DanD222/moduleur/modules/README.md

# BEFORE YOU BUILD

👉 Make sure you read the full [build guide](https://github.com/shmoergh/moduleur/wiki) thoroughly before you start building the Moduleur.

# BOM

Each module has a dedicated BOM. We also created a full BOM if you want to order all modules at once:

- [Full BOM](https://docs.google.com/spreadsheets/d/1Qo4ZxYgp-tBQ1XDLqPfu5fhcQhO-8mitsnlWUWIVU-8/edit?usp=sharing) — Contains only the BOM for the modules. For the enclosure, check the [enclosure BOM](https://github.com/shmoergh/moduleur/blob/main/enclosure/enclosure-bom.csv).
- [Mouser cart](https://www.mouser.com/Tools/SavedCart/Share?AccessID=7d2d54395b) — Last update: 24 Jan 2026

---

### Recommended build order

1. [PSU](https://github.com/shmoergh/moduleur/tree/main/modules/01-psu)
2. [VCO](https://github.com/shmoergh/moduleur/tree/main/modules/02-vco)
3. [Mixer & sidechain compressor](https://github.com/shmoergh/moduleur/tree/main/modules/03-sidechain-mixer)
4. [VCF](https://github.com/shmoergh/moduleur/tree/main/modules/04-vcf)
5. [ADSR & VCA](https://github.com/shmoergh/moduleur/tree/main/modules/05-adsr-vca)
6. [Utils + Output](https://github.com/shmoergh/moduleur/tree/main/modules/06-utils-output)
7. [Brain](https://github.com/shmoergh/moduleur/tree/main/modules/07-brain)
8. [Default Patch](https://github.com/shmoergh/moduleur/tree/main/modules/08-default-patch)
