DanD222/moduleur/modules/08-default-patch/README.md

# Hog Moduleur / Default Patch

An optional passive PCB which connects the modules of the Shmøergh Moduleur. This essentially creates a default patch which makes the Moduleur playable without patch cables.

## How to Build

[**Follow the build guide &rarr;**](https://www.shmoergh.com/moduleur-build-guide)

<br>

## Module specific instructions

### 🐛 3D model bug in schematics

The current version of the 3D model has two bugs: 

1. It incorrectly uses dual row headers. Single row, **long** pin headers should be used on the BACK side of the PCB so that it can connect to the UI board through the holes on the Core board.
2. The side of the ADSR+VCA1, ADSR+VCA2 and UTILS pin headers are wrong. All pin headers should be soldered on the BACK side of the PCB.



<br>

## License

Open source licensed under [CC BY-NC 4.0](https://creativecommons.org/licenses/by-nc/4.0/).

Feel free to fork, build, and tweak.

[Disclaimer](https://github.com/shmoergh/moduleur/blob/main/DISCLAIMER.md)

## Latest module version

v1.0
