DanD222/moduleur/modules/01-psu/electronics/production/bom.csv

Designator | Footprint | Quantity | Value | LCSC Part #
D1, D3, D4 | LED_D3.0mm | 3 | LED
D2 | D_DO-201AD_P15.24mm_Horizontal | 1 | 1N5822
D5 | D_DO-201AE_P15.24mm_Horizontal | 1 | 1.5KE36A
IC1 | Converter_DCDC_MeanWell_NSD10_DKMW_THT | 1 | ISOLATED_DC-DC_CONV
J1 | BarrelJack_Wuerth_6941xx301002 | 1 | Barrel_Jack_Switch
J2, J3, J4, J5 | IDC-Header_2x08_P2.54mm_Horizontal | 4 | Conn_02x08_Odd_Even
JP1 | SolderJumper-2_P1.3mm_Open_RoundedPad1.0x1.5mm | 1 | Jumper_2_Open
R1, R2, R3 | R_Axial_DIN0207_L6.3mm_D2.5mm_P7.62mm_Horizontal | 3 | 1k
S1 | SW_PB400EEQR1BLK | 1 | PB400EEQR1BLK
