DanD222/moduleur/modules/01-psu/electronics/schematics/psu.pdf

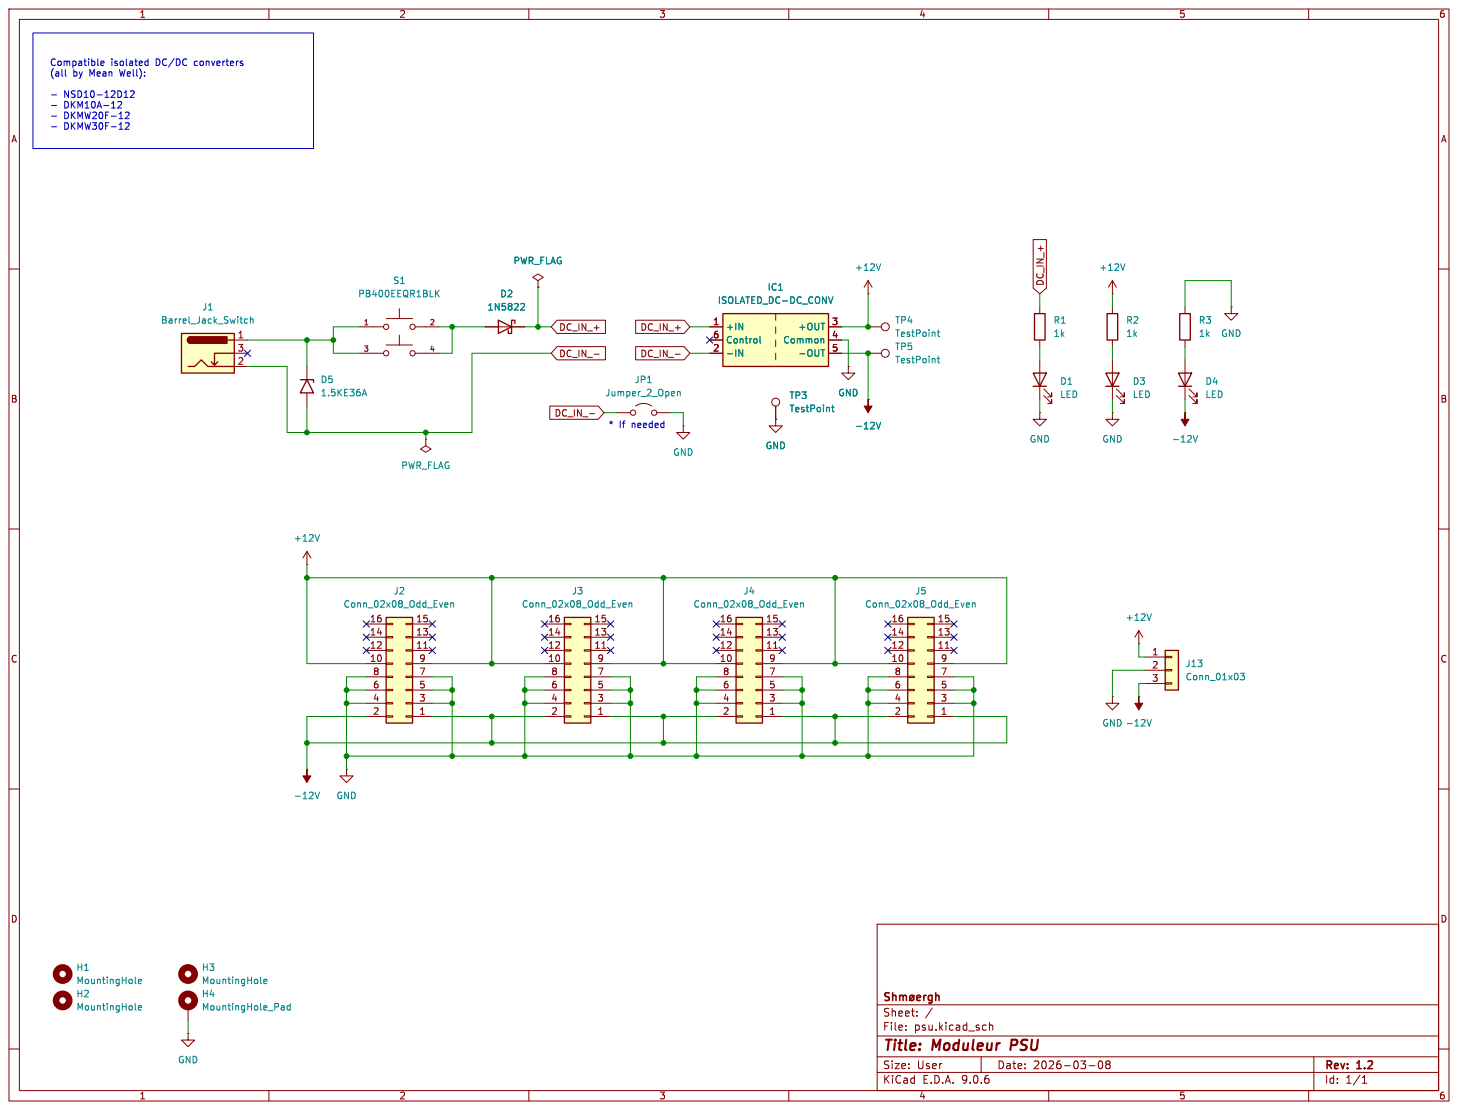
[picture p1: page 1]

(all by Mean Well): - NSD10-12D12

File: psu.kicad_sch Sheet: / þÿShmøergh

Id: 1/1 Title: Moduleur PSU
