DanD222/moduleur/modules/02-vco/electronics/core/schematics/vco-core.pdf

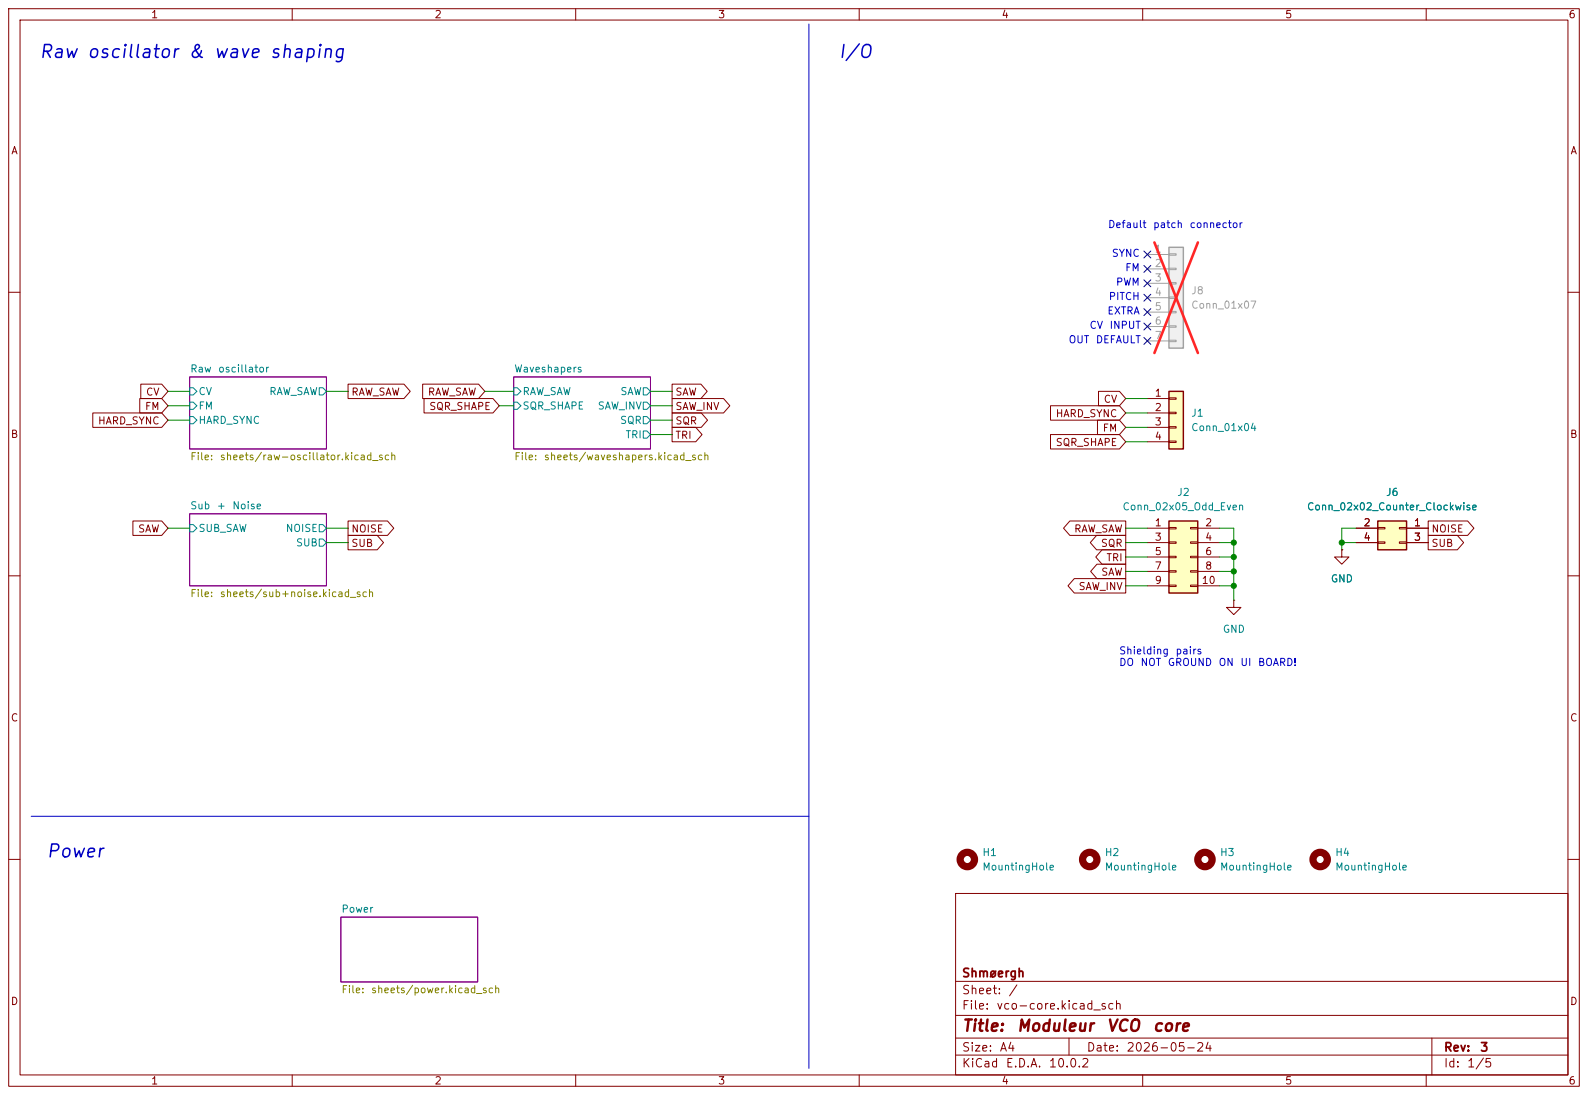
[picture p2: page 1]

TRI Waveshapers File: sheets/waveshapers.kicad_sch

File: sheets/sub+noise.kicad_sch Power File: sheets/power.kicad_sch

Shmøergh
Sheet: /
File: vco-core.kicad_sch
Title: Moduleur VCO core

Size: A4 | Rev: 3
KiCad E.D.A. 10.0.2 | Id: 1/5

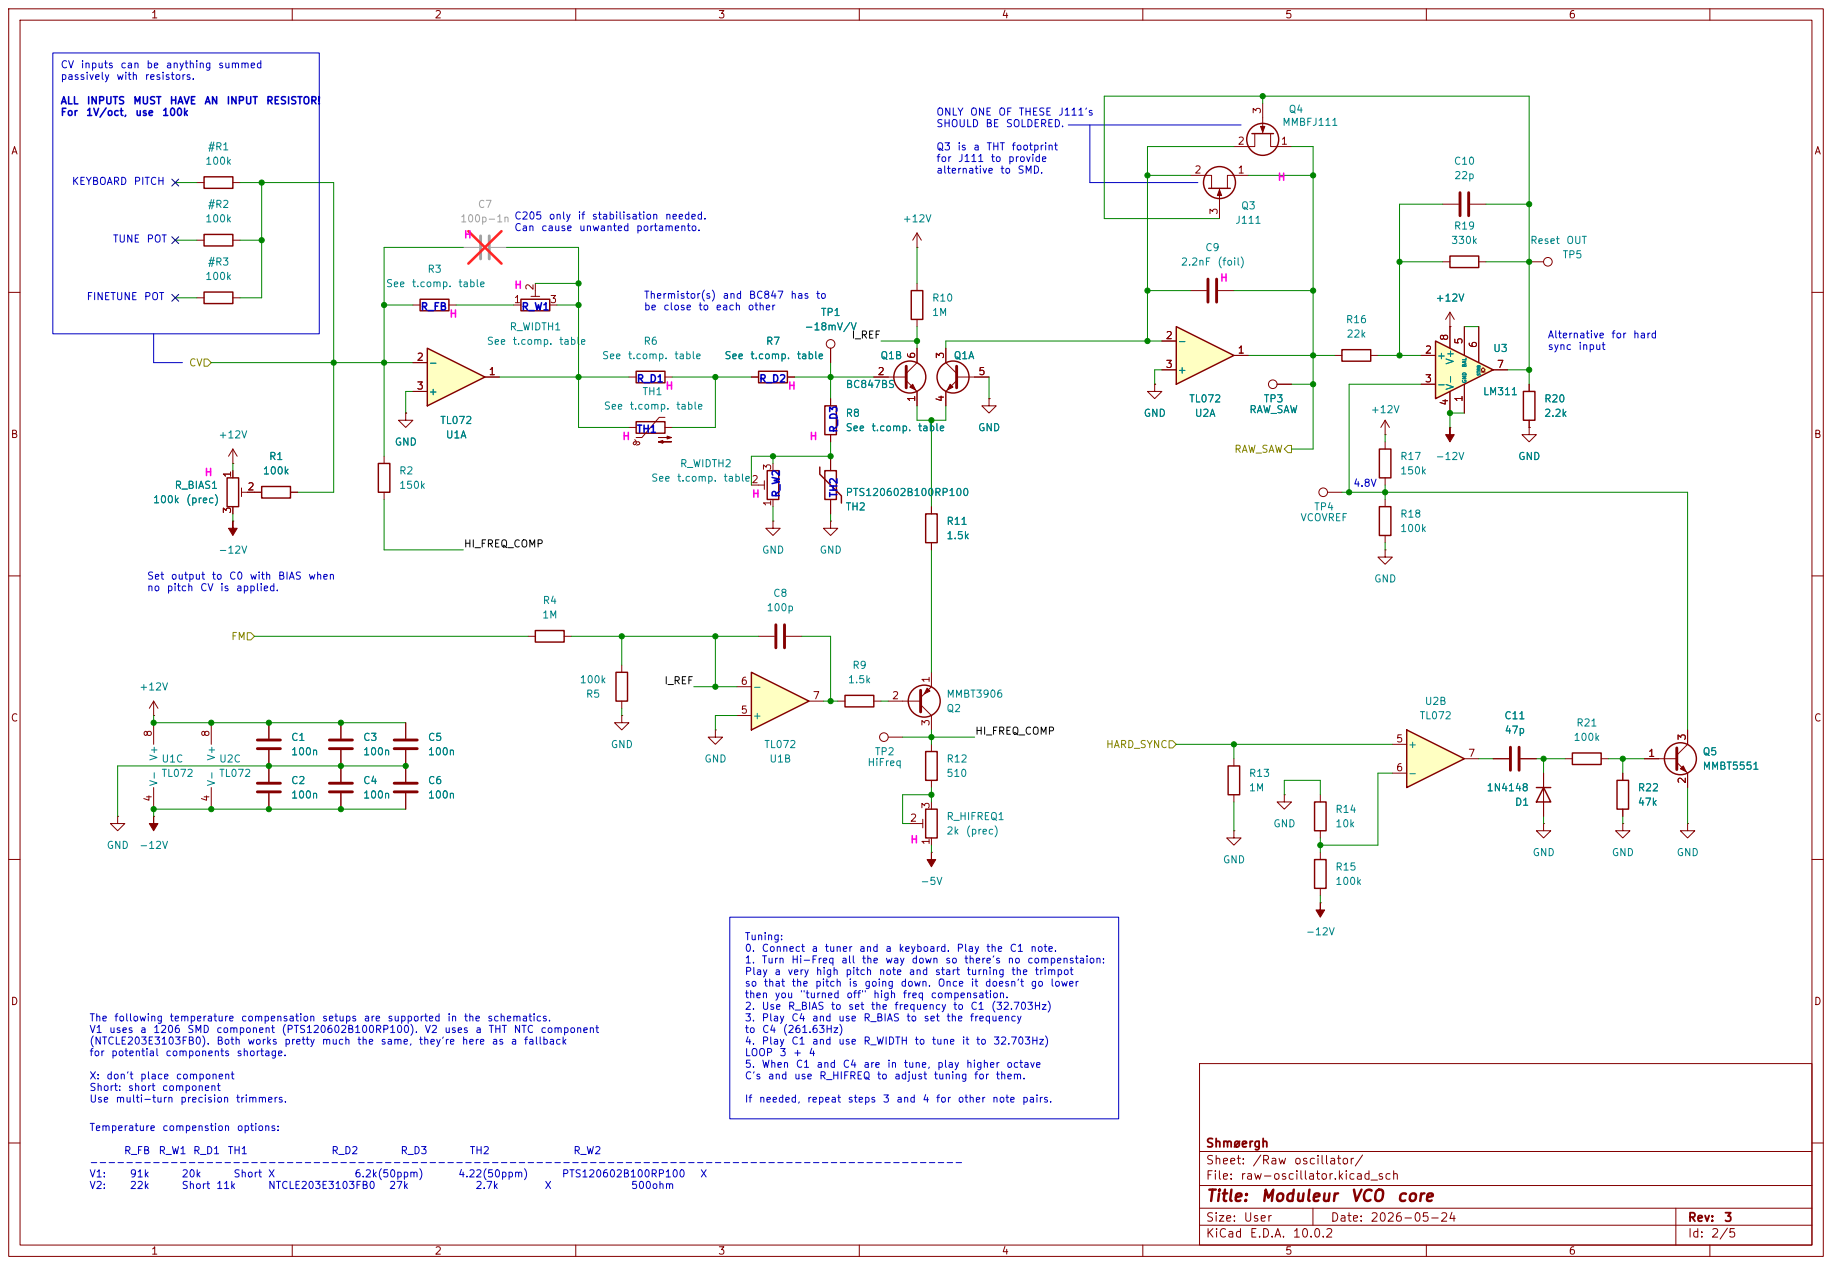
[picture p3: page 2]

TUNE POT ALL INPUTS MUST HAVE AN INPUT RESISTOR! For 1V/oct, use 100k

3Q4 MMBFJ111 R10
ONLY ONE OF THESE J111's SHOULD BE SOLDERED. Q3 is a THT footprint

C205 only if stabilisation needed. Can cause unwanted portamento.

Thermistor(s) and BC847 has to be close to each other Set output to C0 with BIAS when

See t.comp. table GND

Tuning: 0. Connect a tuner and a keyboard. Play the C1 note. 1. Turn Hi-Freq all the way down so there's no compenstaion:

Play a very high pitch note and start turning the trimpot so that the pitch is going down. Once it doesn't go lower

then you "turned off" high freq compensation. 2. Use R_BIAS to set the frequency to C1 (32.703Hz) 3. Play C4 and use R_BIAS to set the frequency

The following temperature compensation setups are supported in the schematics. V1 uses a 1206 SMD component (PTS120602B100RP100). V2 uses a THT NTC component

to C4 (261.63Hz) 4. Play C1 and use R_WIDTH to tune it to 32.703Hz) LOOP 3 + 4

(NTCLE203E3103FB0). Both works pretty much the same, they're here as a fallback
for potential components shortage. X: don't place component Short: short component Use multi-turn precision trimmers.

5. When C1 and C4 are in tune, play higher octave C's and use R_HIFREQ to adjust tuning for them.

If needed, repeat steps 3 and 4 for other note pairs.

Shmøergh
Sheet: /Raw oscillator/
File: raw-oscillator.kicad_sch
Title: Moduleur VCO core

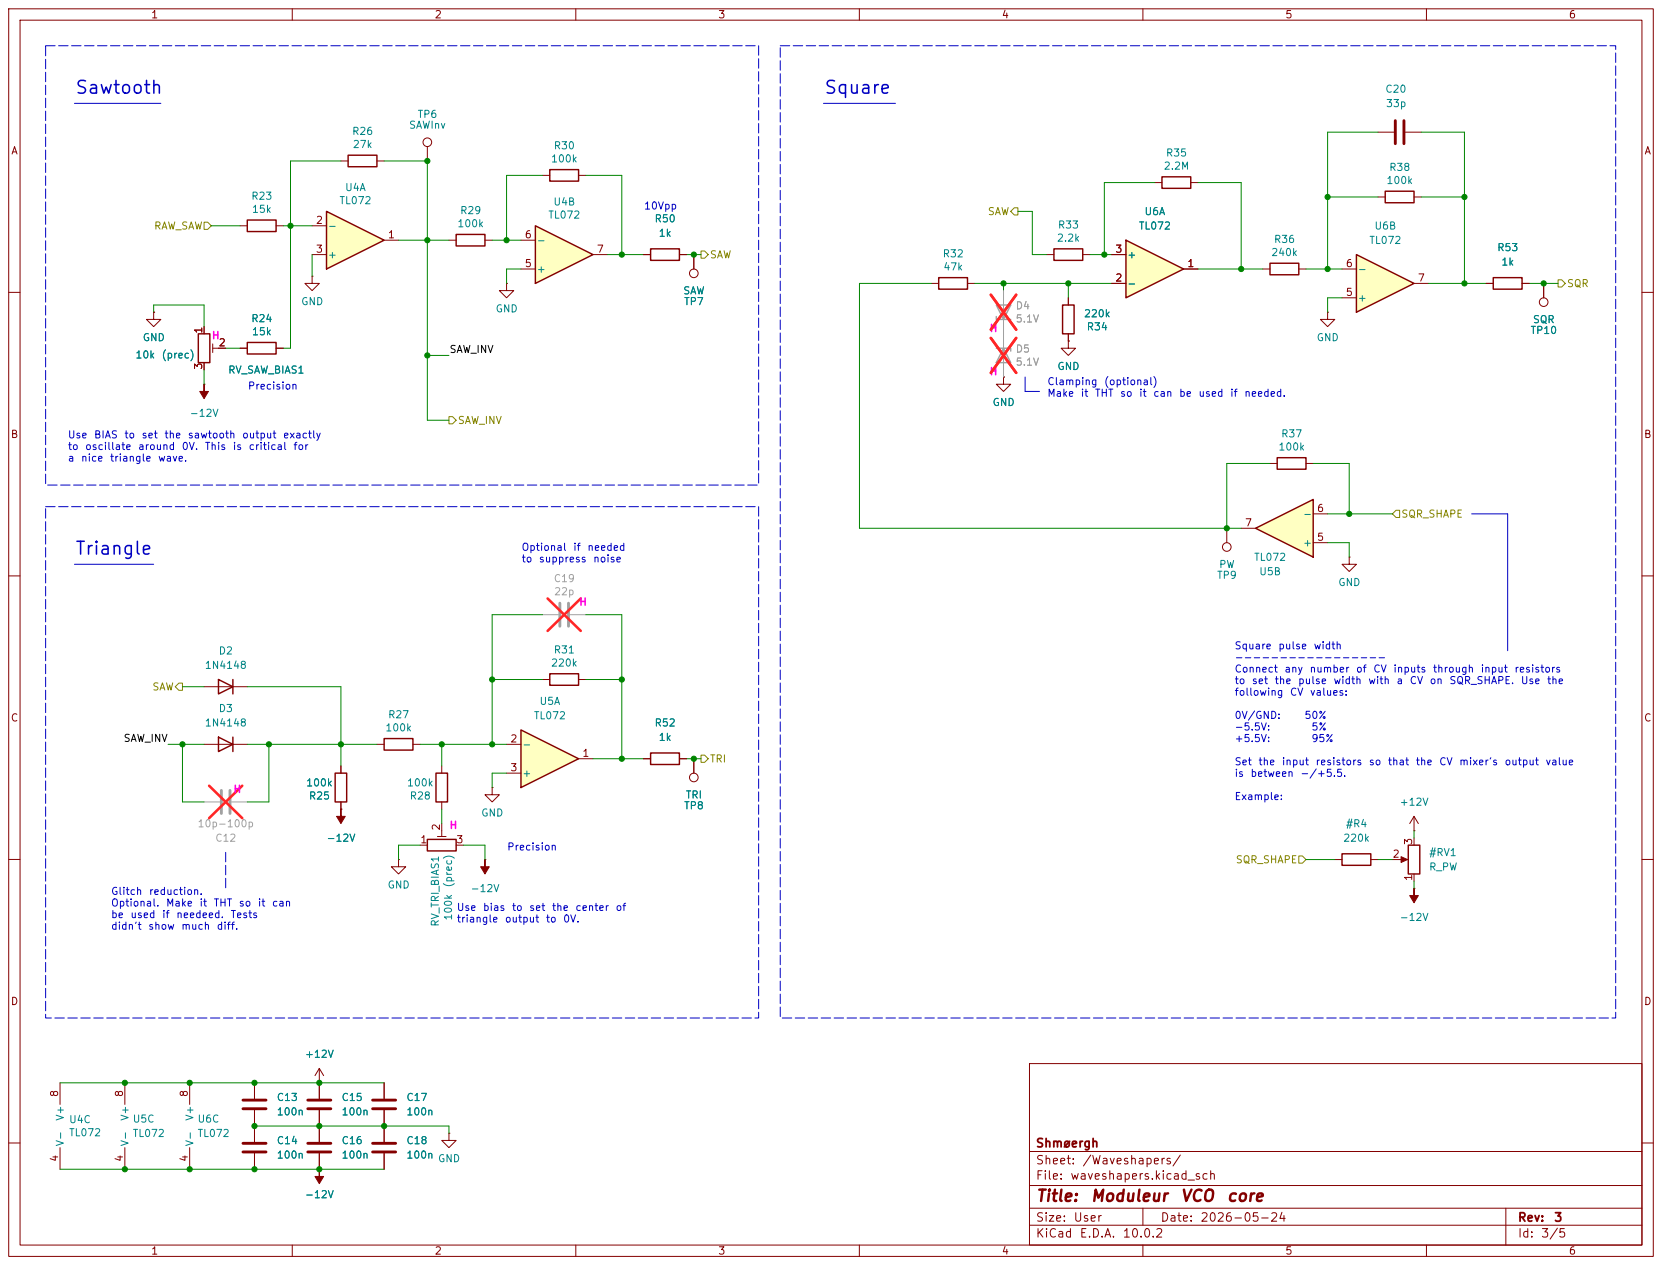
[picture p4: page 3]

Clamping (optional) Make it THT so it can be used if needed. Square pulse width -----------------

Use BIAS to set the sawtooth output exactly

Connect any number of CV inputs through input resistors
to set the pulse width with a CV on SQR_SHAPE. Use the

Set the input resistors so that the CV mixer's output value
is between -/+5.5.

Use bias to set the center of
triangle output to 0V.

Shmøergh
Sheet: /Waveshapers/
File: waveshapers.kicad_sch
Title: Moduleur VCO core

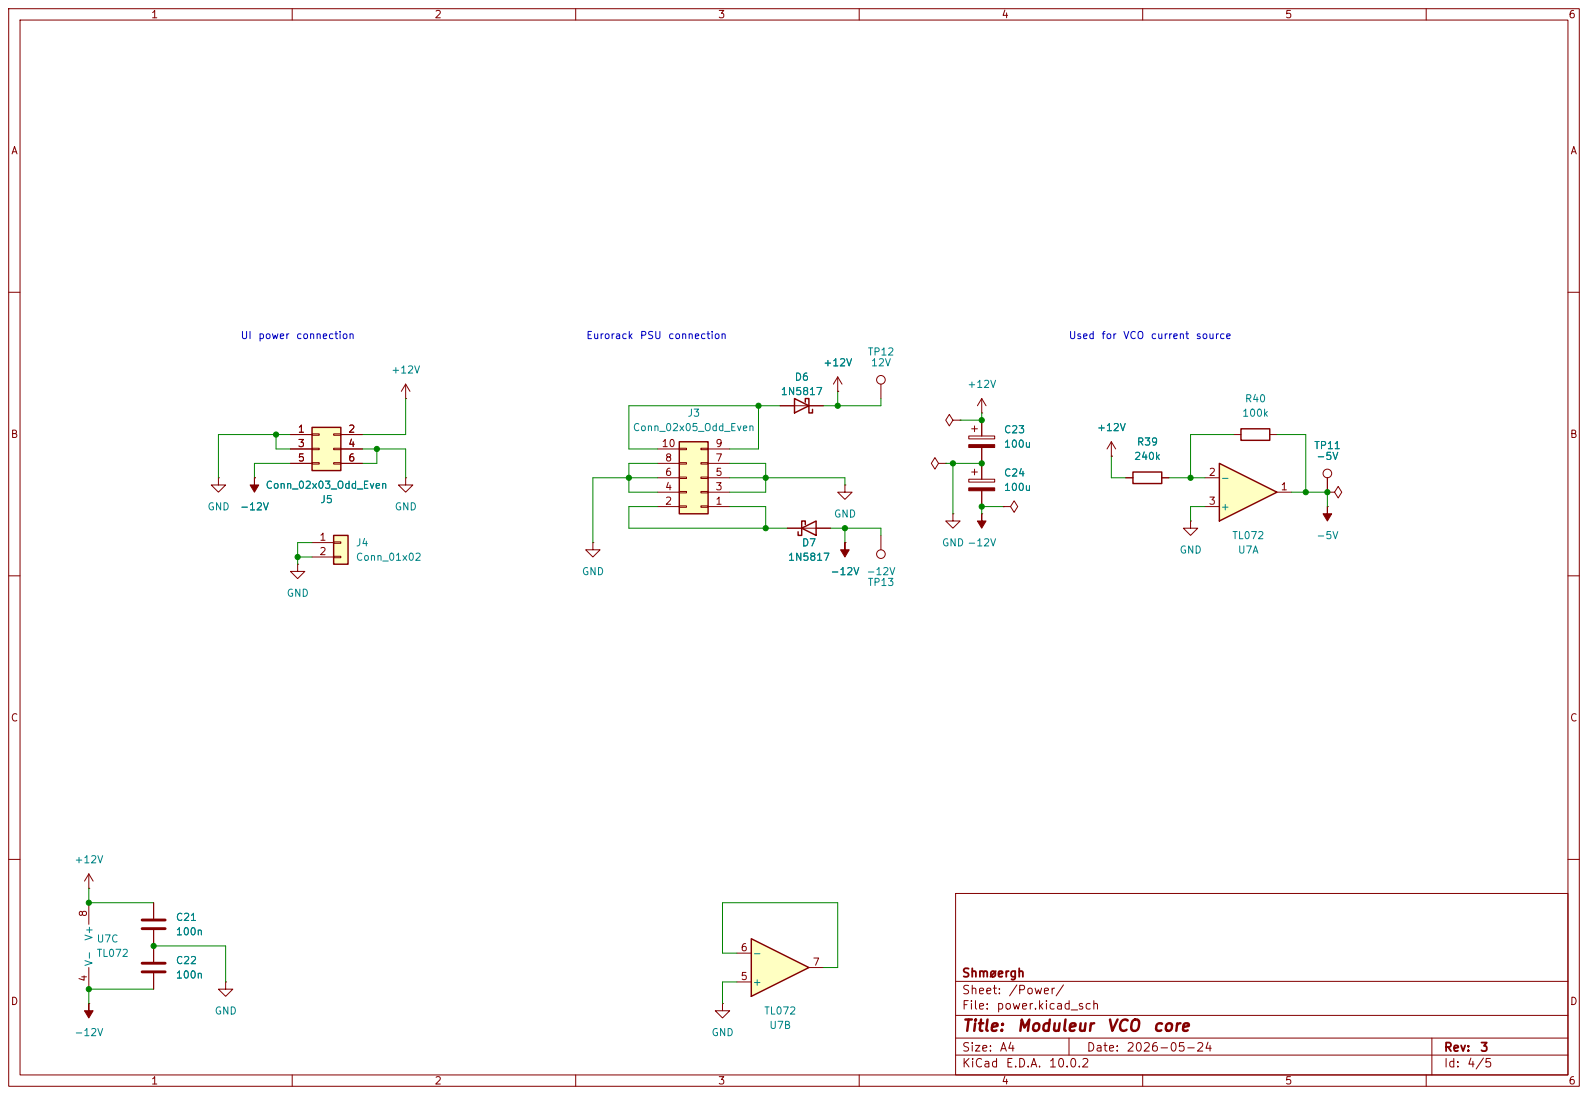
[picture p5: page 4]

Sheet: /Power/
File: power.kicad_sch
Title: Moduleur VCO core

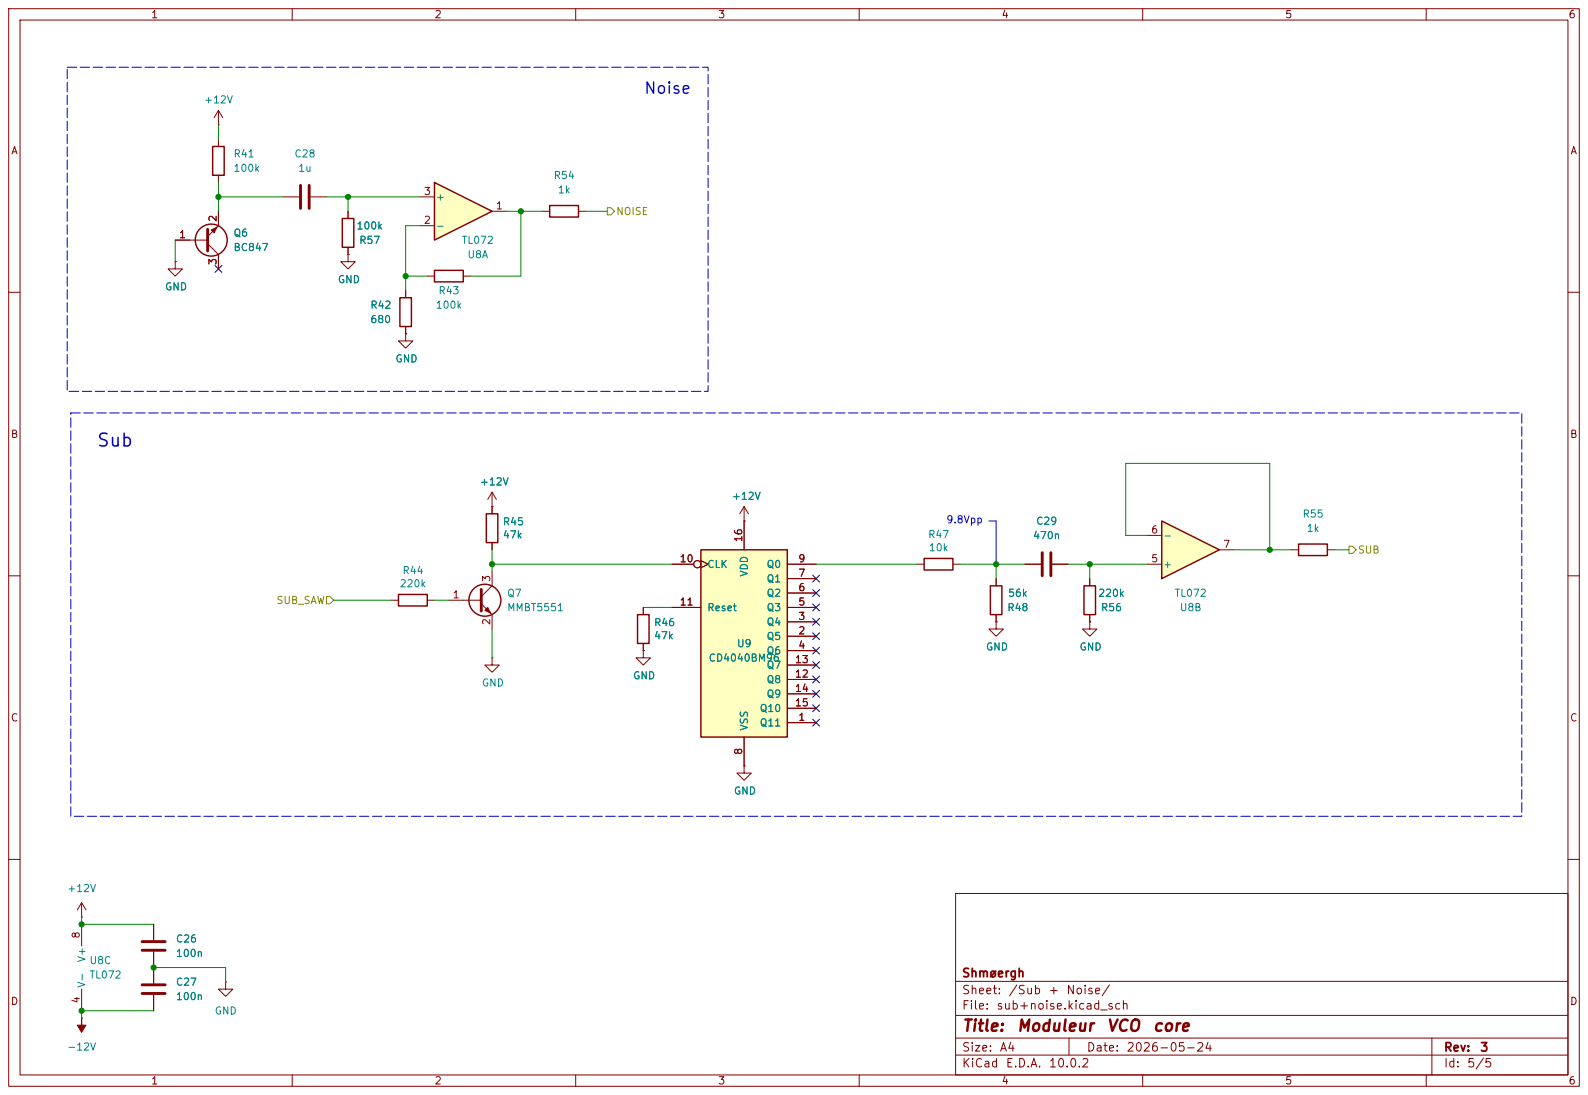
[picture p6: page 5]

8 Q0 9 CLK 10 Reset 11 Q8 12 Q7 13 Q9 14 Q10 15 VDD 16 +12V GND

Shmøergh
Sheet: /Sub + Noise/
File: sub+noise.kicad_sch
Title: Moduleur VCO core
