DanD222/moduleur/modules/04-vcf/electronics/core/schematics/vcf-core.pdf

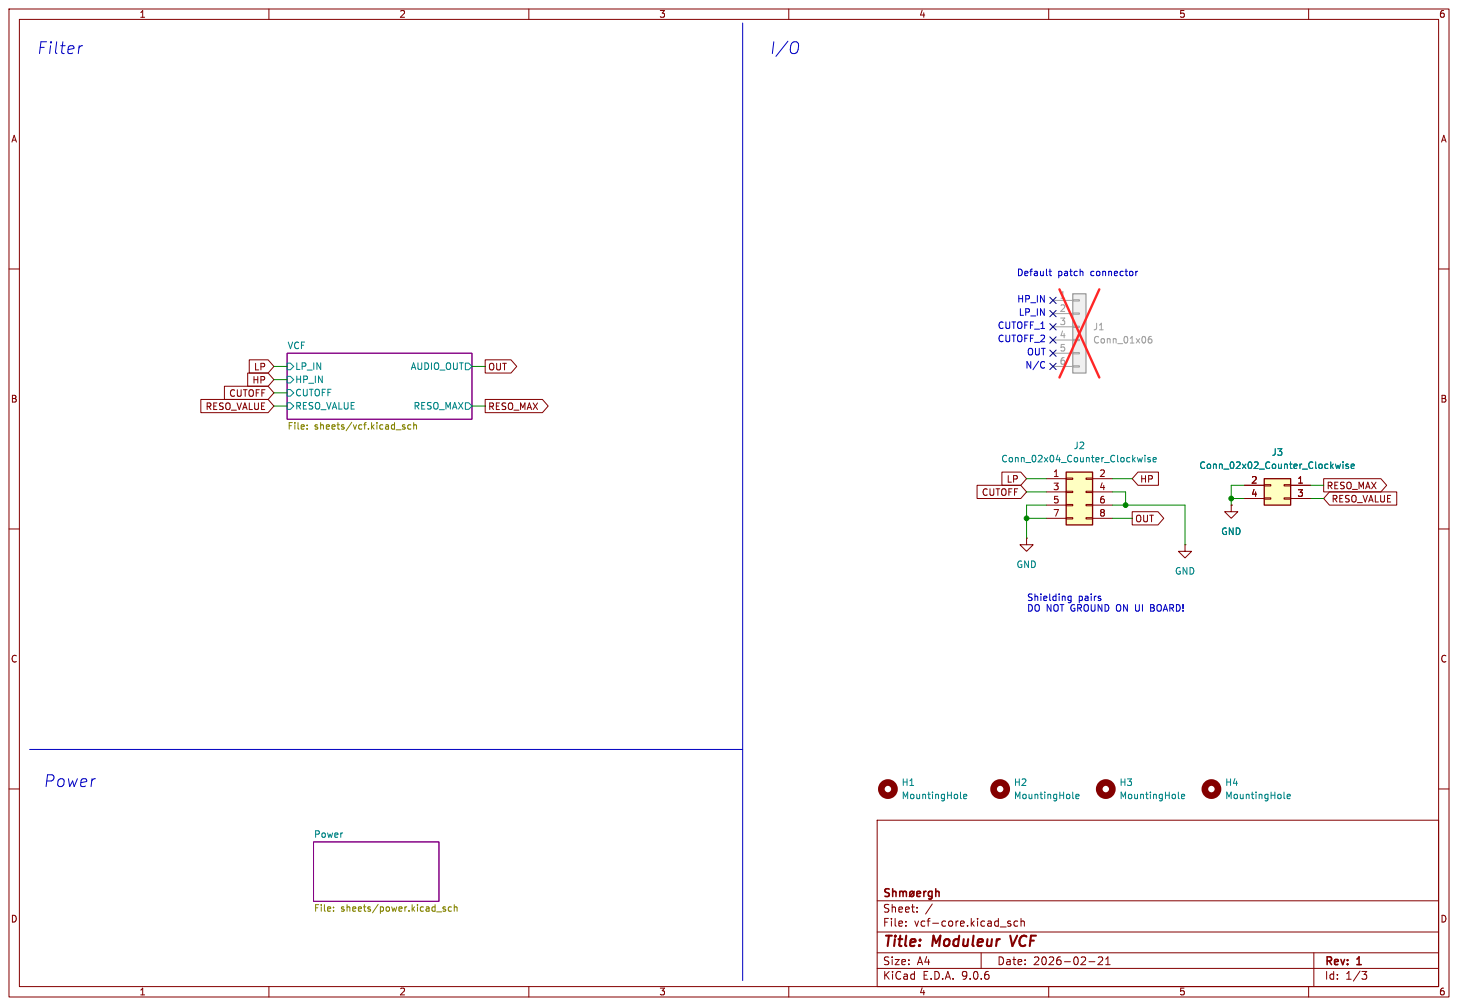
[picture p12: page 1]

Default patch connector Power

Power File: sheets/power.kicad_sch

File: vcf-core.kicad_sch Sheet: / þÿShmøergh

Id: 1/3 Title: Moduleur VCF

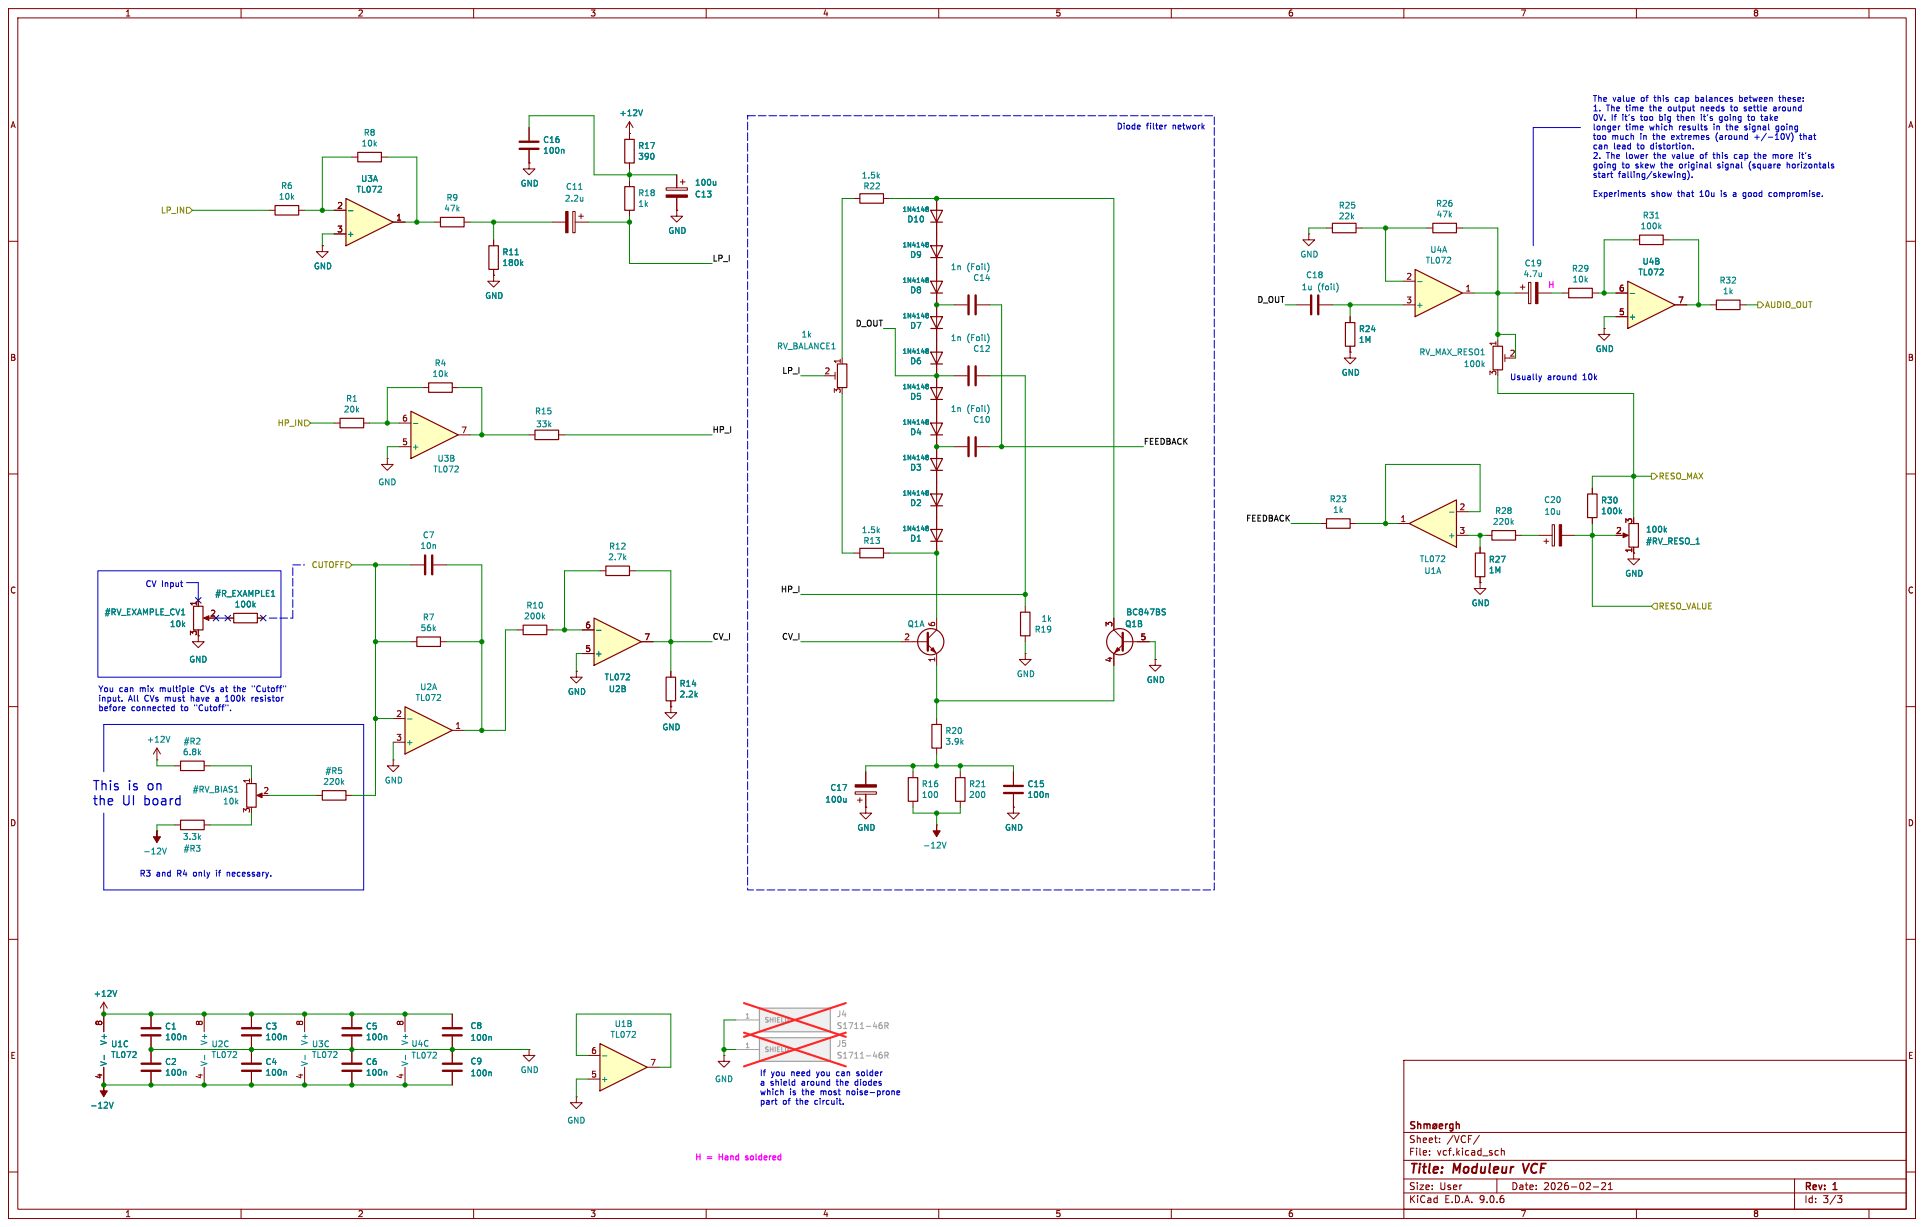
[picture p13: page 2]

0V. If it's too big then it's going to take
longer time which results in the signal going

Usually around 10k This is on

File: vcf.kicad_sch Sheet: /VCF/ þÿShmøergh C15

If you need you can solder a shield around the diodes which is the most noise-prone

part of the circuit.

Id: 3/3 Title: Moduleur VCF

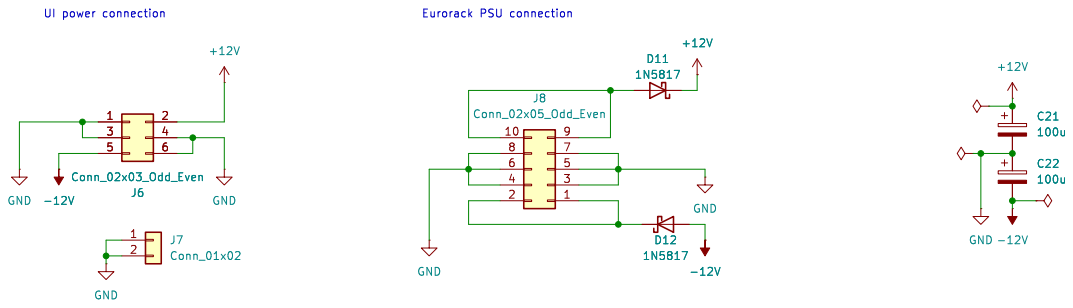
[picture p14: page 3]

Id: 4/3 Title: Moduleur VCF
