DanD222/moduleur/modules/04-vcf/electronics/ui/schematics/vcf-ui.pdf

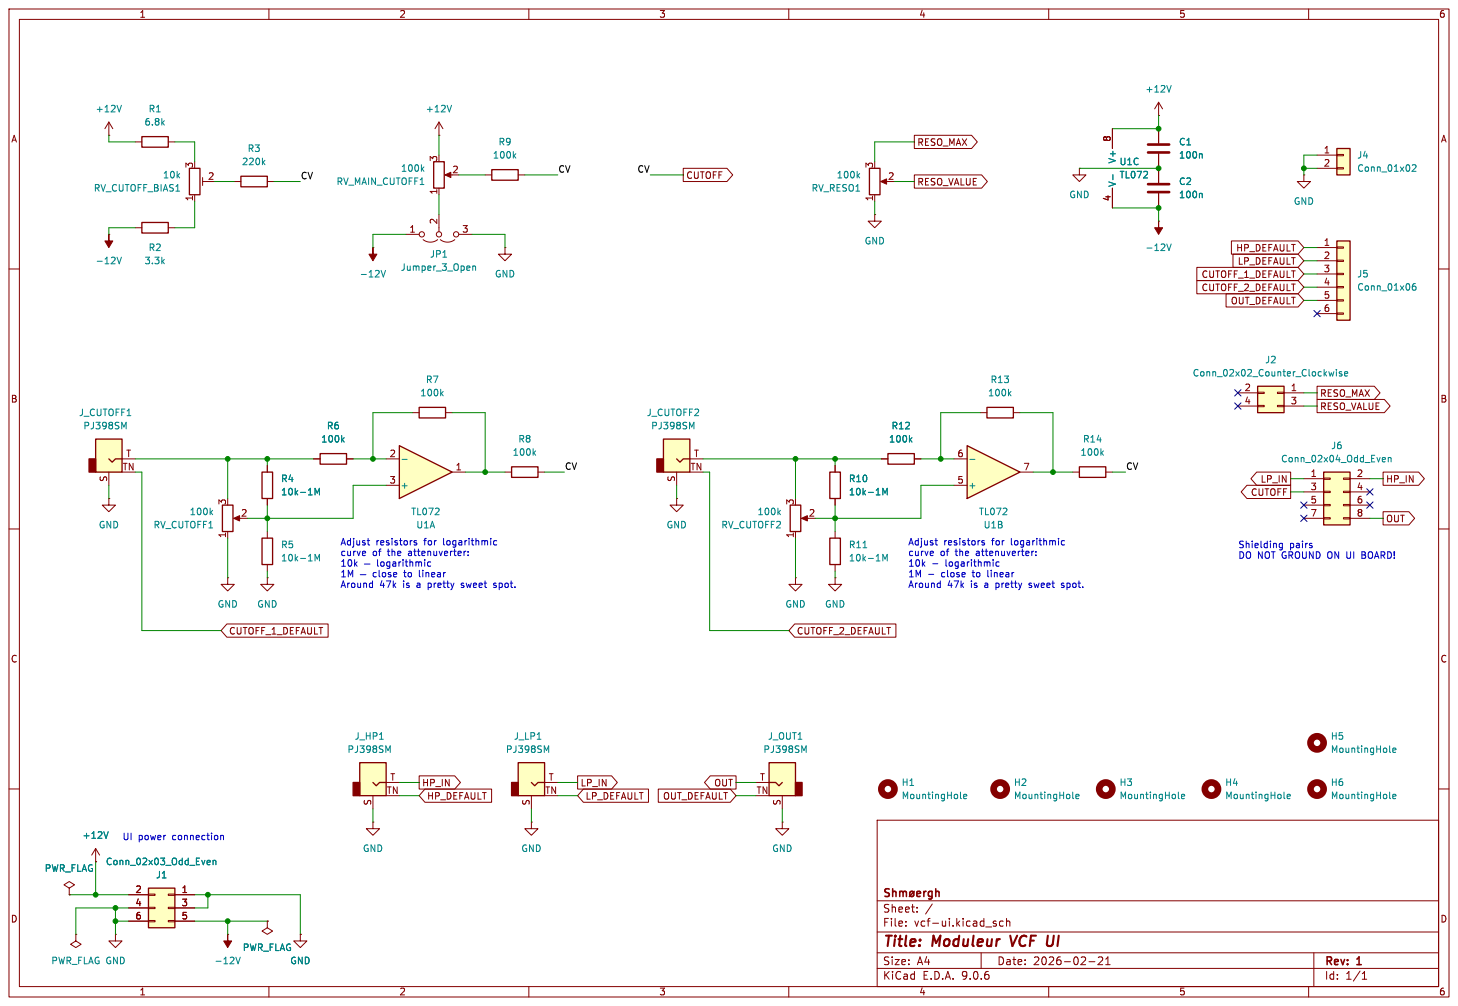
[picture p15: page 1]

curve of the attenuverter: 10k þÿ logarithmic 1M þÿ close to linear Around 47k is a pretty sweet spot. R4

Id: 1/1 Title: Moduleur VCF UI File: vcf-ui.kicad_sch Sheet: / þÿShmøergh GND
