DanD222/moduleur/modules/05-adsr-vca/electronics/core/schematics/adsr-vca-core.pdf

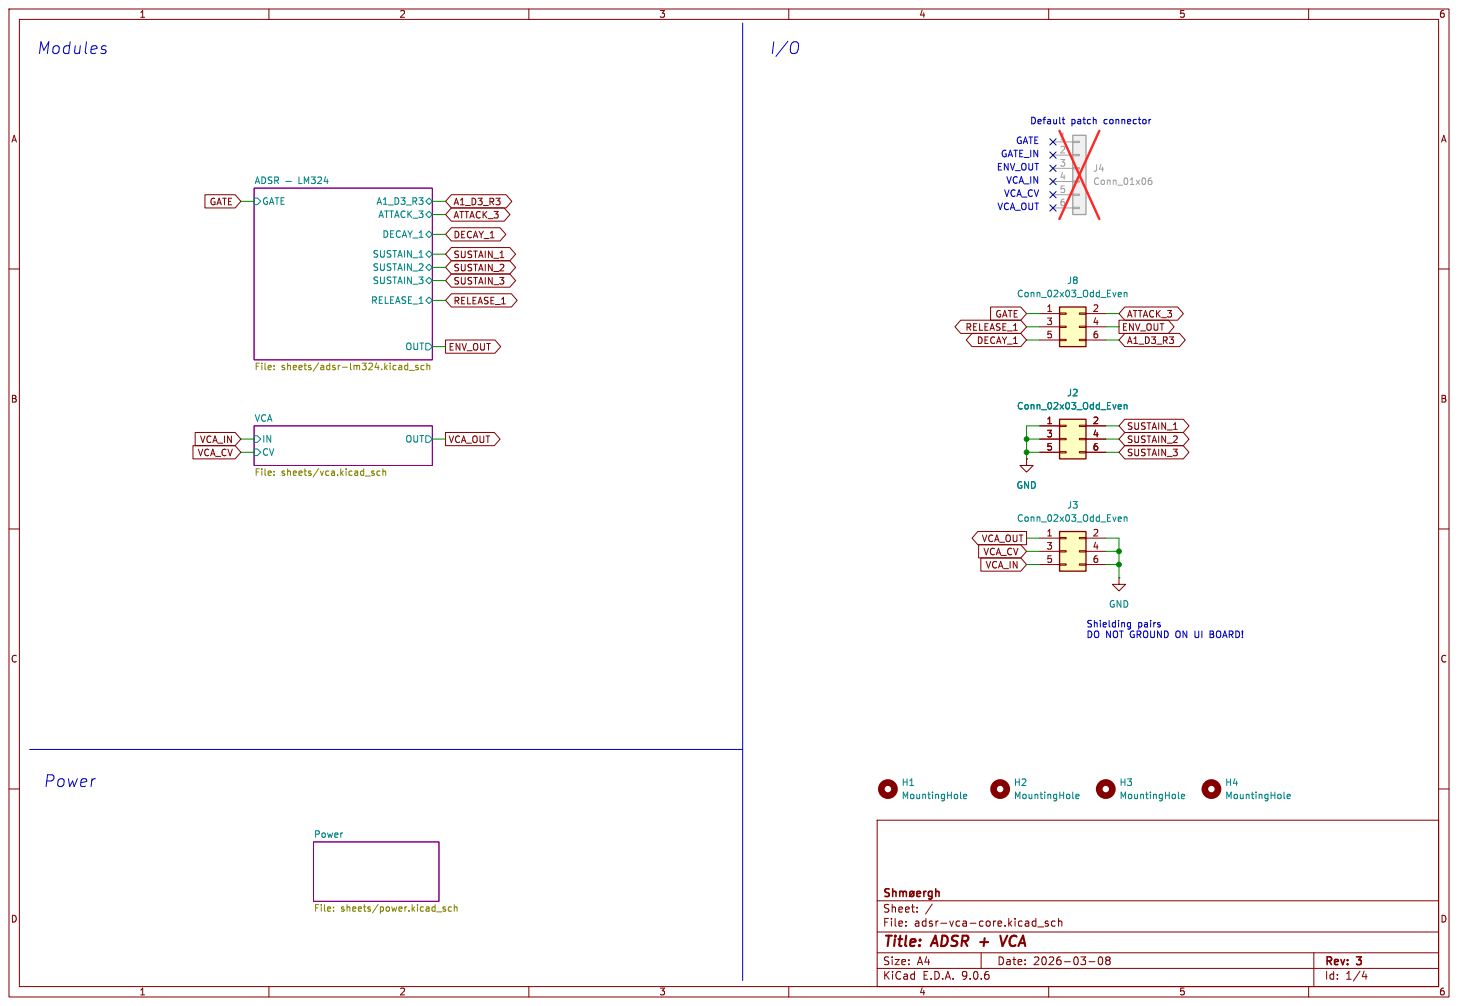
[picture p16: page 1]

File: sheets/vca.kicad_sch Power File: sheets/power.kicad_sch

File: adsr-vca-core.kicad_sch Sheet: / þÿShmøergh CV

Id: 1/4 Title: ADSR + VCA

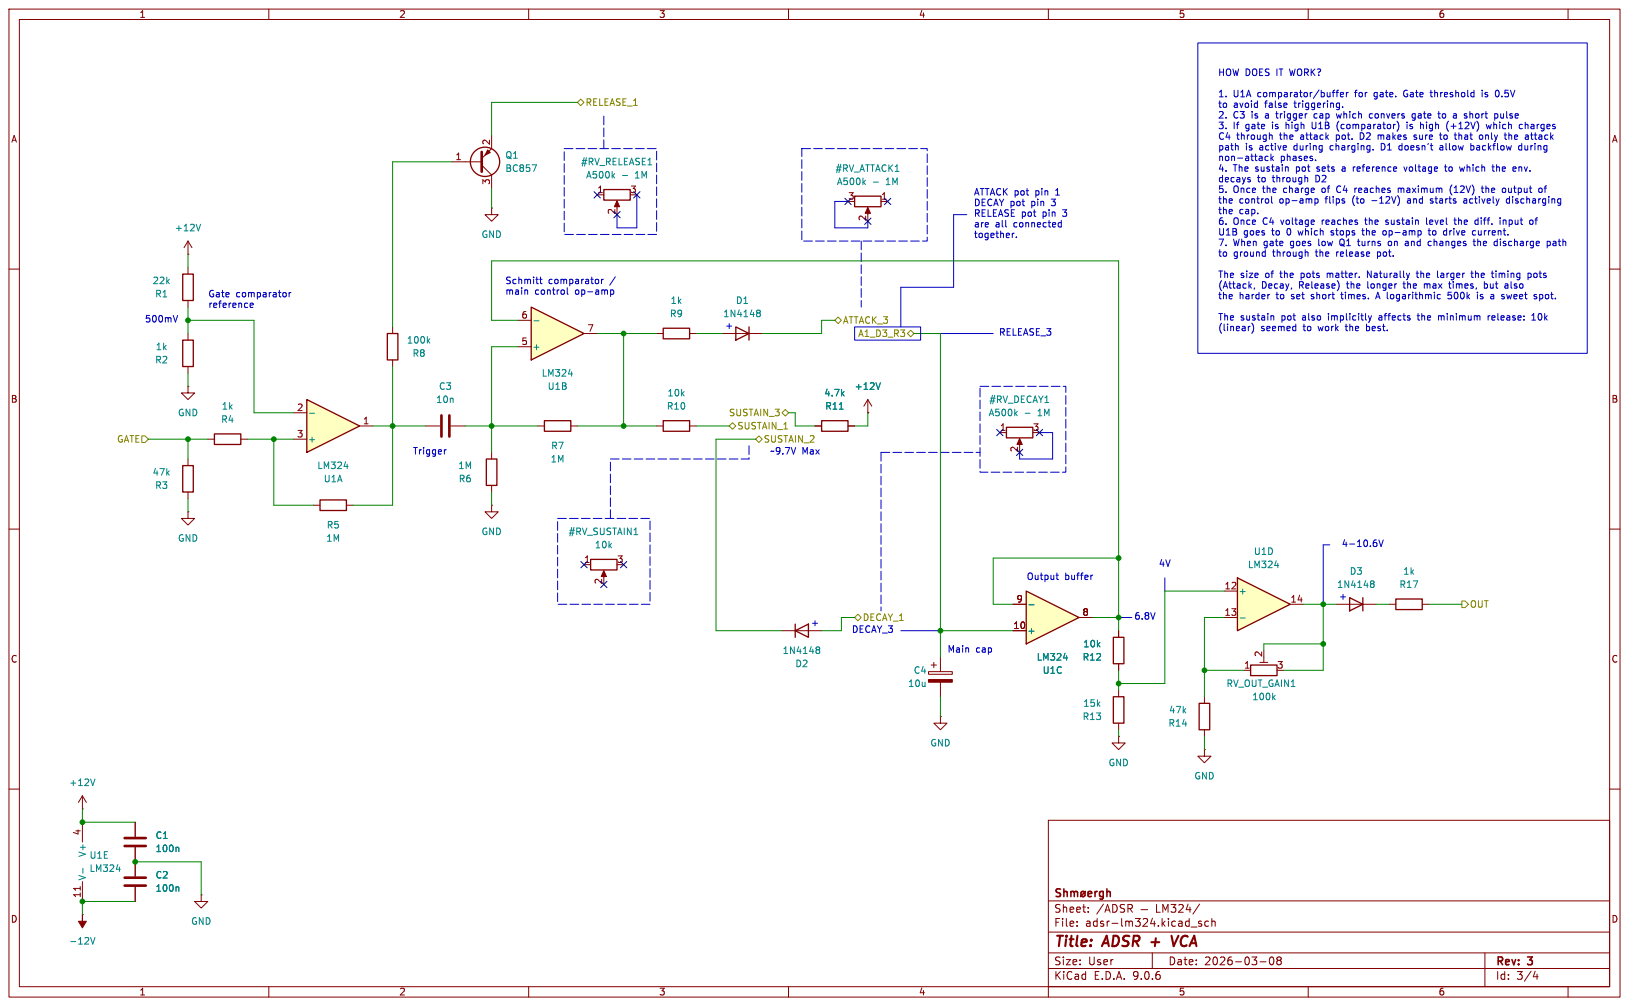
[picture p17: page 2]

HOW DOES IT WORK?
together. DECAY_3

to avoid false triggering. 2. C3 is a trigger cap which convers gate to a short pulse

(Attack, Decay, Release) the longer the max times, but also

Id: 3/4 Title: ADSR + VCA

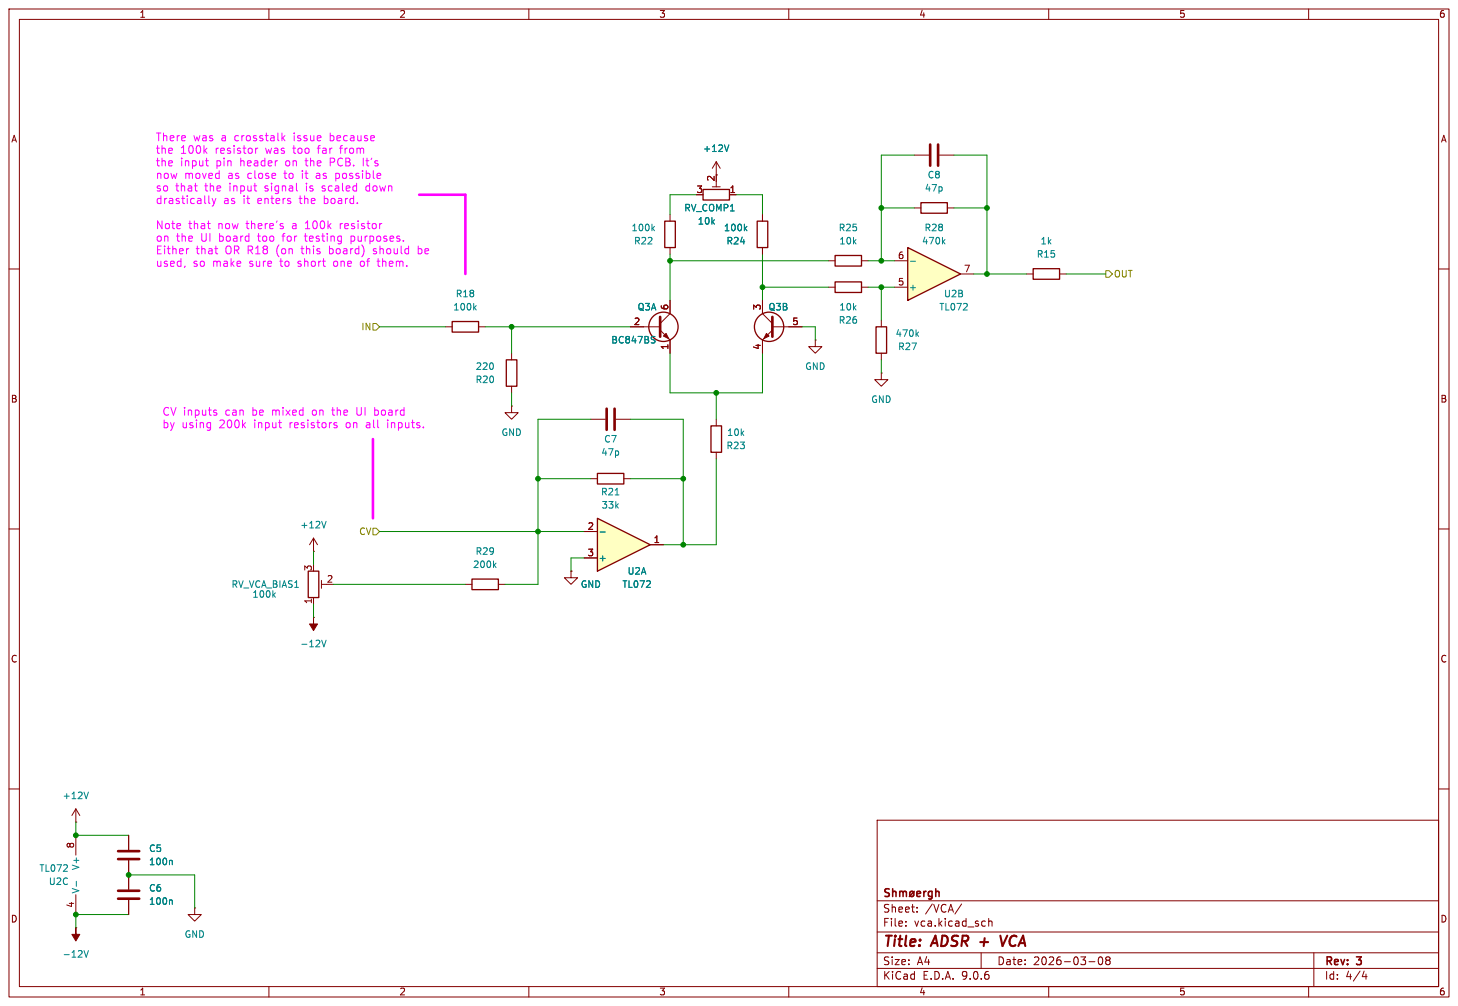
[picture p18: page 3]

File: vca.kicad_sch Sheet: /VCA/ þÿShmøergh GND

used, so make sure to short one of them. CV inputs can be mixed on the UI board

Id: 4/4 Title: ADSR + VCA

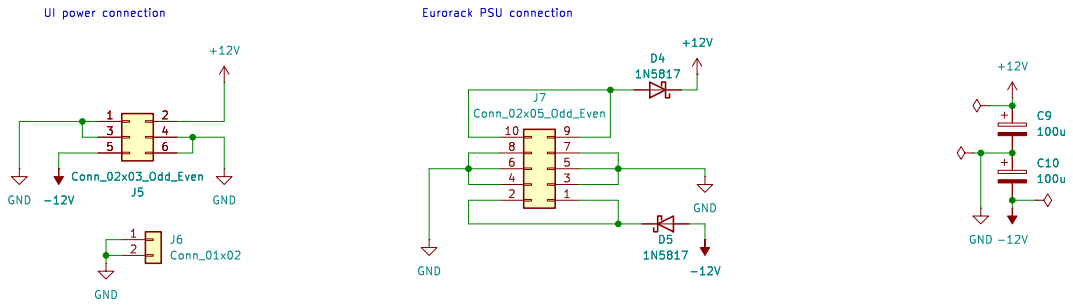
[picture p19: page 4]

Id: 4/4 Title: ADSR + VCA
