DanD222/moduleur/modules/06-utils-output/electronics/core/schematics/utils-output-core.pdf

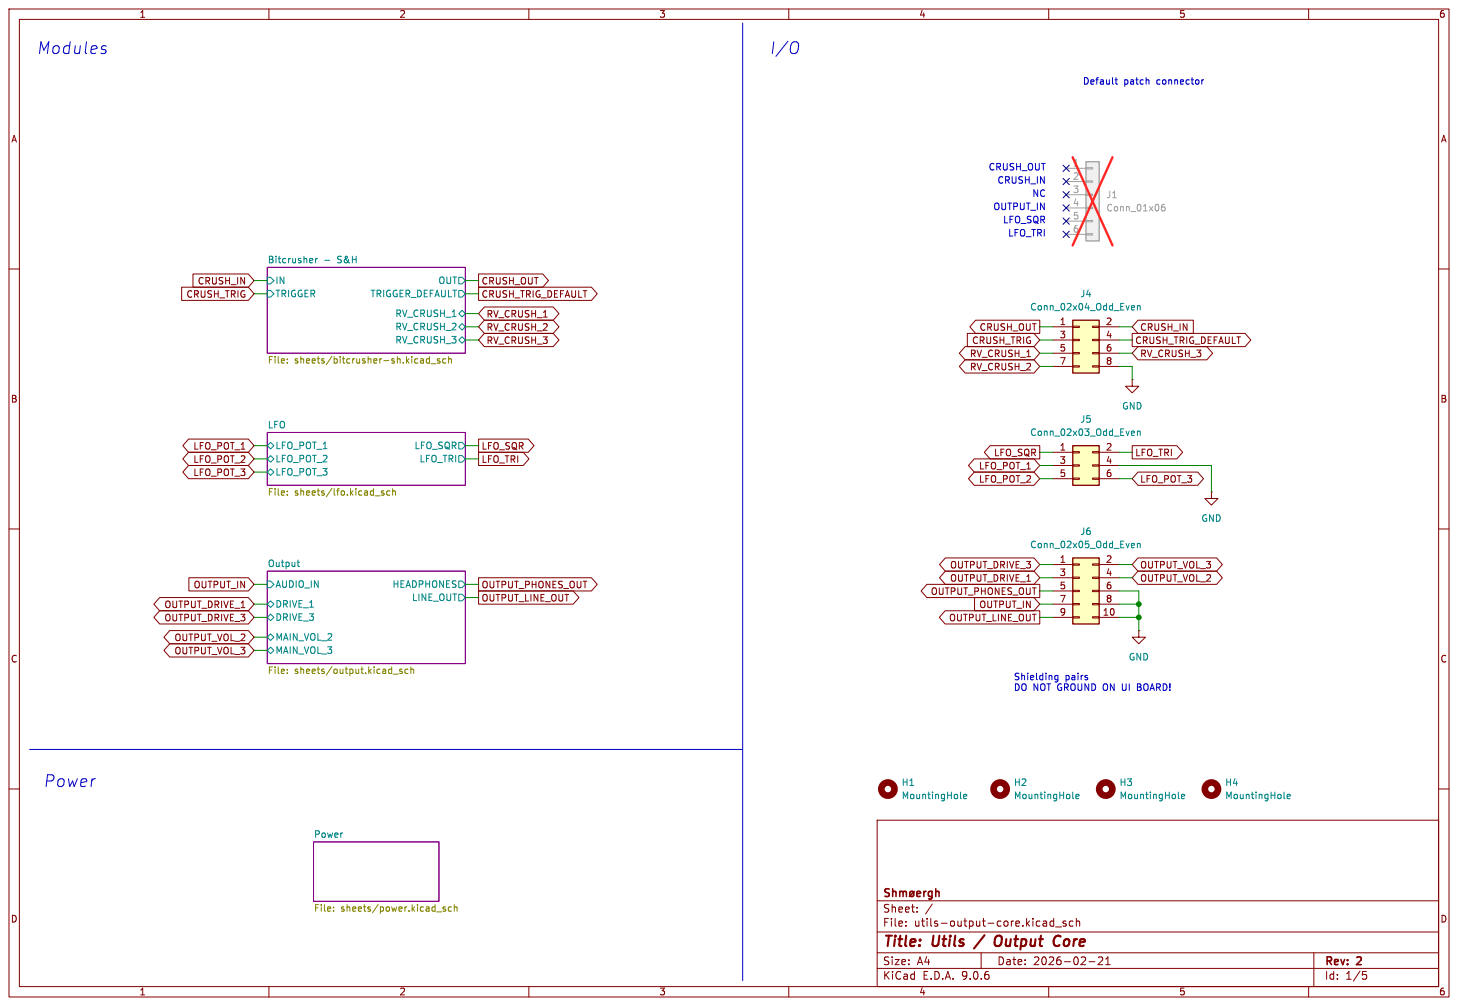
[picture p20: page 1]

Power File: sheets/power.kicad_sch AUDIO_IN

File: sheets/bitcrusher-sh.kicad_sch

LINE_OUT MAIN_VOL_2 DRIVE_3 MAIN_VOL_3 Output File: sheets/output.kicad_sch

File: utils-output-core.kicad_sch Sheet: / þÿShmøergh

Id: 1/5 Title: Utils / Output Core

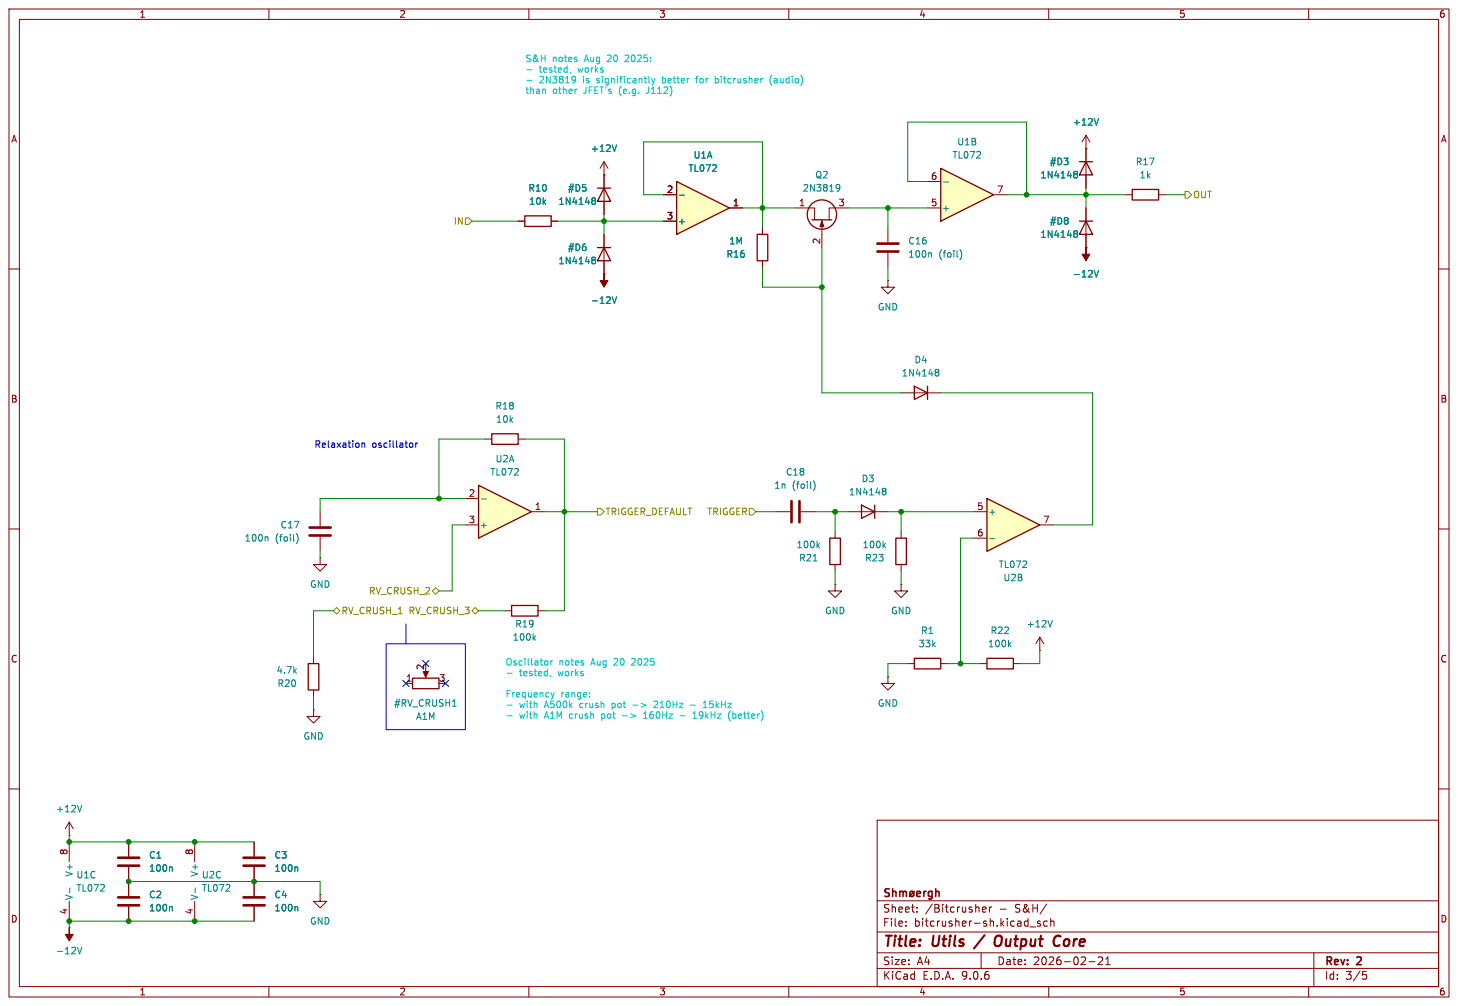
[picture p21: page 2]

S&H notes Aug 20 2025: - tested, works

Id: 3/5 Title: Utils / Output Core

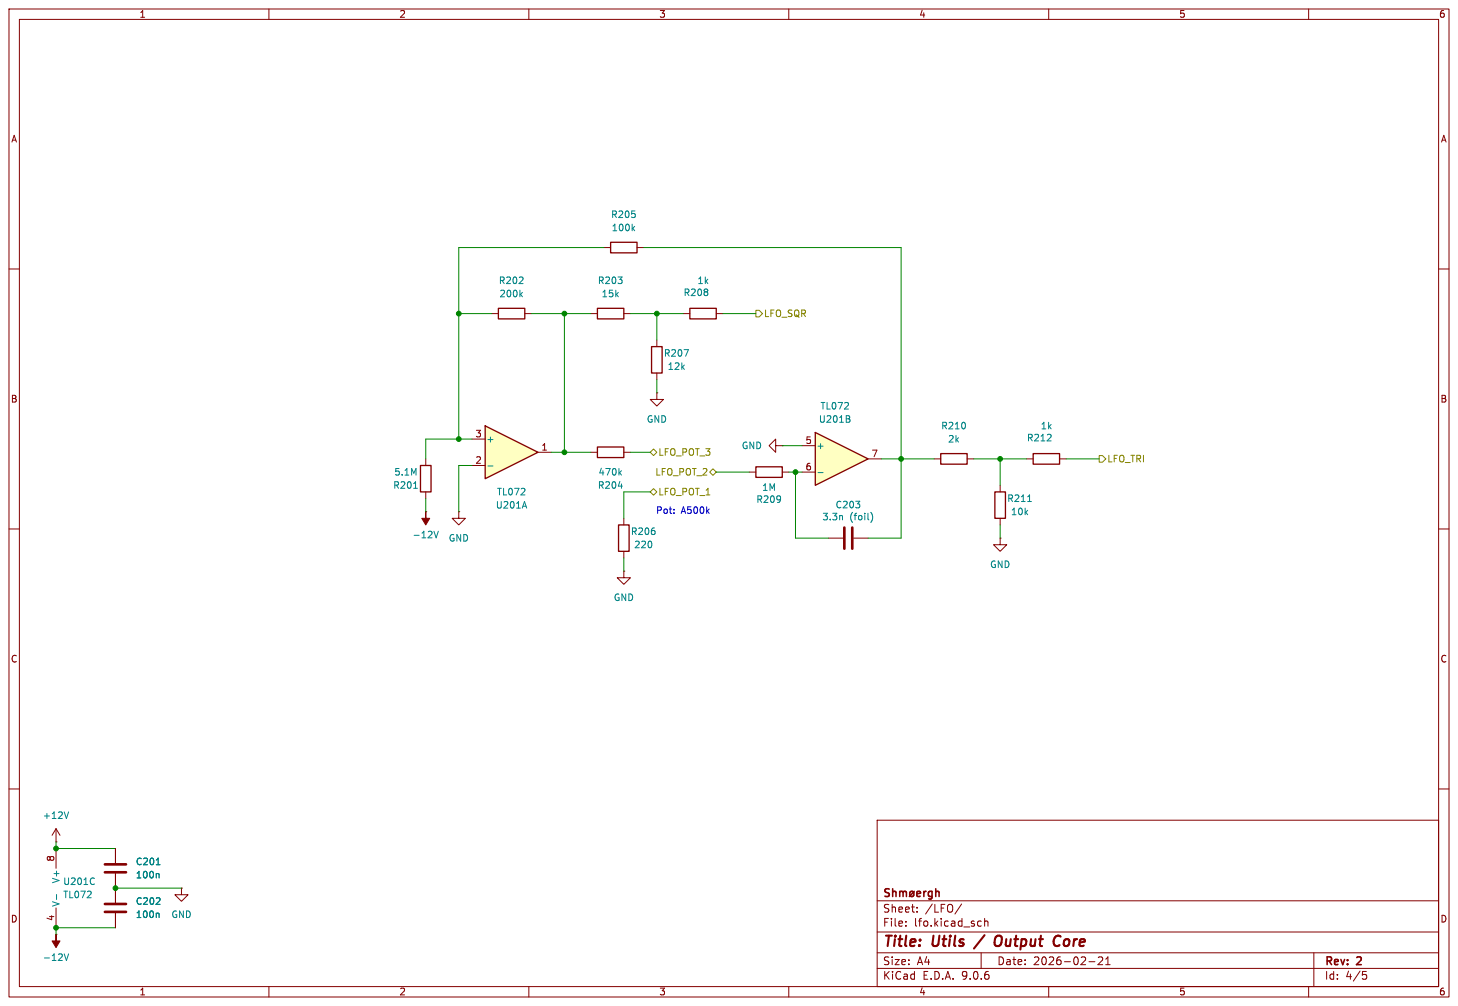
[picture p22: page 3]

File: lfo.kicad_sch Sheet: /LFO/ þÿShmøergh

Id: 4/5 Title: Utils / Output Core

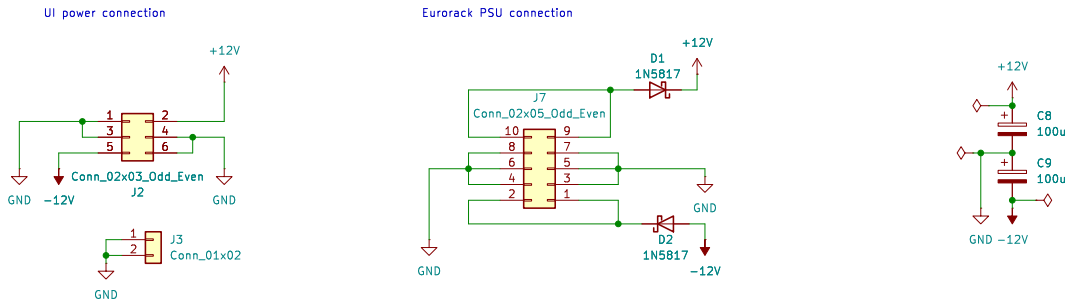
[picture p23: page 4]

Id: 4/5 Title: Utils / Output Core

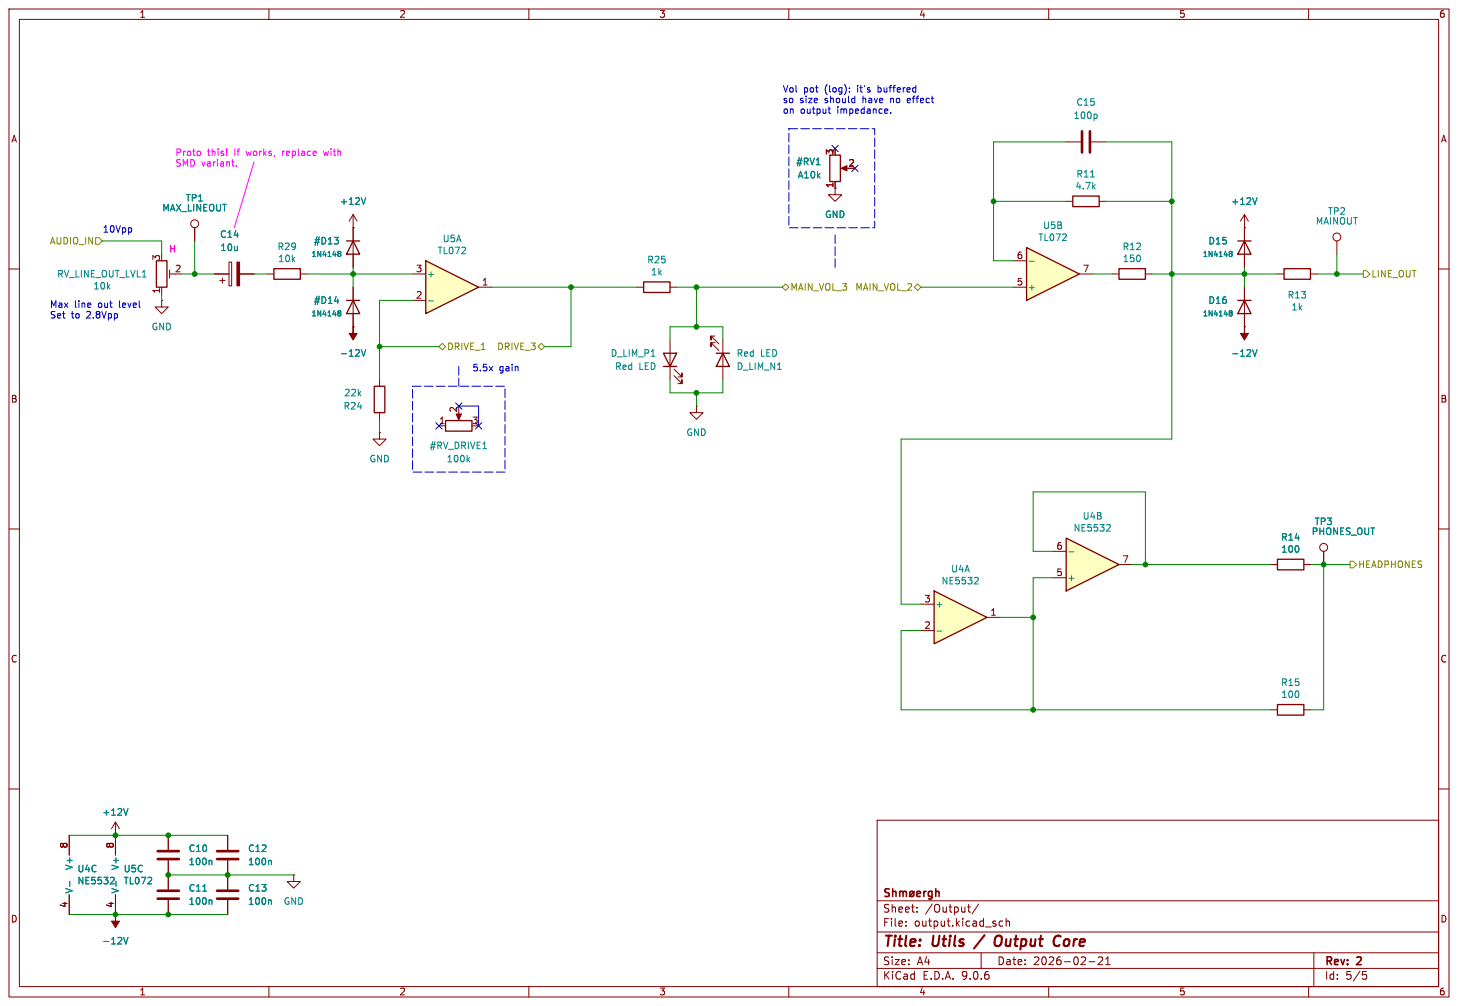
[picture p24: page 5]

so size should have no effect on output impedance. H

File: output.kicad_sch Sheet: /Output/
Id: 5/5 Title: Utils / Output Core
