DanD222/moduleur/modules/07-brain/electronics/core/schematics/brain-core.pdf

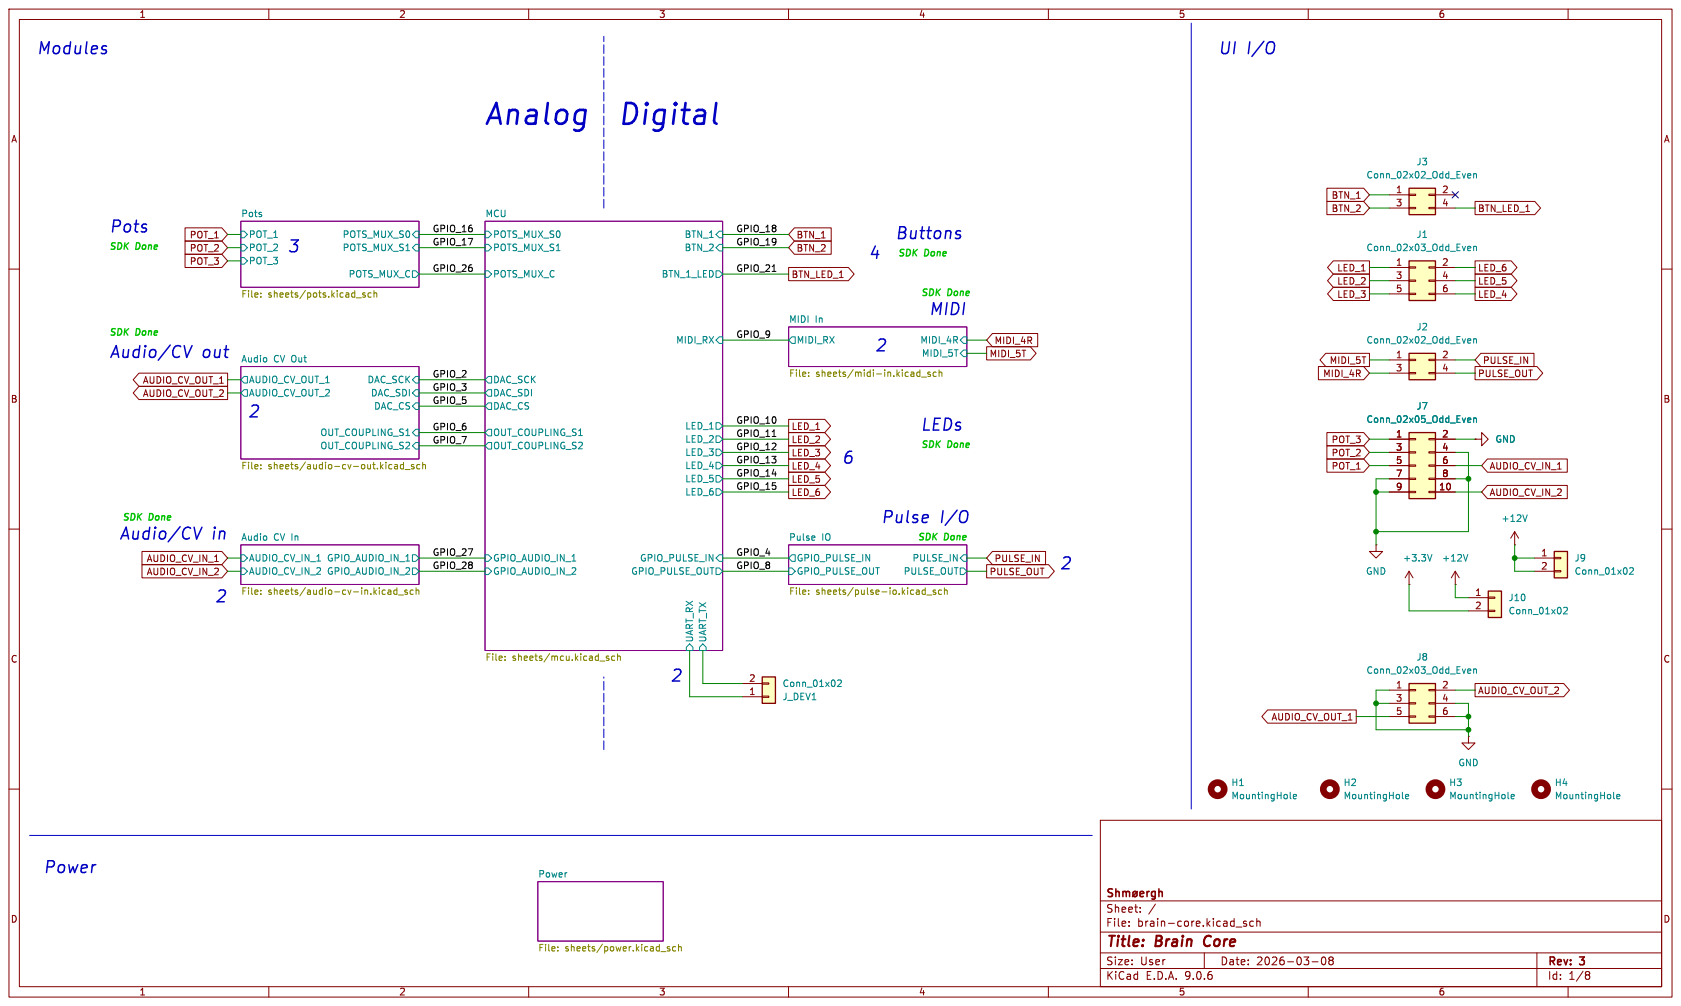
[picture p25: page 1]

Audio/CV out SDK Done Modules

SDK Done MIDI SDK Done LEDs

SDK Done Audio/CV in

File: brain-core.kicad_sch Sheet: / þÿShmøergh

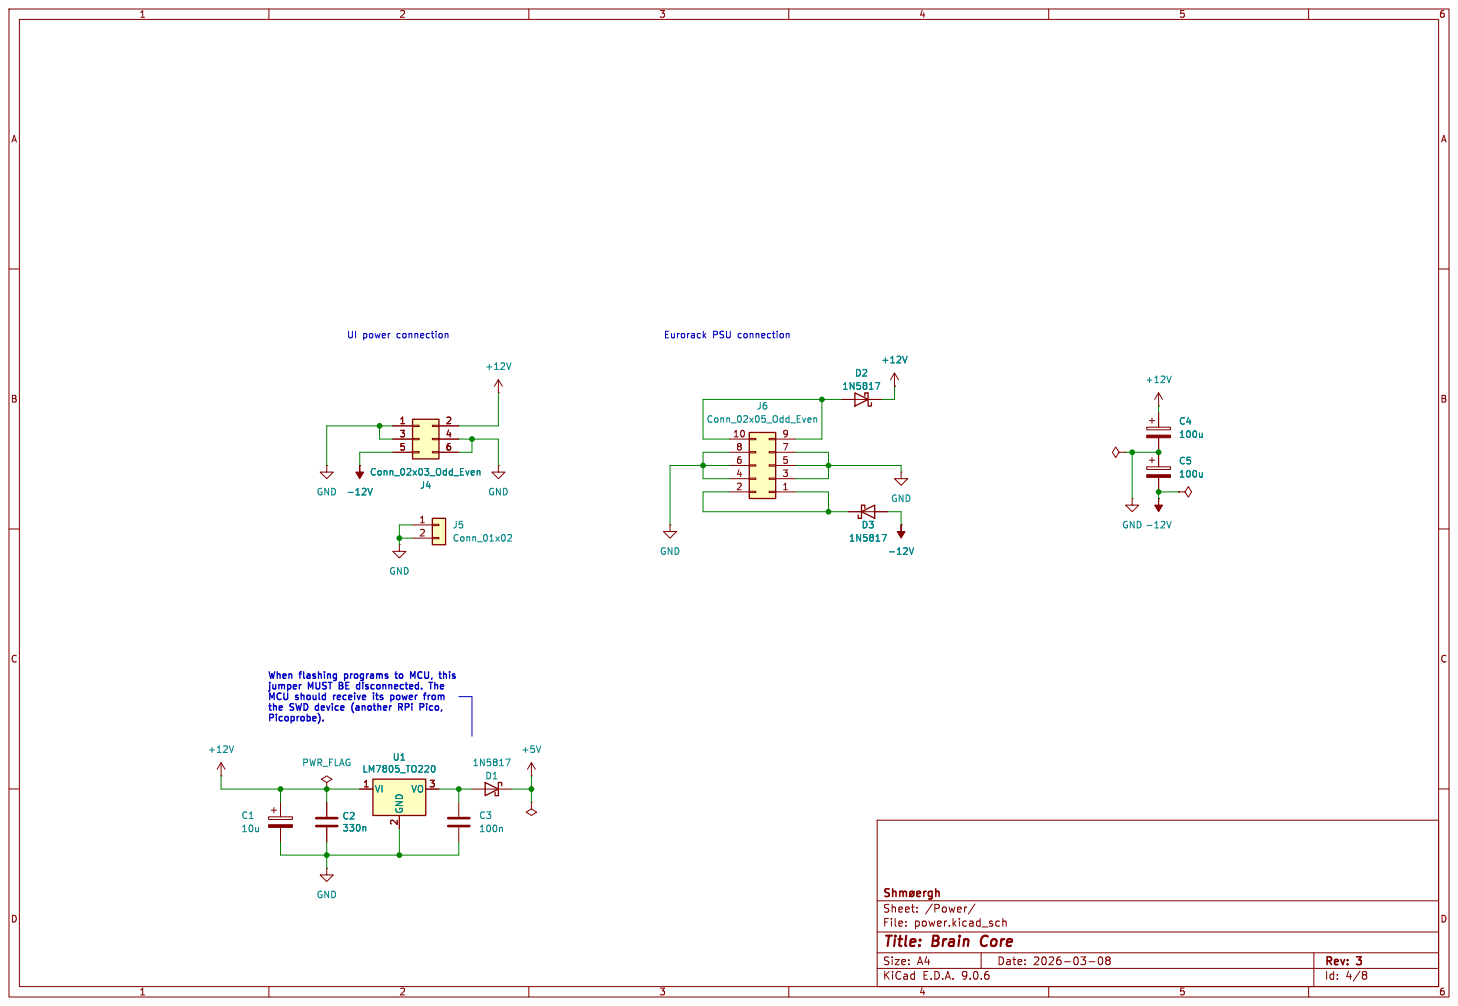
[picture p26: page 2]

100u When flashing programs to MCU, this

File: power.kicad_sch Sheet: /Power/ þÿShmøergh

Id: 4/8 Title: Brain Core

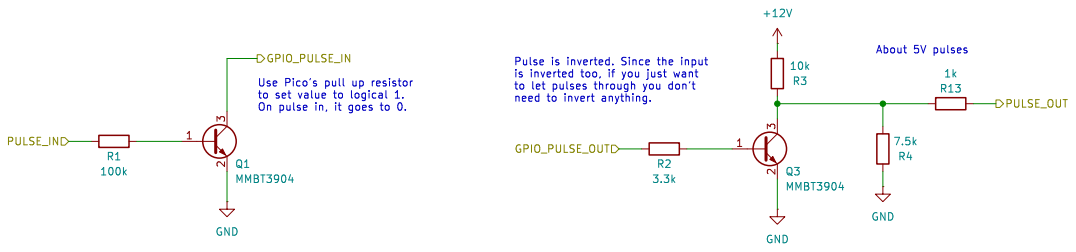
[picture p27: page 3]

is inverted too, if you just want

Id: 5/8 Title: Brain Core

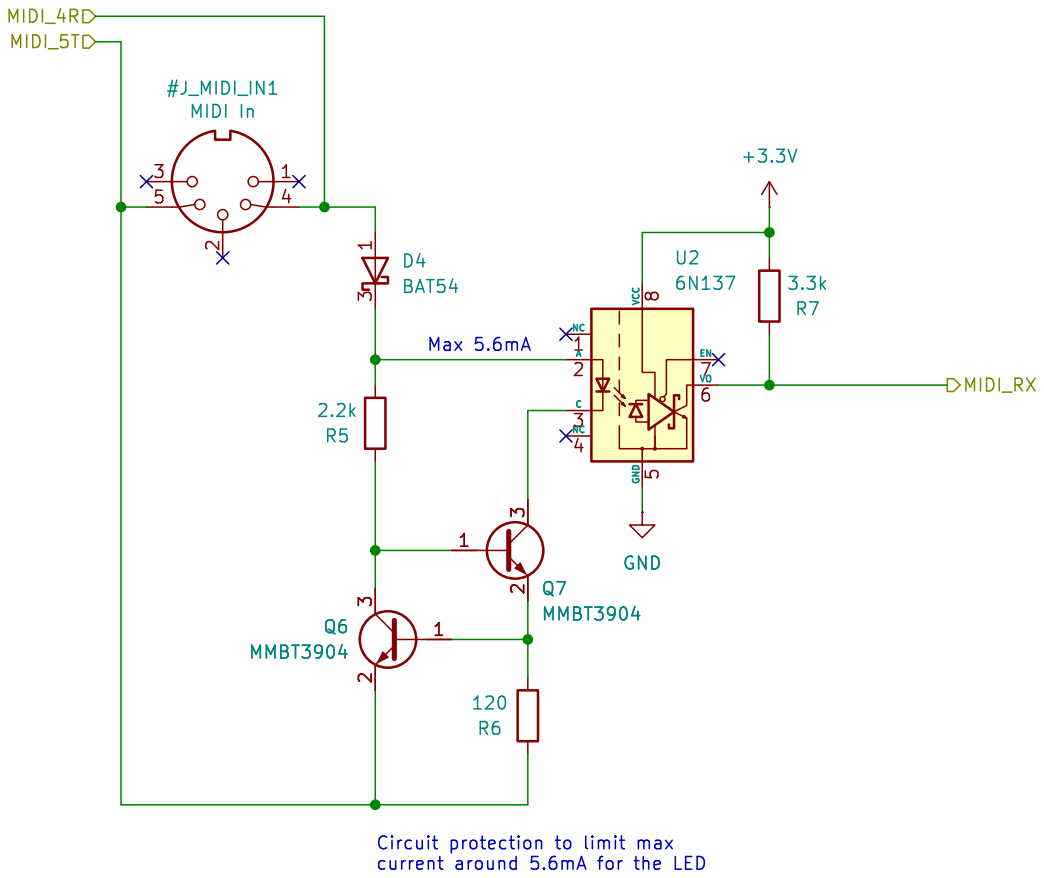
[picture p28: page 4]

current around 5.6mA for the LED GND Q7 MMBT3904

Id: 6/8 Title: Brain Core

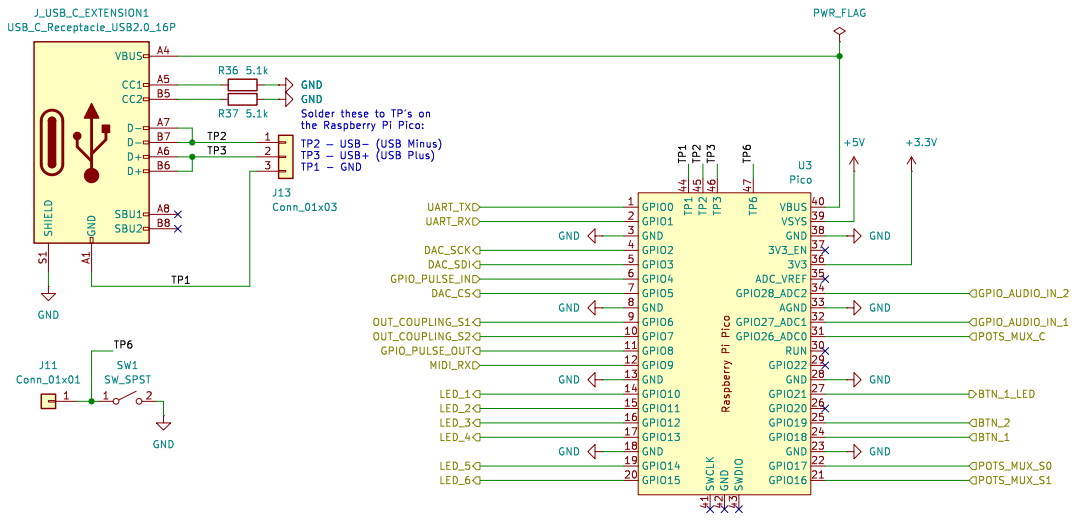
[picture p29: page 5]

the Raspberry Pi Pico: TP2 þÿ  USB-(USB Minus) TP3 þÿ  USB+(USB Plus) TP1 þÿ- GND GND GND

File: mcu.kicad_sch Sheet: /MCU/ þÿShmøergh

Id: 7/8 Title: Brain Core

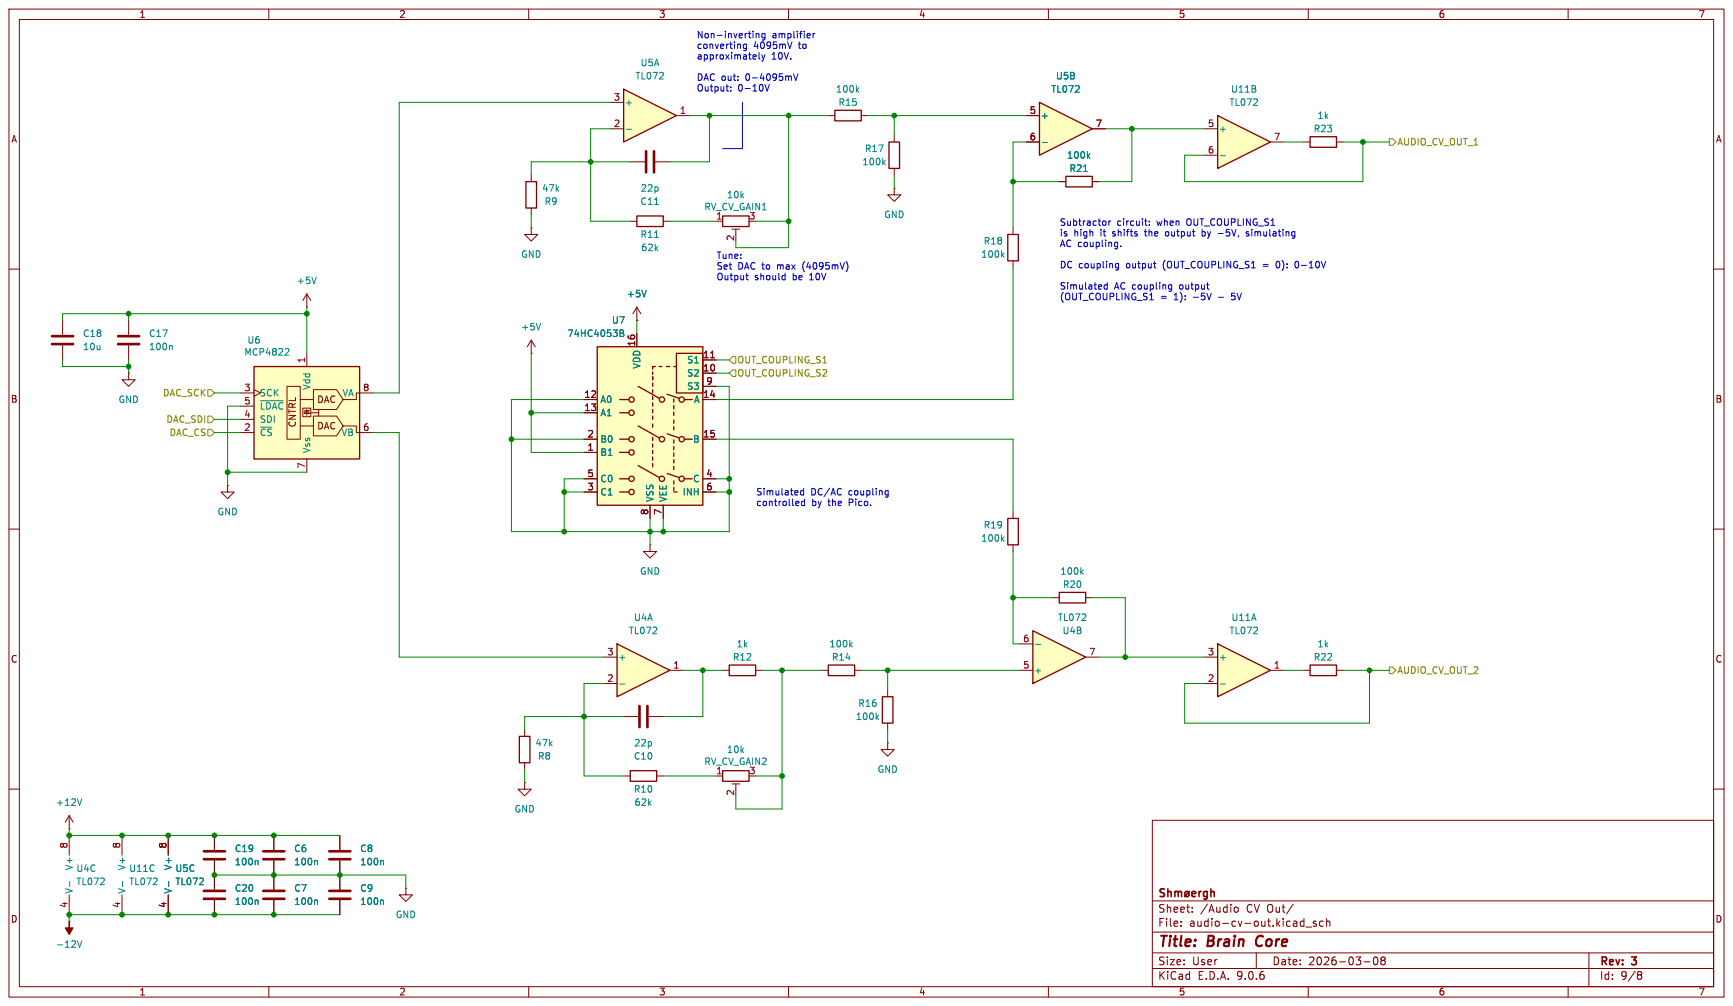
[picture p30: page 6]

Tune: Set DAC to max (4095mV)

Id: 9/8 Title: Brain Core

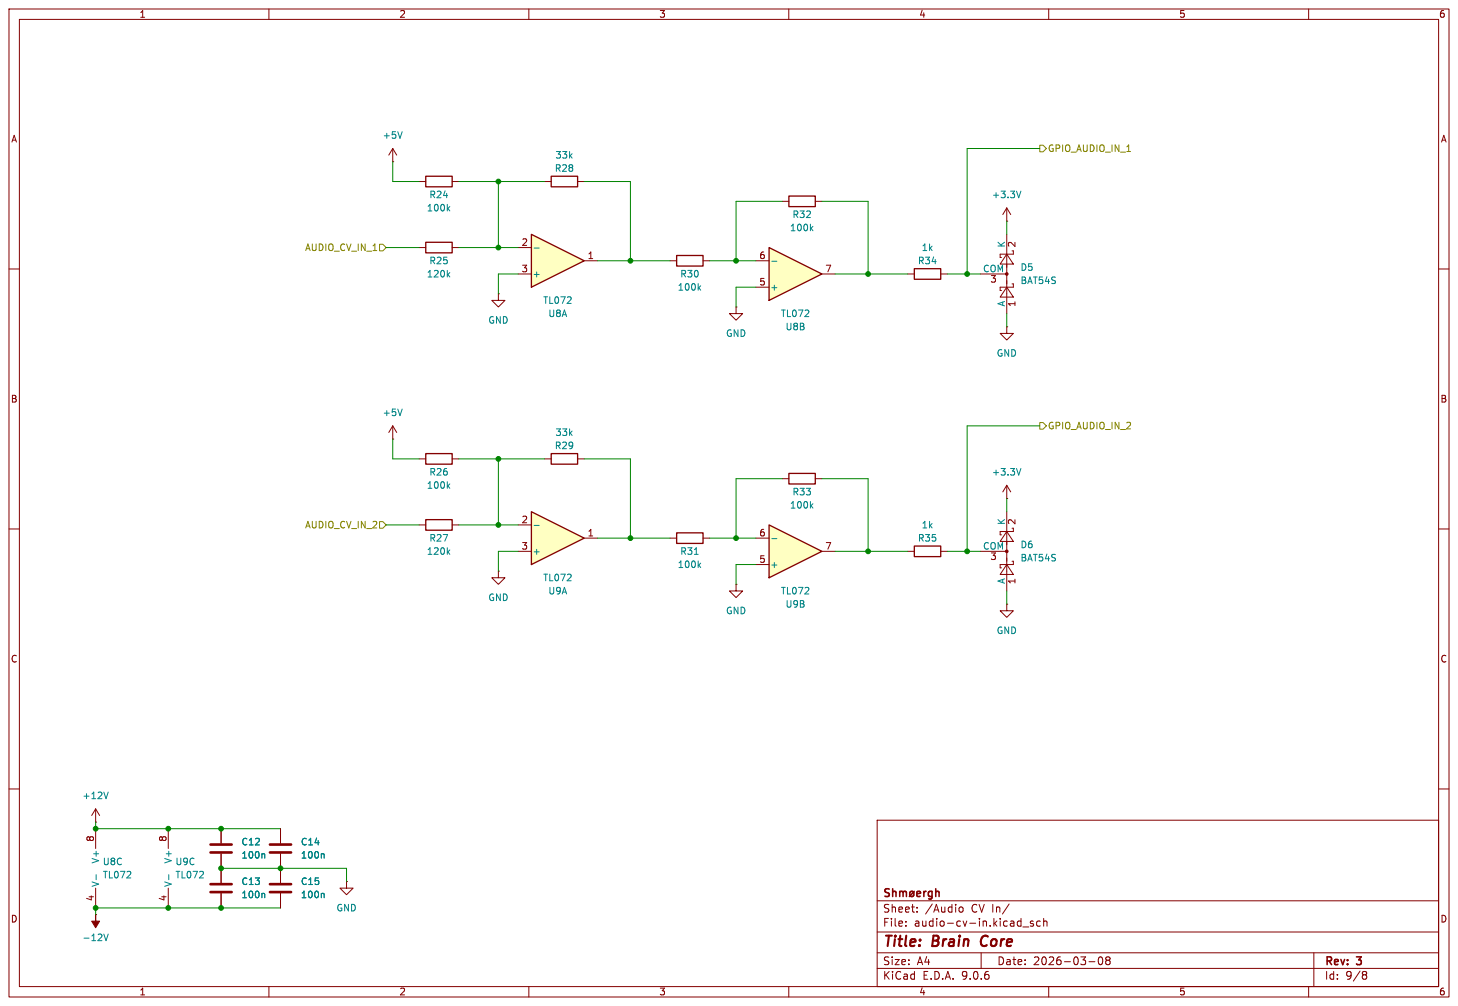
[picture p31: page 7]

Id: 9/8 Title: Brain Core

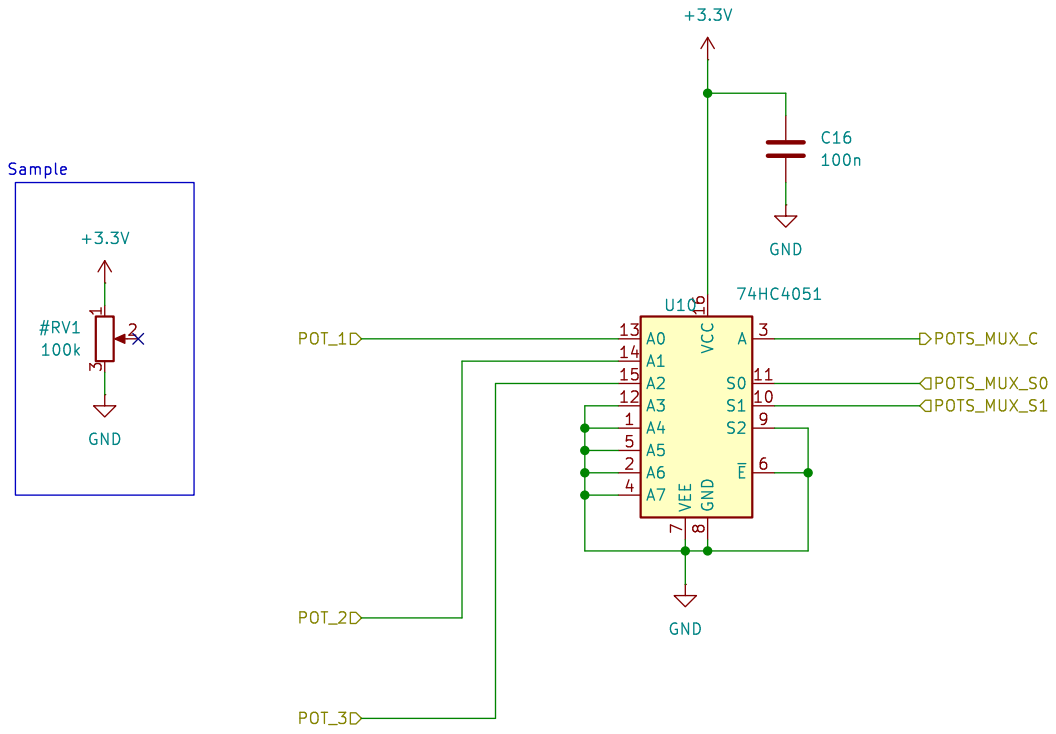
[picture p32: page 8]

File: pots.kicad_sch Sheet: /Pots/ þÿShmøergh

Id: 10/8 Title: Brain Core
