DanD222/moduleur/modules/02-vco/electronics/KiCAD9-BACKUP/core/schematics/vco-core.pdf

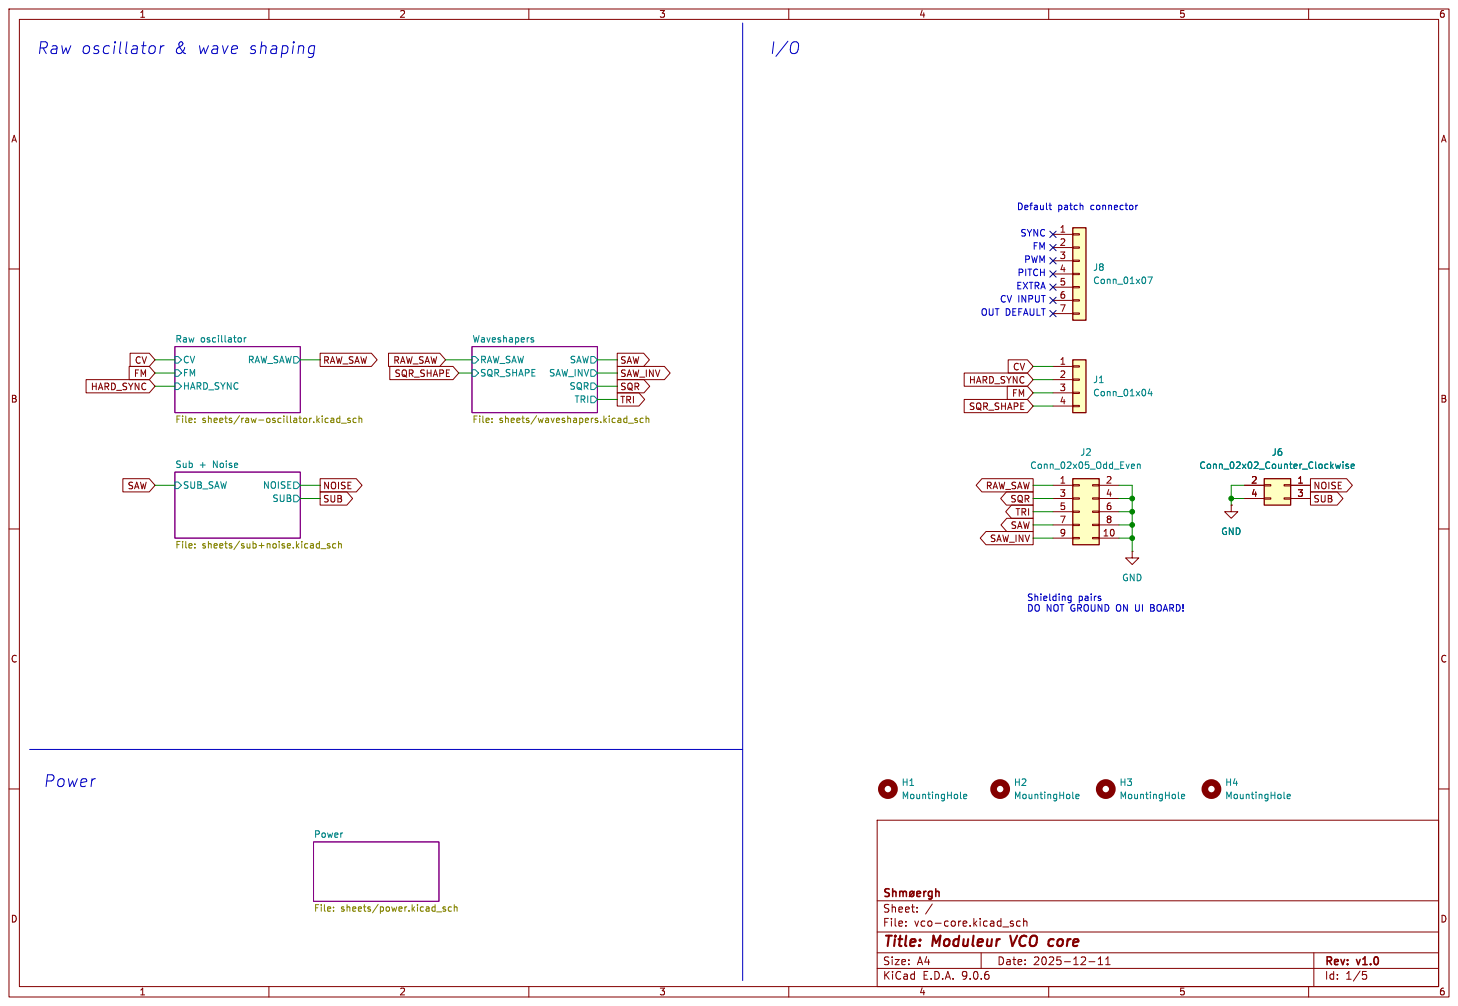
[picture p33: page 1]

TRI Waveshapers File: sheets/waveshapers.kicad_sch Power File: sheets/power.kicad_sch NOISE

Sub + Noise File: sheets/sub+noise.kicad_sch FM
HARD_SYNC

File: vco-core.kicad_sch Sheet: / þÿShmøergh

Id: 1/5 Title: Moduleur VCO core

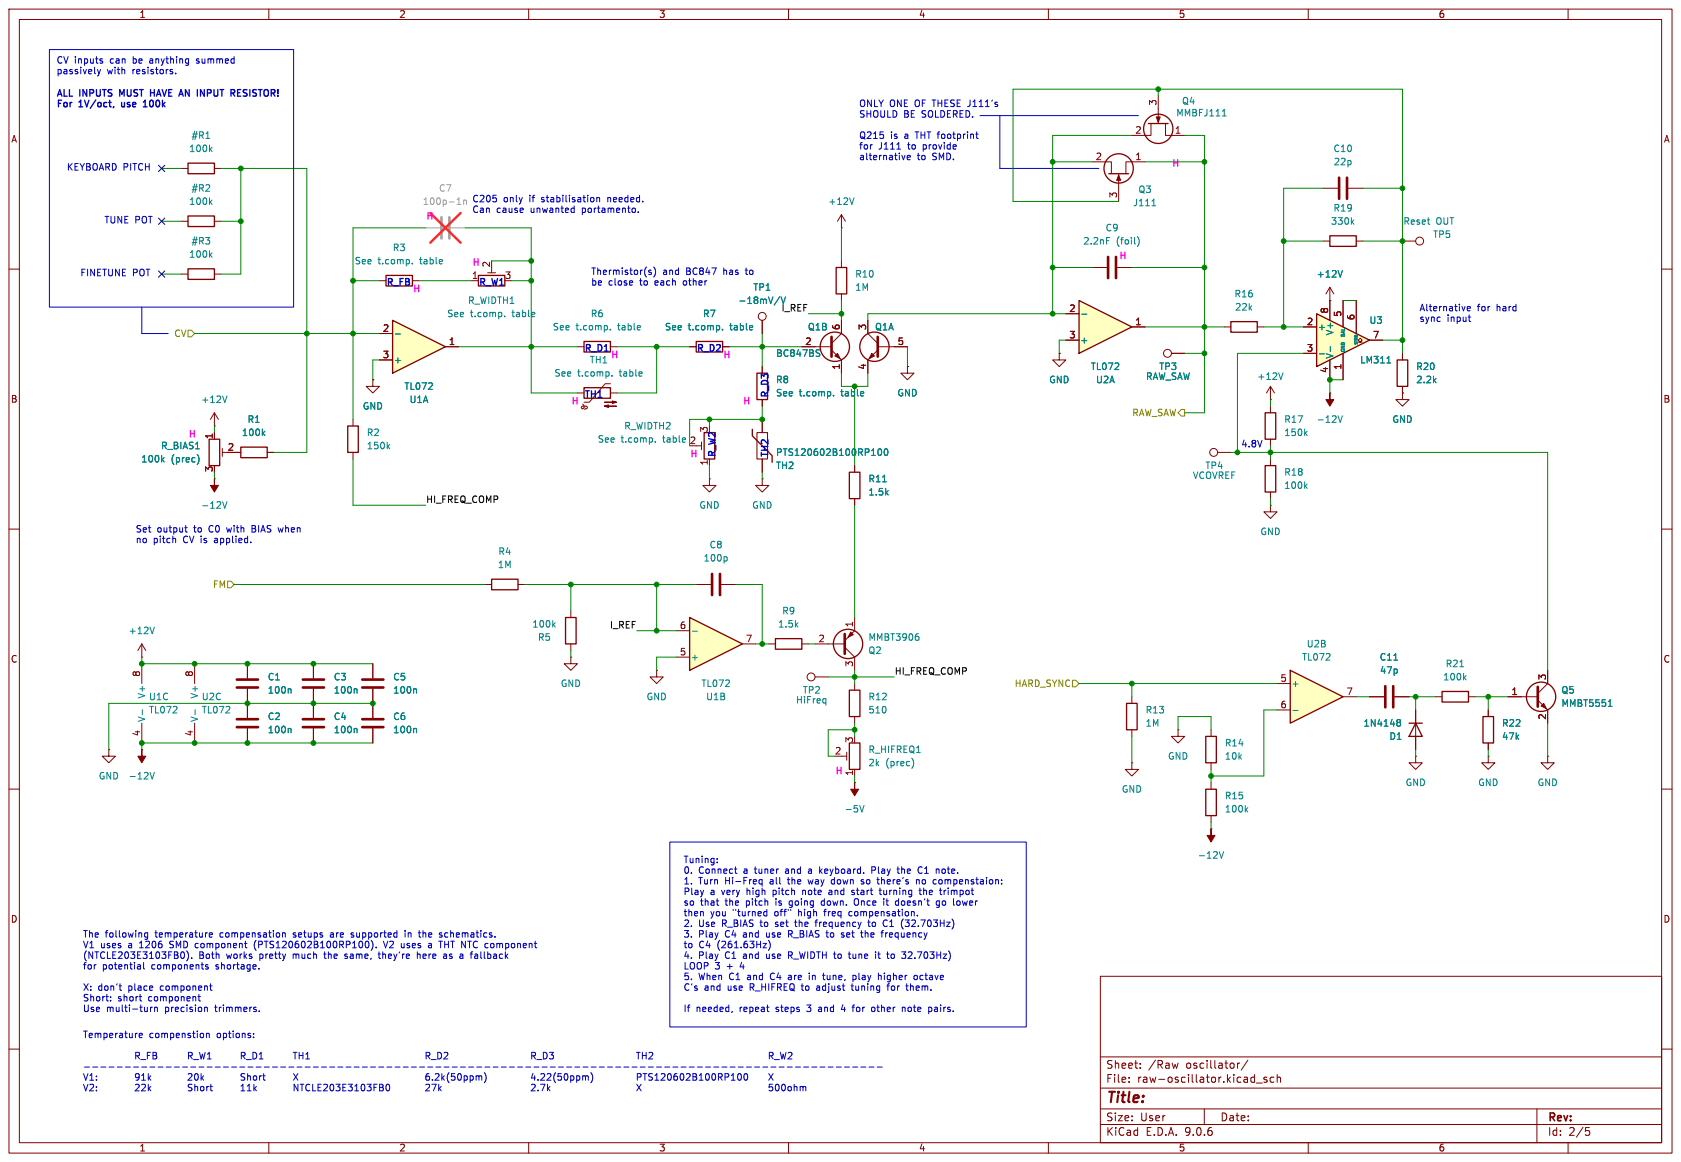
[picture p34: page 2]

1.5k R8See t.comp. table TH2 PTS120602B100RP100 R3 See t.comp. tableC7

be close to each other Set output to C0 with BIAS when

2k (prec) R6 See t.comp. table TH1 See t.comp. table C4

2 R_WIDTH2 See t.comp. table GND

Play a very high pitch note and start turning the trimpot so that the pitch is going down. Once it doesn't go lower

to C4 (261.63Hz) 4. Play C1 and use R_WIDTH to tune it to 32.703Hz) LOOP 3 + 4

5. When C1 and C4 are in tune, play higher octave C's and use R_HIFREQ to adjust tuning for them.

If needed, repeat steps 3 and 4 for other note pairs.

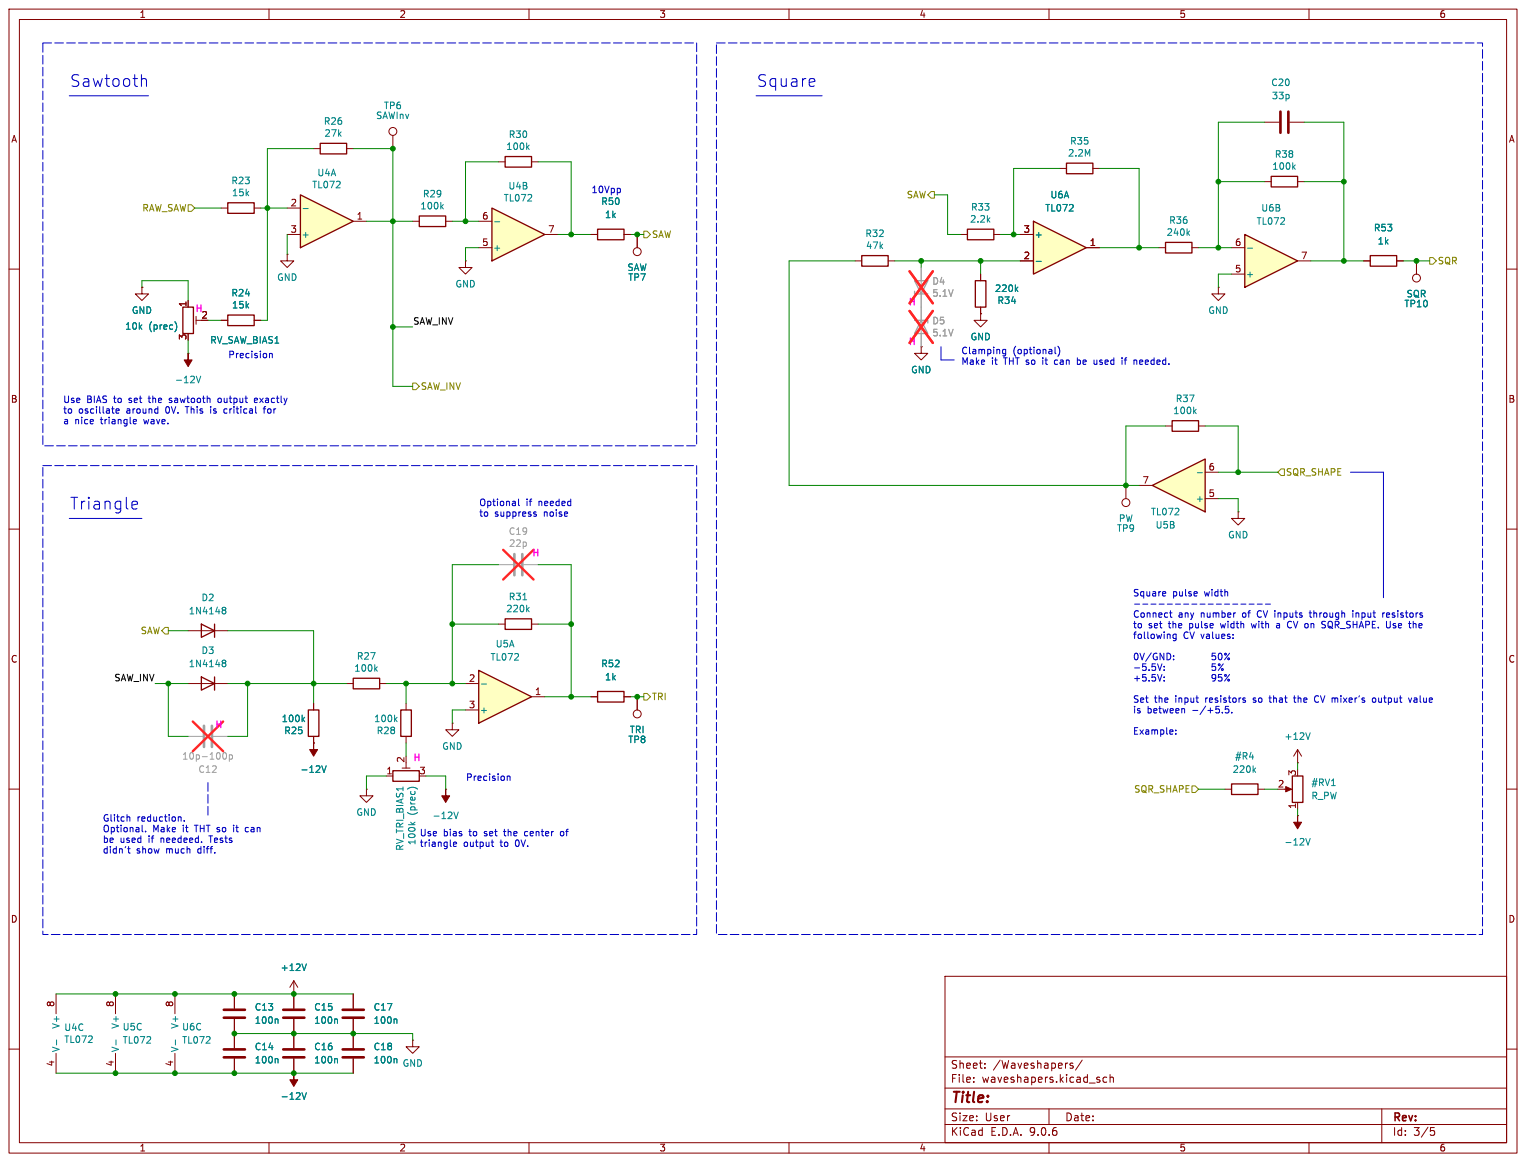
[picture p35: page 3]

----------------- Connect any number of CV inputs through input resistors

to set the pulse width with a CV on SQR_SHAPE. Use the

Use bias to set the center of

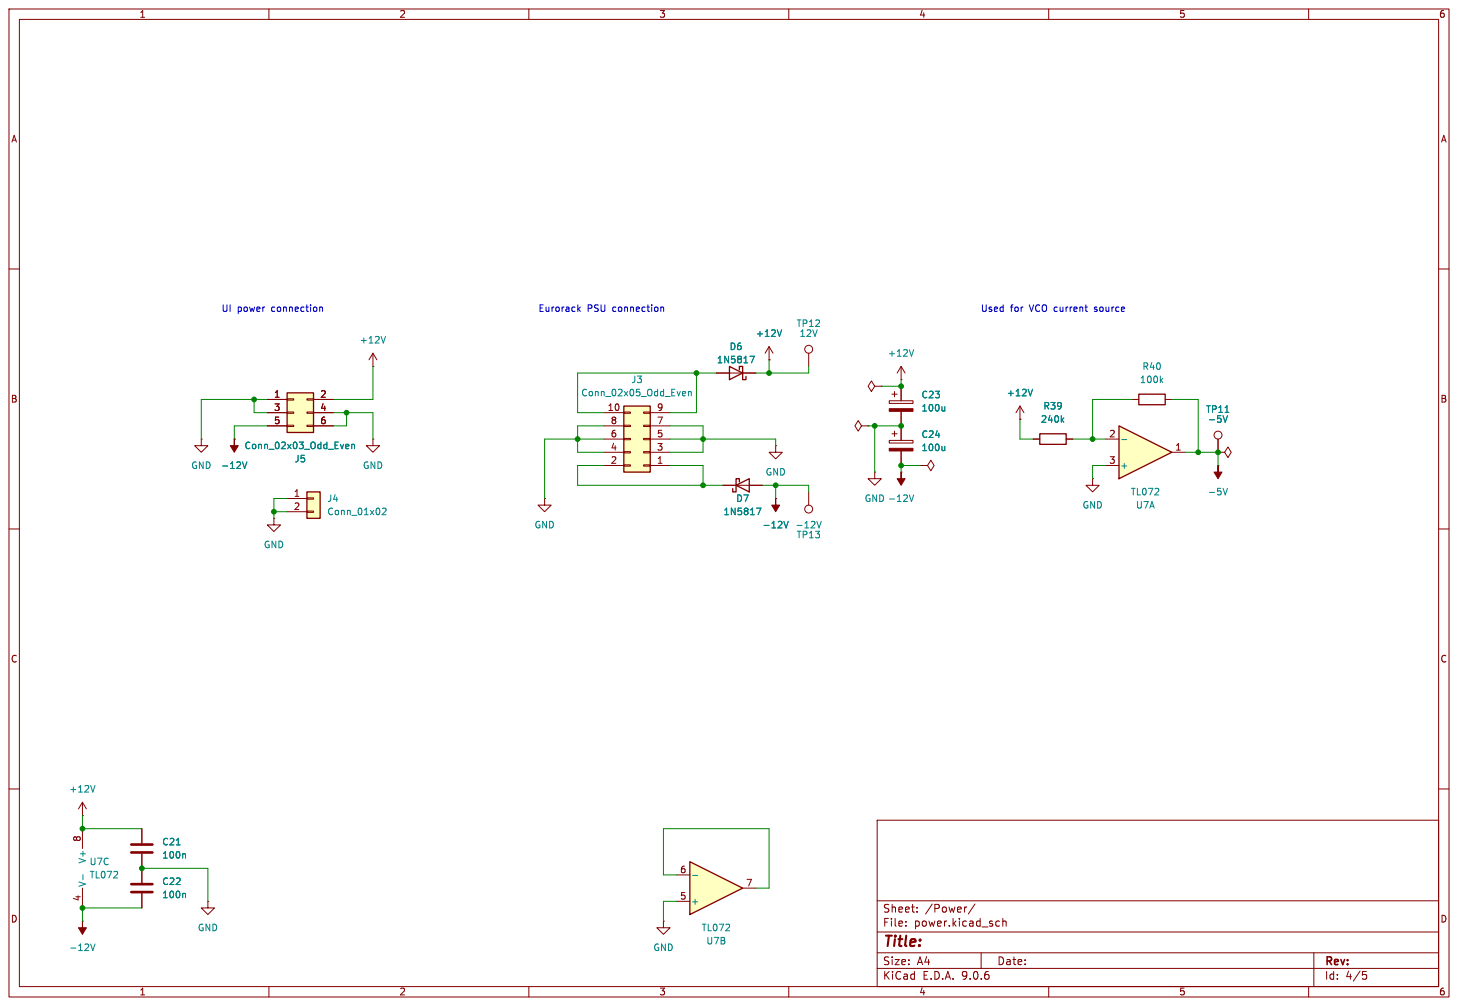
[picture p36: page 4]

Id: 4/5 Title: File: power.kicad_sch Sheet: /Power/

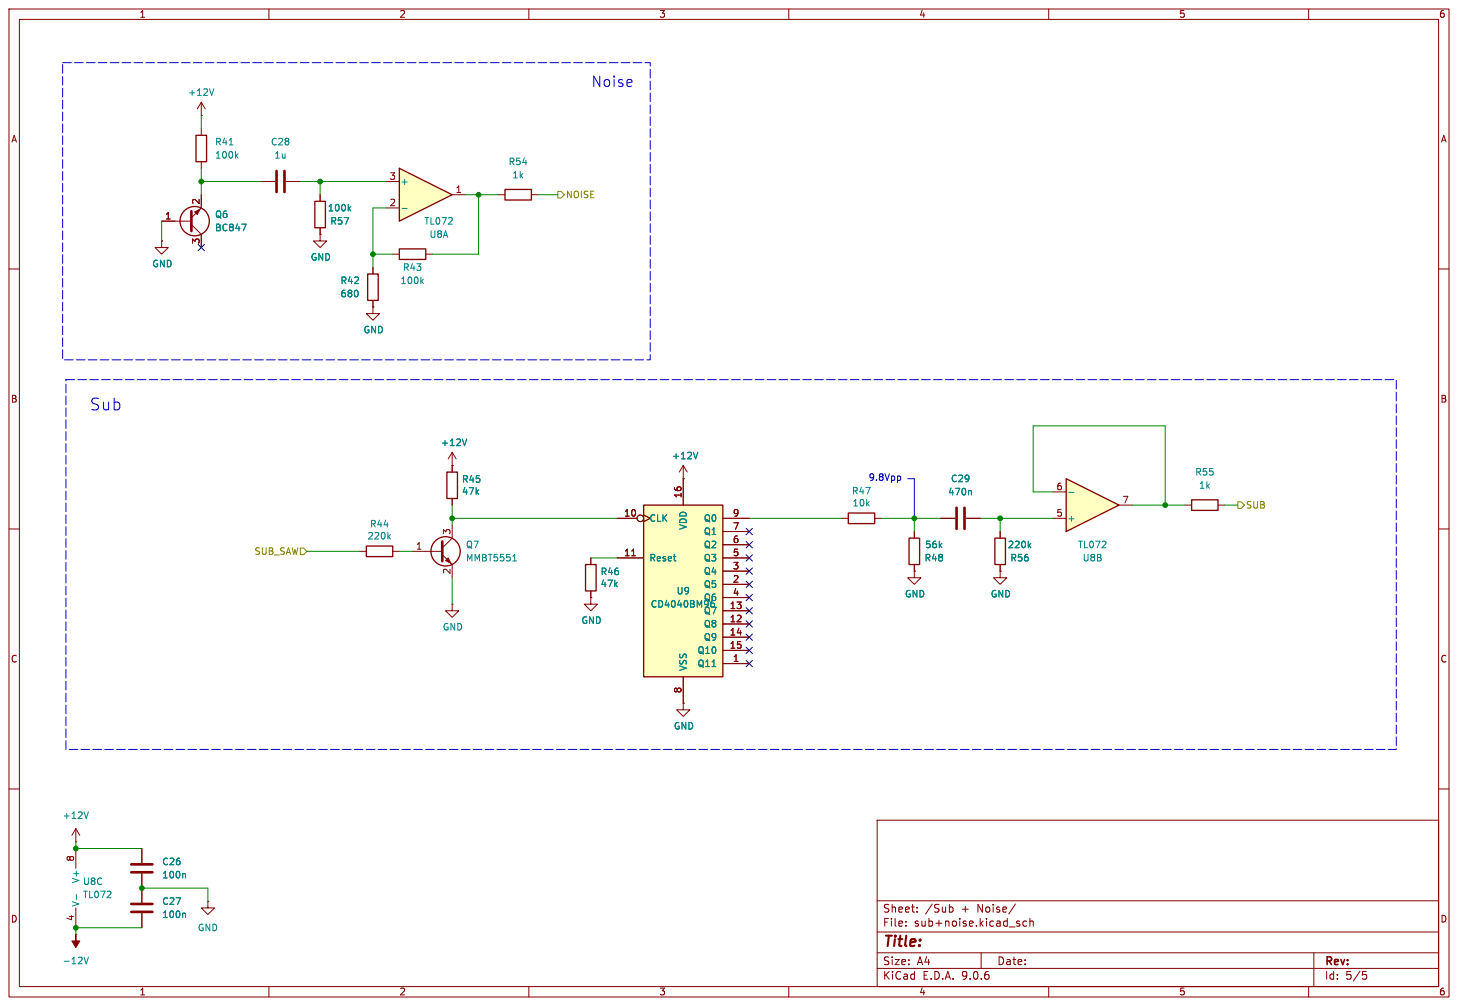
[picture p37: page 5]
