DanD222/moduleur/modules/08-default-patch/default-patch.kicad_pcb

## KiCad design modules/08-default-patch/default-patch.kicad_pcb (2026-05-23)

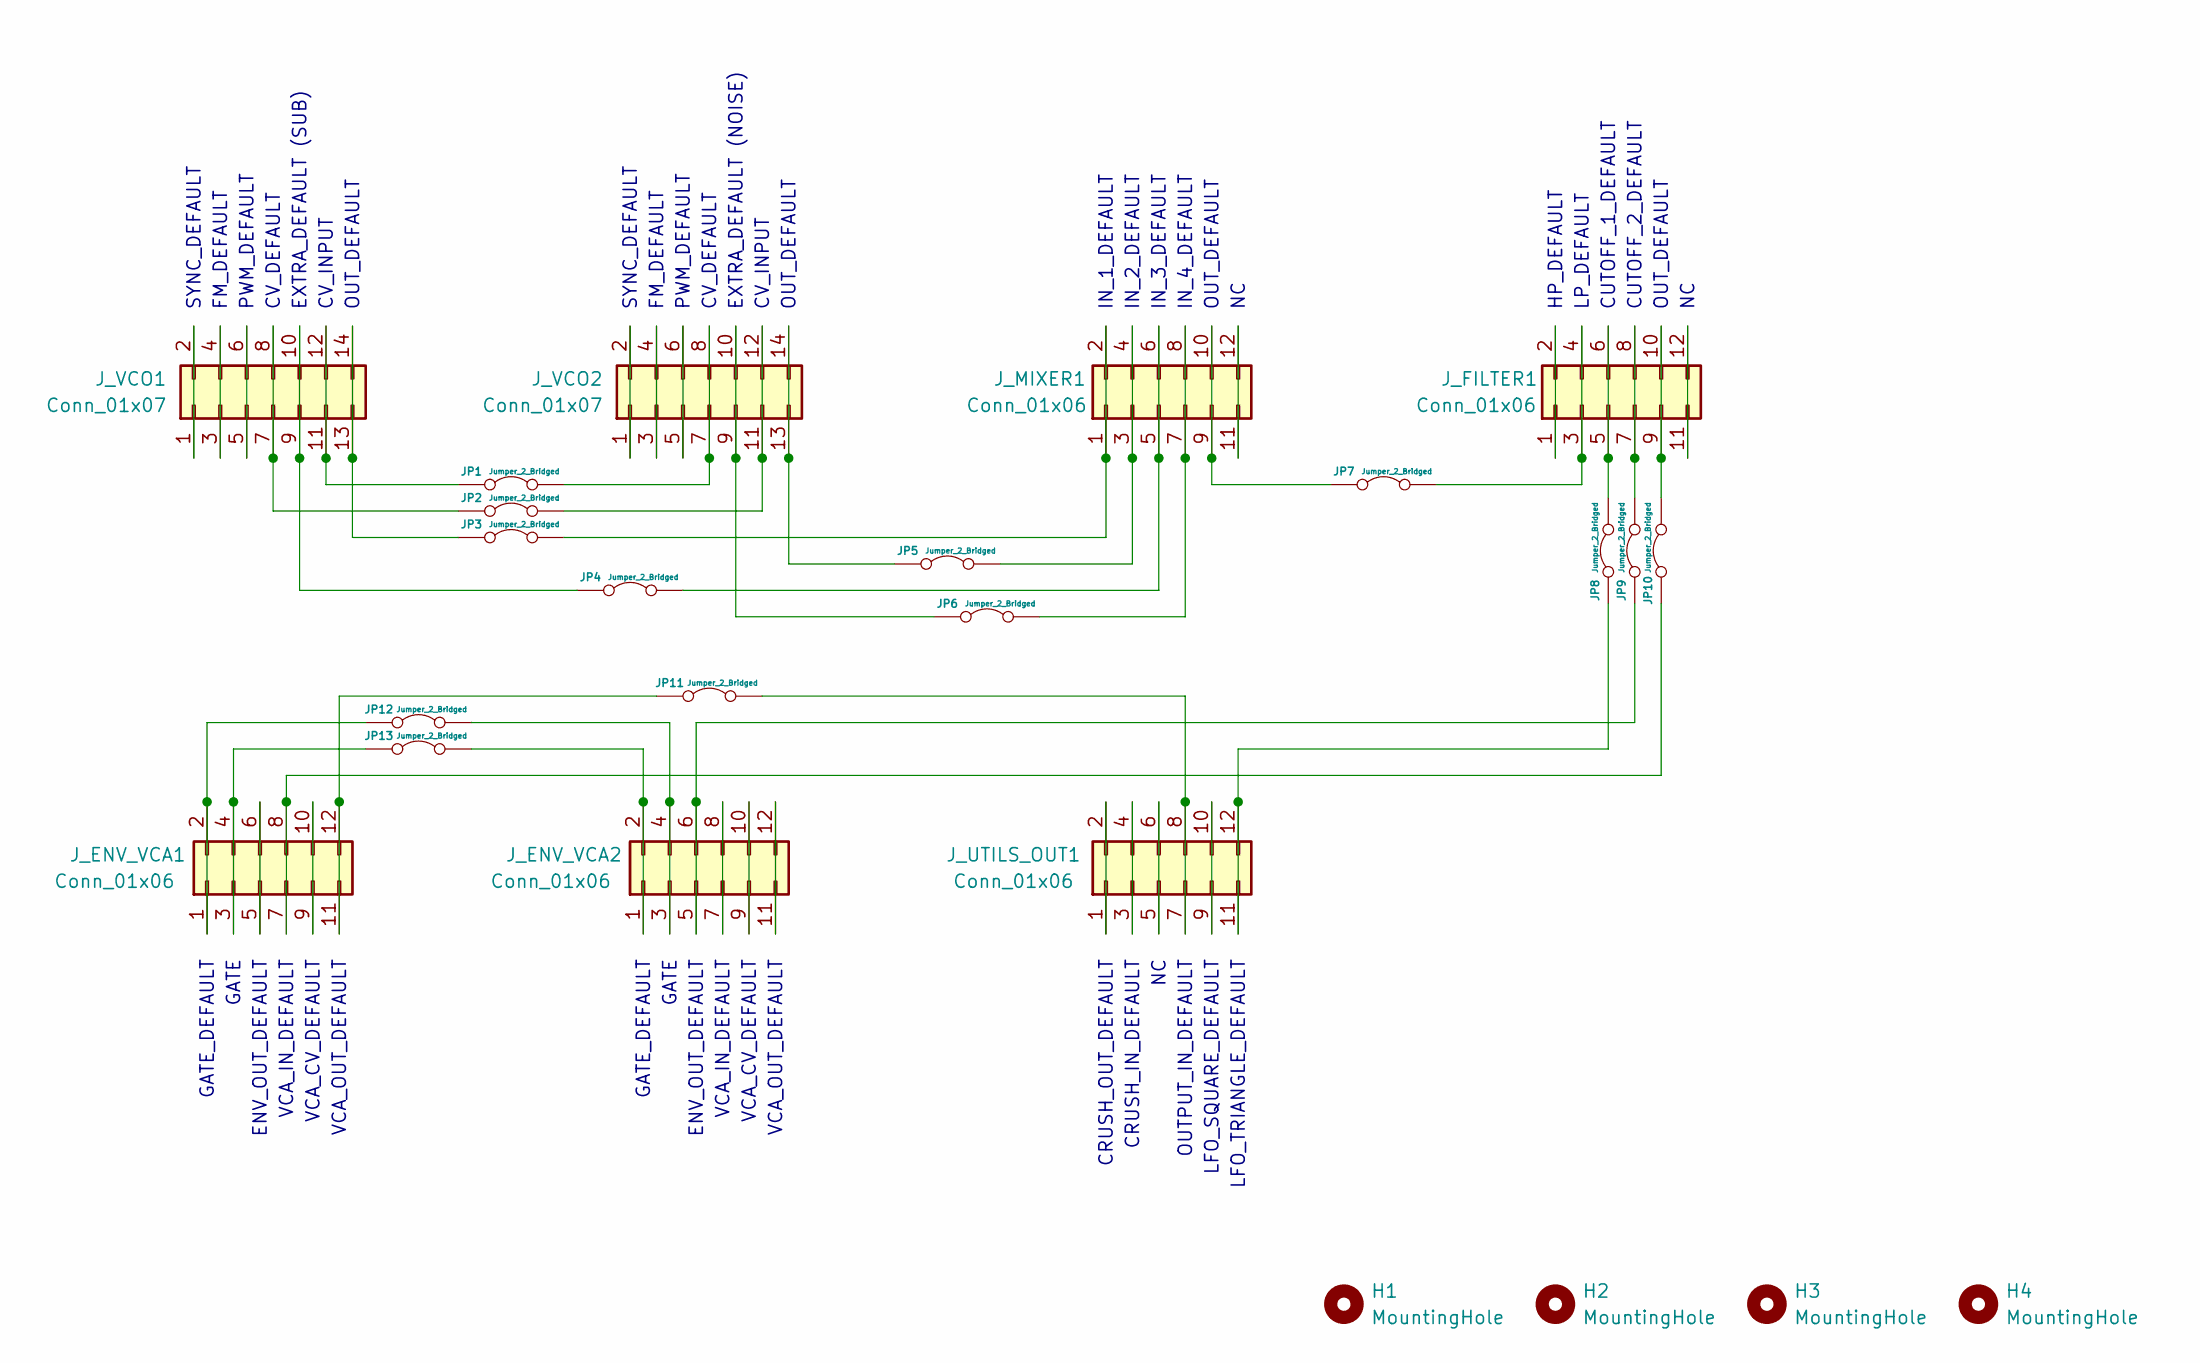
[picture p44: schematic default-patch.kicad_sch, Default Patch]

Parts:
H1, H2, H3, H4: MountingHole; MountingHole_3.2mm_M3
JP1, JP2, JP3, JP4, JP5, JP6, JP7, JP8, JP9, JP10, JP11, JP12, JP13: Jumper_2_Bridged; SolderJumper-2_P1.3mm_Bridged_RoundedPad1.0x1.5mm
J_ENV_VCA1, J_ENV_VCA2: Conn_01x06; PinHeader_2x06_P2.54mm_Vertical; Part No. 200-MTSW12009TS500
J_FILTER1: Conn_01x06; PinHeader_2x06_P2.54mm_Vertical; Part No. 200-MTSW12009TS500
J_MIXER1: Conn_01x06; PinHeader_2x06_P2.54mm_Vertical; Part No. 200-MTSW12009TS500
J_UTILS_OUT1: Conn_01x06; PinHeader_2x06_P2.54mm_Vertical; Part No. 200-MTSW12009TS500
J_VCO1, J_VCO2: Conn_01x07; PinHeader_2x07_P2.54mm_Vertical; Part No. 200-MTSW12009TS500

Connections:
unnamed: JP1.1 (A), J_VCO1.11, J_VCO1.12
unnamed: JP1.2 (B), J_VCO2.7, J_VCO2.8
unnamed: JP2.1 (A), J_VCO1.7, J_VCO1.8
unnamed: JP2.2 (B), J_VCO2.11, J_VCO2.12
unnamed: JP3.1 (A), J_VCO1.13, J_VCO1.14
unnamed: JP3.2 (B), J_MIXER1.1, J_MIXER1.2
unnamed: JP4.1 (A), J_VCO1.9, J_VCO1.10
unnamed: JP4.2 (B), J_MIXER1.5, J_MIXER1.6
unnamed: JP5.1 (A), J_VCO2.13, J_VCO2.14
unnamed: JP5.2 (B), J_MIXER1.3, J_MIXER1.4
unnamed: JP6.1 (A), J_VCO2.9, J_VCO2.10
unnamed: JP6.2 (B), J_MIXER1.7, J_MIXER1.8
unnamed: JP7.1 (A), J_MIXER1.9, J_MIXER1.10
unnamed: JP7.2 (B), J_FILTER1.3, J_FILTER1.4
unnamed: JP8.1 (A), J_UTILS_OUT1.11, J_UTILS_OUT1.12
unnamed: JP8.2 (B), J_FILTER1.5, J_FILTER1.6
unnamed: JP9.1 (A), J_ENV_VCA2.5, J_ENV_VCA2.6
unnamed: JP9.2 (B), J_FILTER1.7, J_FILTER1.8
unnamed: JP10.1 (A), J_ENV_VCA1.7, J_ENV_VCA1.8
unnamed: JP10.2 (B), J_FILTER1.9, J_FILTER1.10
unnamed: JP11.1 (A), J_ENV_VCA1.11, J_ENV_VCA1.12
unnamed: JP11.2 (B), J_UTILS_OUT1.7, J_UTILS_OUT1.8
unnamed: JP12.1 (A), J_ENV_VCA1.1, J_ENV_VCA1.2
unnamed: JP12.2 (B), J_ENV_VCA2.3, J_ENV_VCA2.4
unnamed: JP13.1 (A), J_ENV_VCA1.3, J_ENV_VCA1.4
unnamed: JP13.2 (B), J_ENV_VCA2.1, J_ENV_VCA2.2
unnamed: J_ENV_VCA1.5, J_ENV_VCA1.6
unnamed: J_ENV_VCA1.9, J_ENV_VCA1.10
unnamed: J_ENV_VCA2.7, J_ENV_VCA2.8
unnamed: J_ENV_VCA2.9, J_ENV_VCA2.10
unnamed: J_ENV_VCA2.11, J_ENV_VCA2.12
unnamed: J_FILTER1.1, J_FILTER1.2
unnamed: J_FILTER1.11, J_FILTER1.12
unnamed: J_MIXER1.11, J_MIXER1.12
unnamed: J_UTILS_OUT1.1, J_UTILS_OUT1.2
unnamed: J_UTILS_OUT1.3, J_UTILS_OUT1.4
unnamed: J_UTILS_OUT1.5, J_UTILS_OUT1.6
unnamed: J_UTILS_OUT1.9, J_UTILS_OUT1.10
unnamed: J_VCO1.1, J_VCO1.2
unnamed: J_VCO1.3, J_VCO1.4
unnamed: J_VCO1.5, J_VCO1.6
unnamed: J_VCO2.1, J_VCO2.2
unnamed: J_VCO2.3, J_VCO2.4
unnamed: J_VCO2.5, J_VCO2.6

Notes on the sheet:
HP_DEFAULT
VCA_IN_DEFAULT
GATE_DEFAULT
SYNC_DEFAULT
OUT_DEFAULT
FM_DEFAULT
PWM_DEFAULT
CV_DEFAULT
ENV_OUT_DEFAULT
VCA_CV_DEFAULT
IN_1_DEFAULT
VCA_OUT_DEFAULT
CRUSH_OUT_DEFAULT
OUTPUT_IN_DEFAULT
GATE
LP_DEFAULT
LFO_TRIANGLE_DEFAULT
IN_4_DEFAULT
CUTOFF_1_DEFAULT
IN_2_DEFAULT
CRUSH_IN_DEFAULT
IN_3_DEFAULT
CUTOFF_2_DEFAULT
EXTRA_DEFAULT (NOISE)
CV_INPUT
EXTRA_DEFAULT (SUB)
LFO_SQUARE_DEFAULT

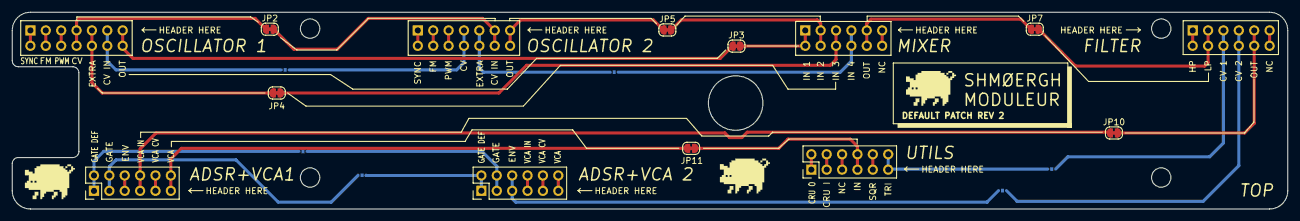
[picture p45: board default-patch.kicad_pcb from above]

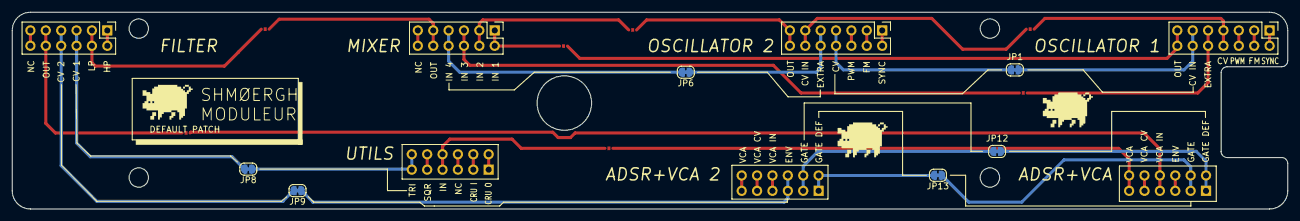
[picture p46: board default-patch.kicad_pcb from below]

Board: 2 copper layers, 210.7 x 32.5 mm, 24 parts (10 on the bottom side), 44 nets.
