DanD222/moduleur/modules/07-brain/electronics/ui/brain-ui.kicad_pcb

## KiCad design modules/07-brain/electronics/ui/brain-ui.kicad_pcb (2026-05-23)

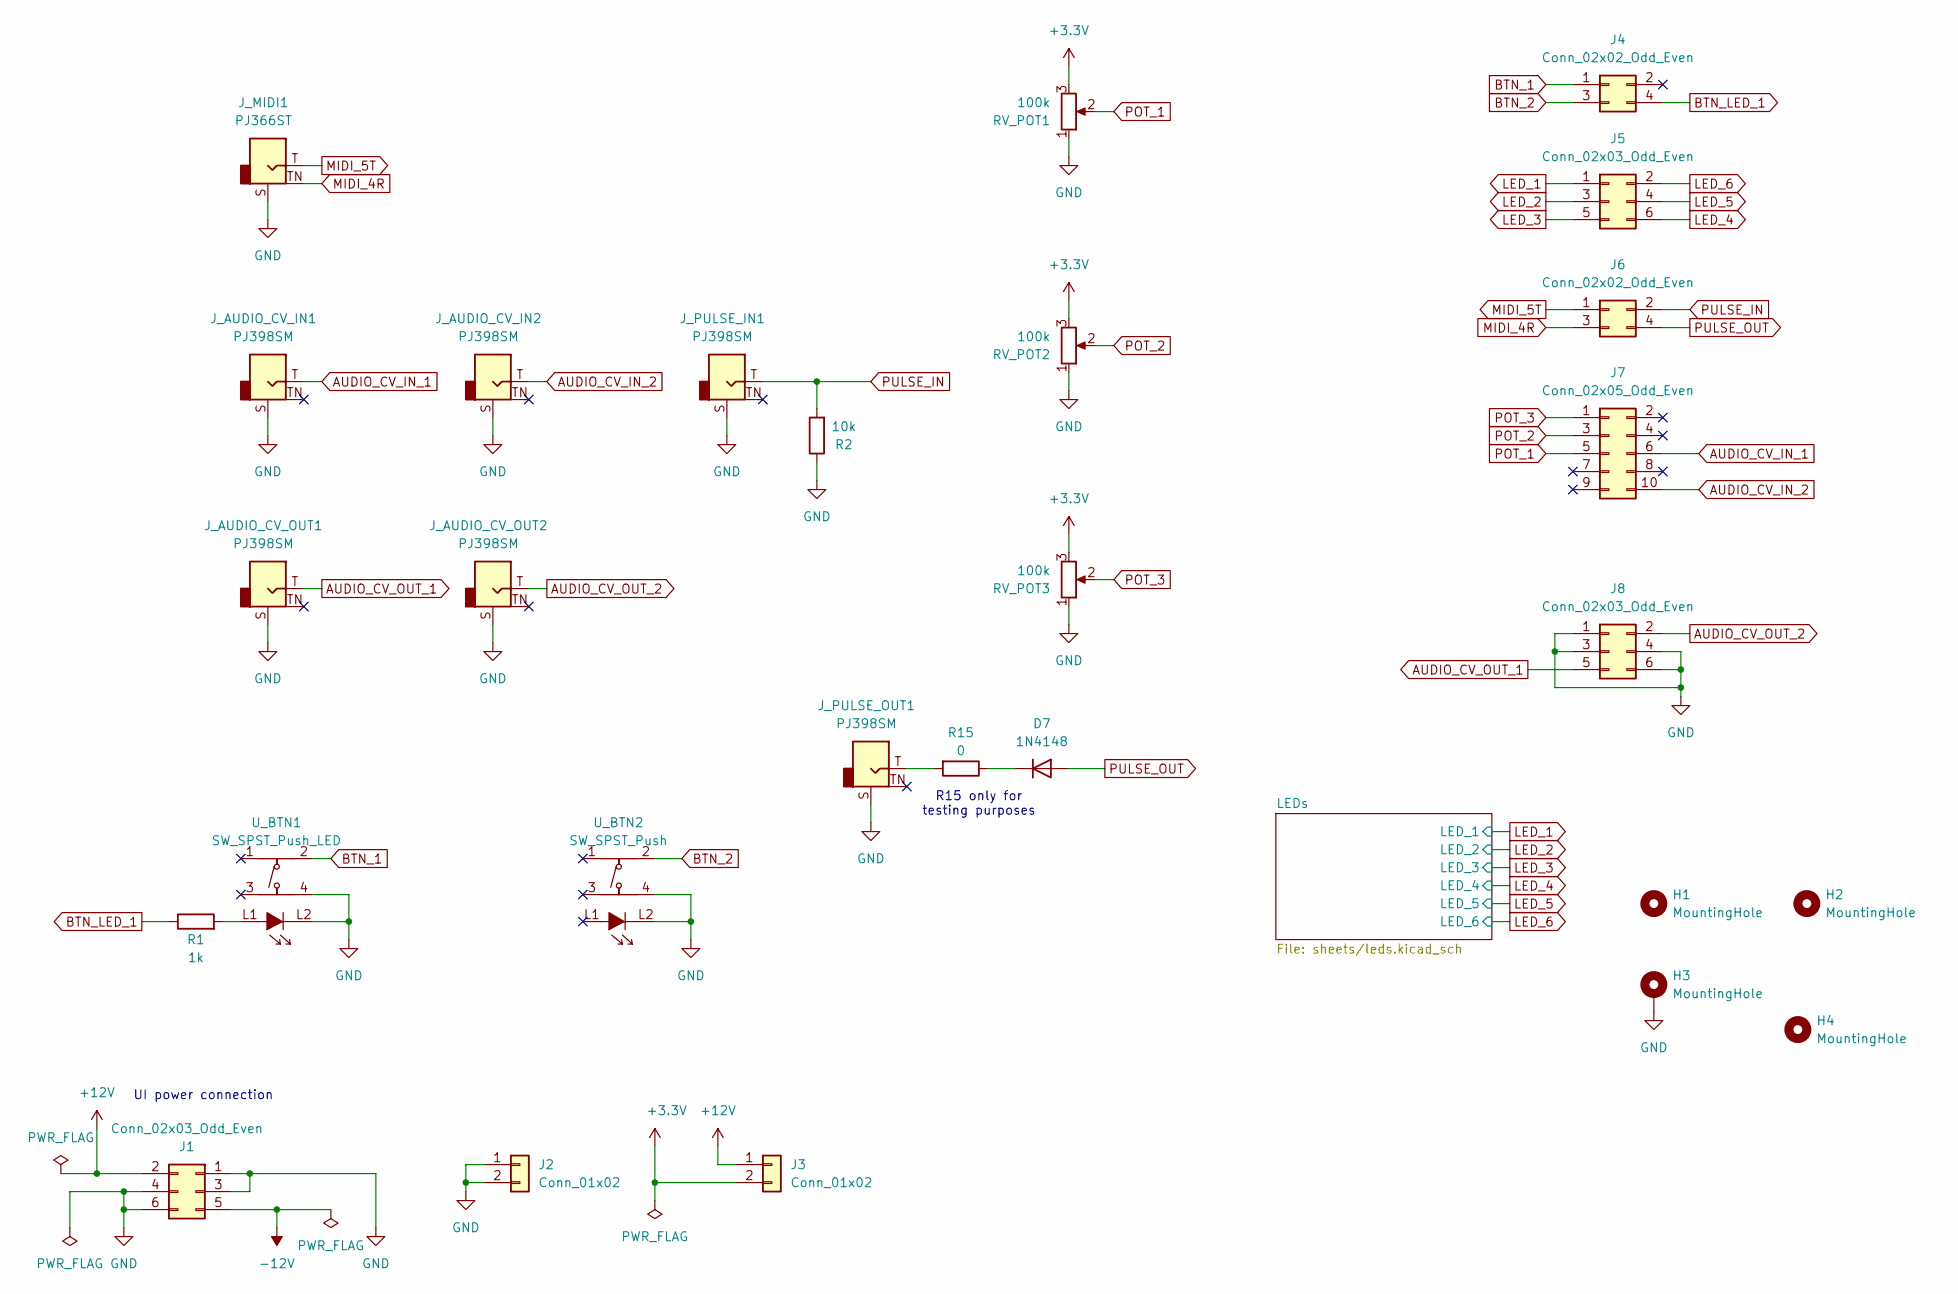
[picture p47: schematic brain-ui.kicad_sch, Brain UI]

Parts:
D7: 1N4148; D_DO-35_SOD27_P7.62mm_Horizontal
H1, H2, H3, H4: MountingHole; MountingHole_3.2mm_M3_DIN965_Pad
J1, J5, J8: Conn_02x03_Odd_Even; PinSocket_2x03_P2.54mm_Vertical; Part no. 200-SSW10301TD
J2, J3: Conn_01x02; PinSocket_1x02_P2.54mm_Vertical; Part no. 200-SSW10201TS
J4, J6: Conn_02x02_Odd_Even; PinSocket_2x02_P2.54mm_Vertical; Part no. 200-SSW10206TD
J7: Conn_02x05_Odd_Even; PinSocket_2x05_P2.54mm_Vertical; Part no. 200-SSW10501TD
J_AUDIO_CV_IN1, J_AUDIO_CV_IN2: PJ398SM; Jack_3.5mm_QingPu_WQP-PJ398SM_Vertical_CircularHoles; Part no. PJ398SM
J_AUDIO_CV_OUT1, J_AUDIO_CV_OUT2: PJ398SM; Jack_3.5mm_QingPu_WQP-PJ398SM_Vertical_CircularHoles; Part no. PJ398SM
J_MIDI1: PJ366ST; Jack_3.5mm_QingPu_WQP-PJ398SM_Vertical_CircularHoles; Part no. PJ366ST Stereo
J_PULSE_IN1: PJ398SM; Jack_3.5mm_QingPu_WQP-PJ398SM_Vertical_CircularHoles; Part no. PJ398SM
J_PULSE_OUT1: PJ398SM; Jack_3.5mm_QingPu_WQP-PJ398SM_Vertical_CircularHoles; Part no. PJ398SM
R1: 1k; R_Axial_DIN0207_L6.3mm_D2.5mm_P7.62mm_Horizontal; Part no. 603-MFR-25FRE52-1K
R2: 10k; R_Axial_DIN0207_L6.3mm_D2.5mm_P7.62mm_Horizontal; Part no. 603-MFR25SFTF52-10K
R15: 0; R_Axial_DIN0207_L6.3mm_D2.5mm_P7.62mm_Horizontal; Part no. 603-MFR25SFTF52-10K
RV_POT1, RV_POT2, RV_POT3: 100k; Potentiometer_Bourns_Single-PTV09A; Part no. 652-PTV09A4025UB104
U_BTN1: SW_SPST_Push_LED; SPST_Circular_Pushbutton_LED; Part no. 611-D6RLRDF1LFS
U_BTN2: SW_SPST_Push; SPST_Circular_Pushbutton_LED; Part no. 611-D6R90F2LFS

Connections:
+3.3V: J3.2, RV_POT1.3, RV_POT2.3, RV_POT3.3
+12V: J1.2, J3.1; also elsewhere on the board
-12V: J1.5
AUDIO_CV_IN_1: J7.6, J_AUDIO_CV_IN1.T
AUDIO_CV_IN_2: J7.10, J_AUDIO_CV_IN2.T
AUDIO_CV_OUT_1: J8.5, J_AUDIO_CV_OUT1.T
AUDIO_CV_OUT_2: J8.2, J_AUDIO_CV_OUT2.T
BTN_1: J4.1, U_BTN1.2
BTN_2: J4.3, U_BTN2.2
BTN_LED_1: J4.4, R1.1
GND: H3.1 (1_1), J1.1, J1.3, J1.4, J1.6, J2.1, J2.2, J8.1, J8.3, J8.4, J8.6, J_AUDIO_CV_IN1.S, J_AUDIO_CV_IN2.S, J_AUDIO_CV_OUT1.S, J_AUDIO_CV_OUT2.S, J_MIDI1.S, J_PULSE_IN1.S, J_PULSE_OUT1.S, R2.1, RV_POT1.1, RV_POT2.1, RV_POT3.1, U_BTN1.4, U_BTN1.L2, U_BTN2.4, U_BTN2.L2; also elsewhere on the board
LED_1: J5.1; also elsewhere on the board
LED_2: J5.3; also elsewhere on the board
LED_3: J5.5; also elsewhere on the board
LED_4: J5.6; also elsewhere on the board
LED_5: J5.4; also elsewhere on the board
LED_6: J5.2; also elsewhere on the board
MIDI_4R: J6.3, J_MIDI1.TN
MIDI_5T: J6.1, J_MIDI1.T
unnamed: D7.1 (K), R15.1
unnamed: J_PULSE_OUT1.T, R15.2
unnamed: R1.2, U_BTN1.L1
POT_1: J7.5, RV_POT1.2
POT_2: J7.3, RV_POT2.2
POT_3: J7.1, RV_POT3.2
PULSE_IN: J6.2, J_PULSE_IN1.T, R2.2
PULSE_OUT: D7.2 (A), J6.4

Notes on the sheet:
R15 only for testing purposes
UI power connection

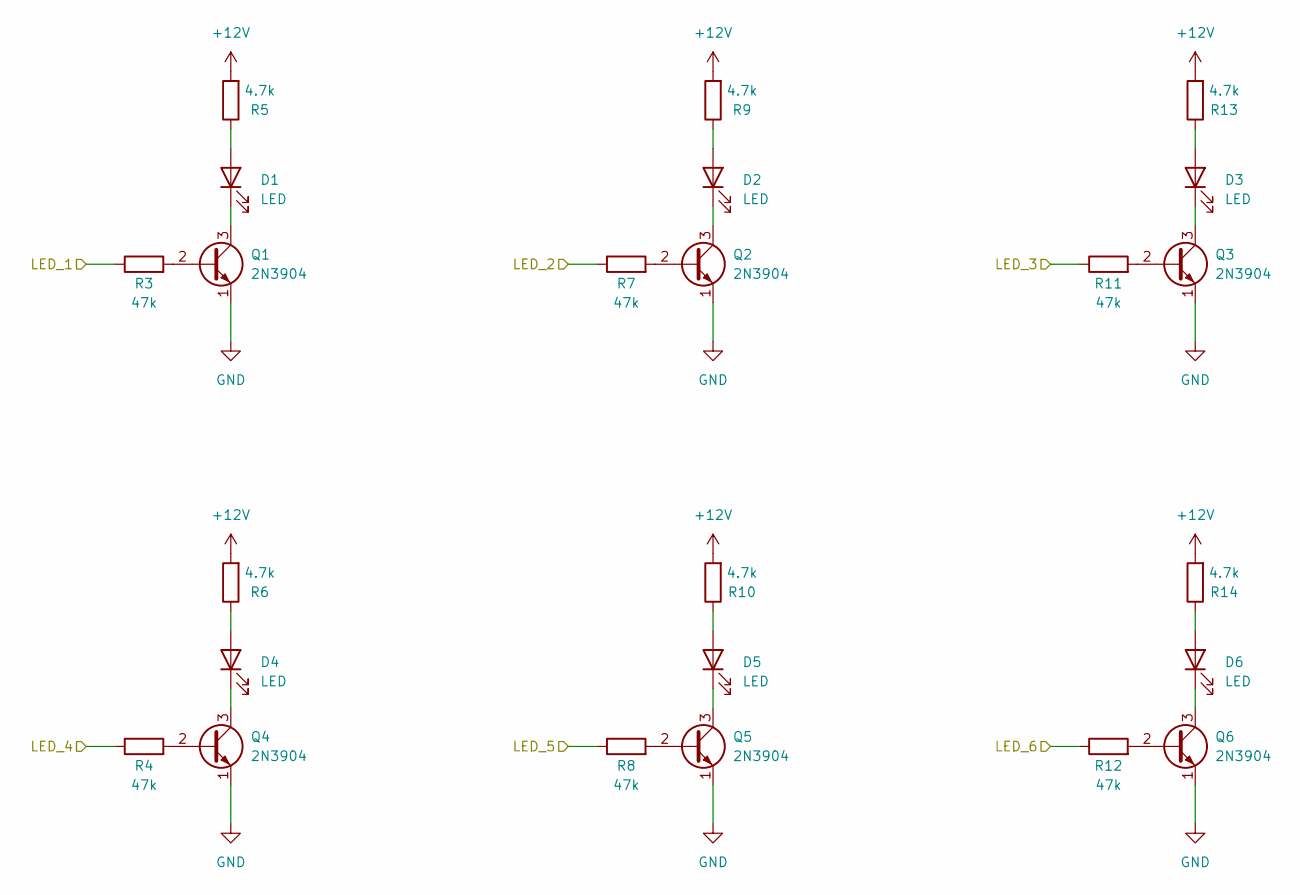
[picture p48: schematic leds.kicad_sch, Brain UI]

Parts:
D1, D2, D3, D4, D5, D6: LED; LED_D3.0mm
Q1, Q2, Q3, Q4, Q5, Q6: 2N3904; TO-92_Inline_Wide; Part no. 637-2N3904
R3, R4, R7, R8, R11, R12: 47k; R_Axial_DIN0207_L6.3mm_D2.5mm_P7.62mm_Horizontal; Part no. 603-MFR-25FRF52-47K; LCSC C25803
R5, R6, R9, R10, R13, R14: 4.7k; R_Axial_DIN0207_L6.3mm_D2.5mm_P7.62mm_Horizontal; Part no. 603-MFR25SFTF52-4K7

Connections:
+12V: R5.2, R6.2, R9.2, R10.2, R13.2, R14.2; also elsewhere on the board
GND: Q1.1 (E), Q2.1 (E), Q3.1 (E), Q4.1 (E), Q5.1 (E), Q6.1 (E); also elsewhere on the board
LED_1: R3.1; also elsewhere on the board
LED_2: R7.1; also elsewhere on the board
LED_3: R11.1; also elsewhere on the board
LED_4: R4.1; also elsewhere on the board
LED_5: R8.1; also elsewhere on the board
LED_6: R12.1; also elsewhere on the board
unnamed: D1.2 (A), R5.1
unnamed: D1.1 (K), Q1.3 (C)
unnamed: D2.2 (A), R9.1
unnamed: D2.1 (K), Q2.3 (C)
unnamed: D3.2 (A), R13.1
unnamed: D3.1 (K), Q3.3 (C)
unnamed: D4.2 (A), R6.1
unnamed: D4.1 (K), Q4.3 (C)
unnamed: D5.2 (A), R10.1
unnamed: D5.1 (K), Q5.3 (C)
unnamed: D6.2 (A), R14.1
unnamed: D6.1 (K), Q6.3 (C)
unnamed: Q1.2 (B), R3.2
unnamed: Q2.2 (B), R7.2
unnamed: Q3.2 (B), R11.2
unnamed: Q4.2 (B), R4.2
unnamed: Q5.2 (B), R8.2
unnamed: Q6.2 (B), R12.2

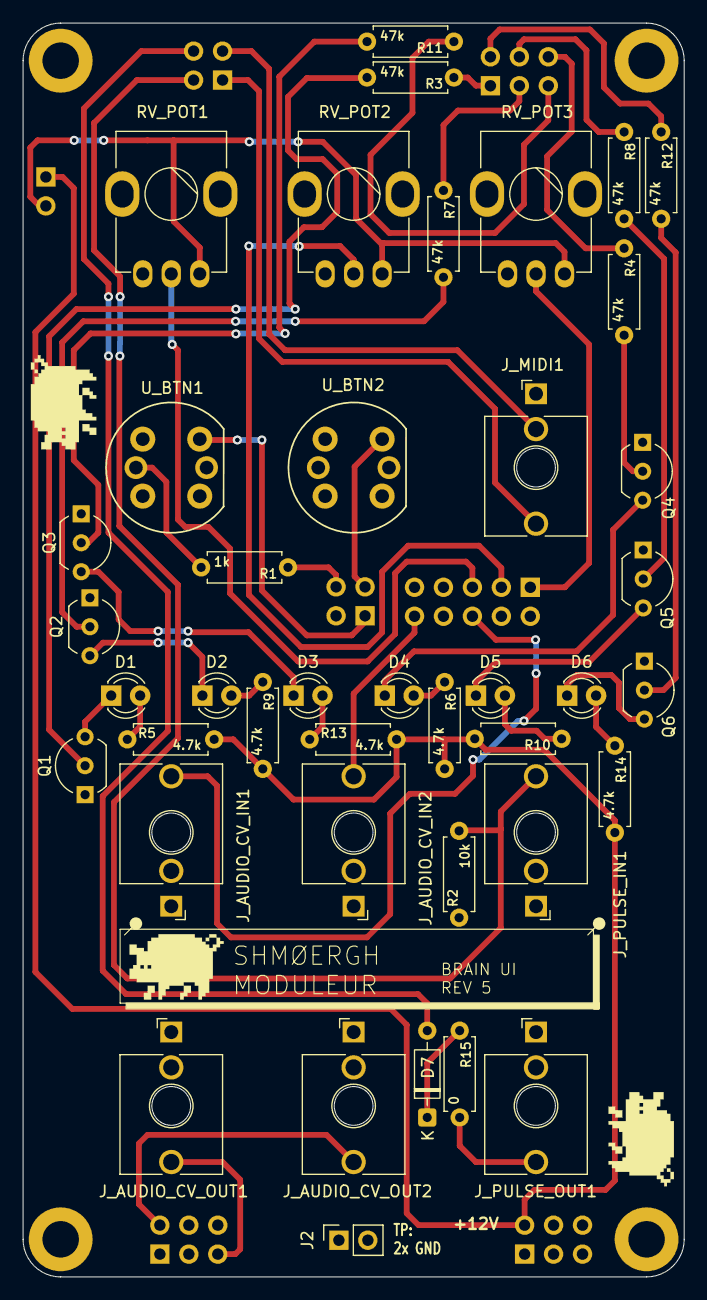
[picture p49: board brain-ui.kicad_pcb from above]

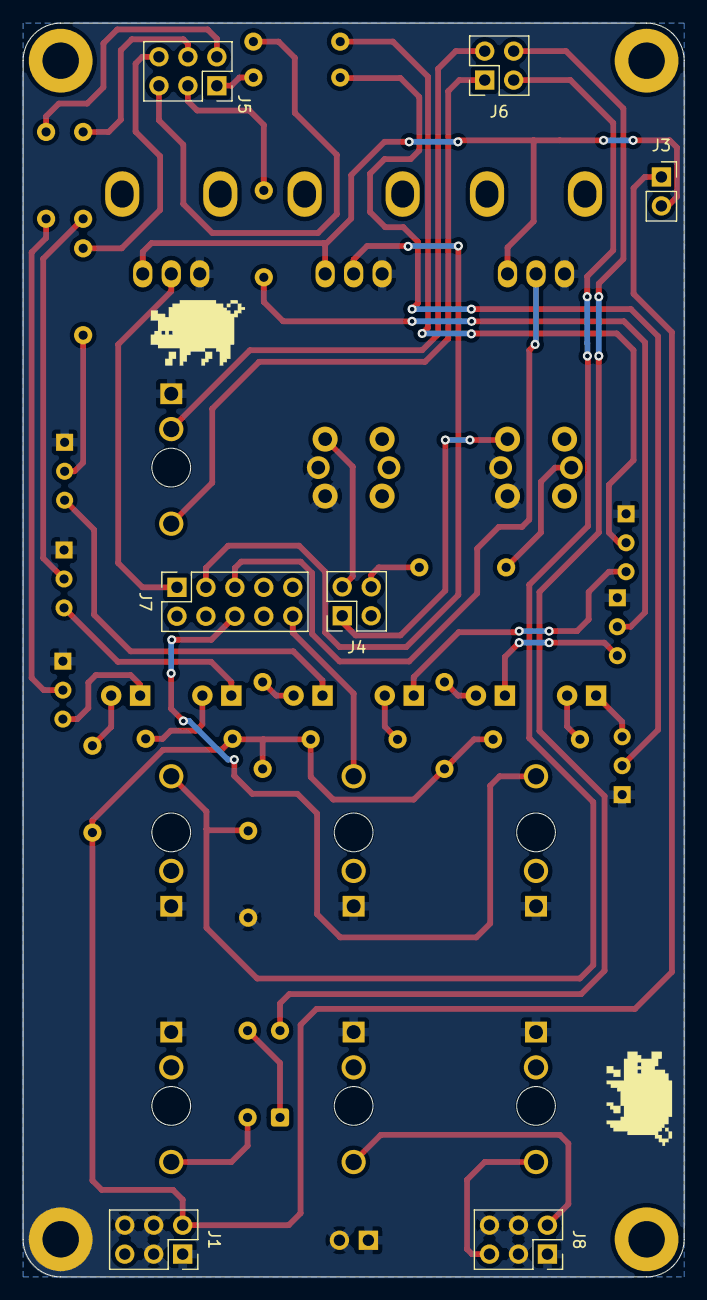
[picture p50: board brain-ui.kicad_pcb from below]

Board: 2 copper layers, 58.0 x 110.0 mm, 52 parts (7 on the bottom side), 44 nets.
