DanD222/moduleur/modules/07-brain/electronics/core/brain-core.kicad_pcb

## KiCad design modules/07-brain/electronics/core/brain-core.kicad_pcb (2026-05-23)

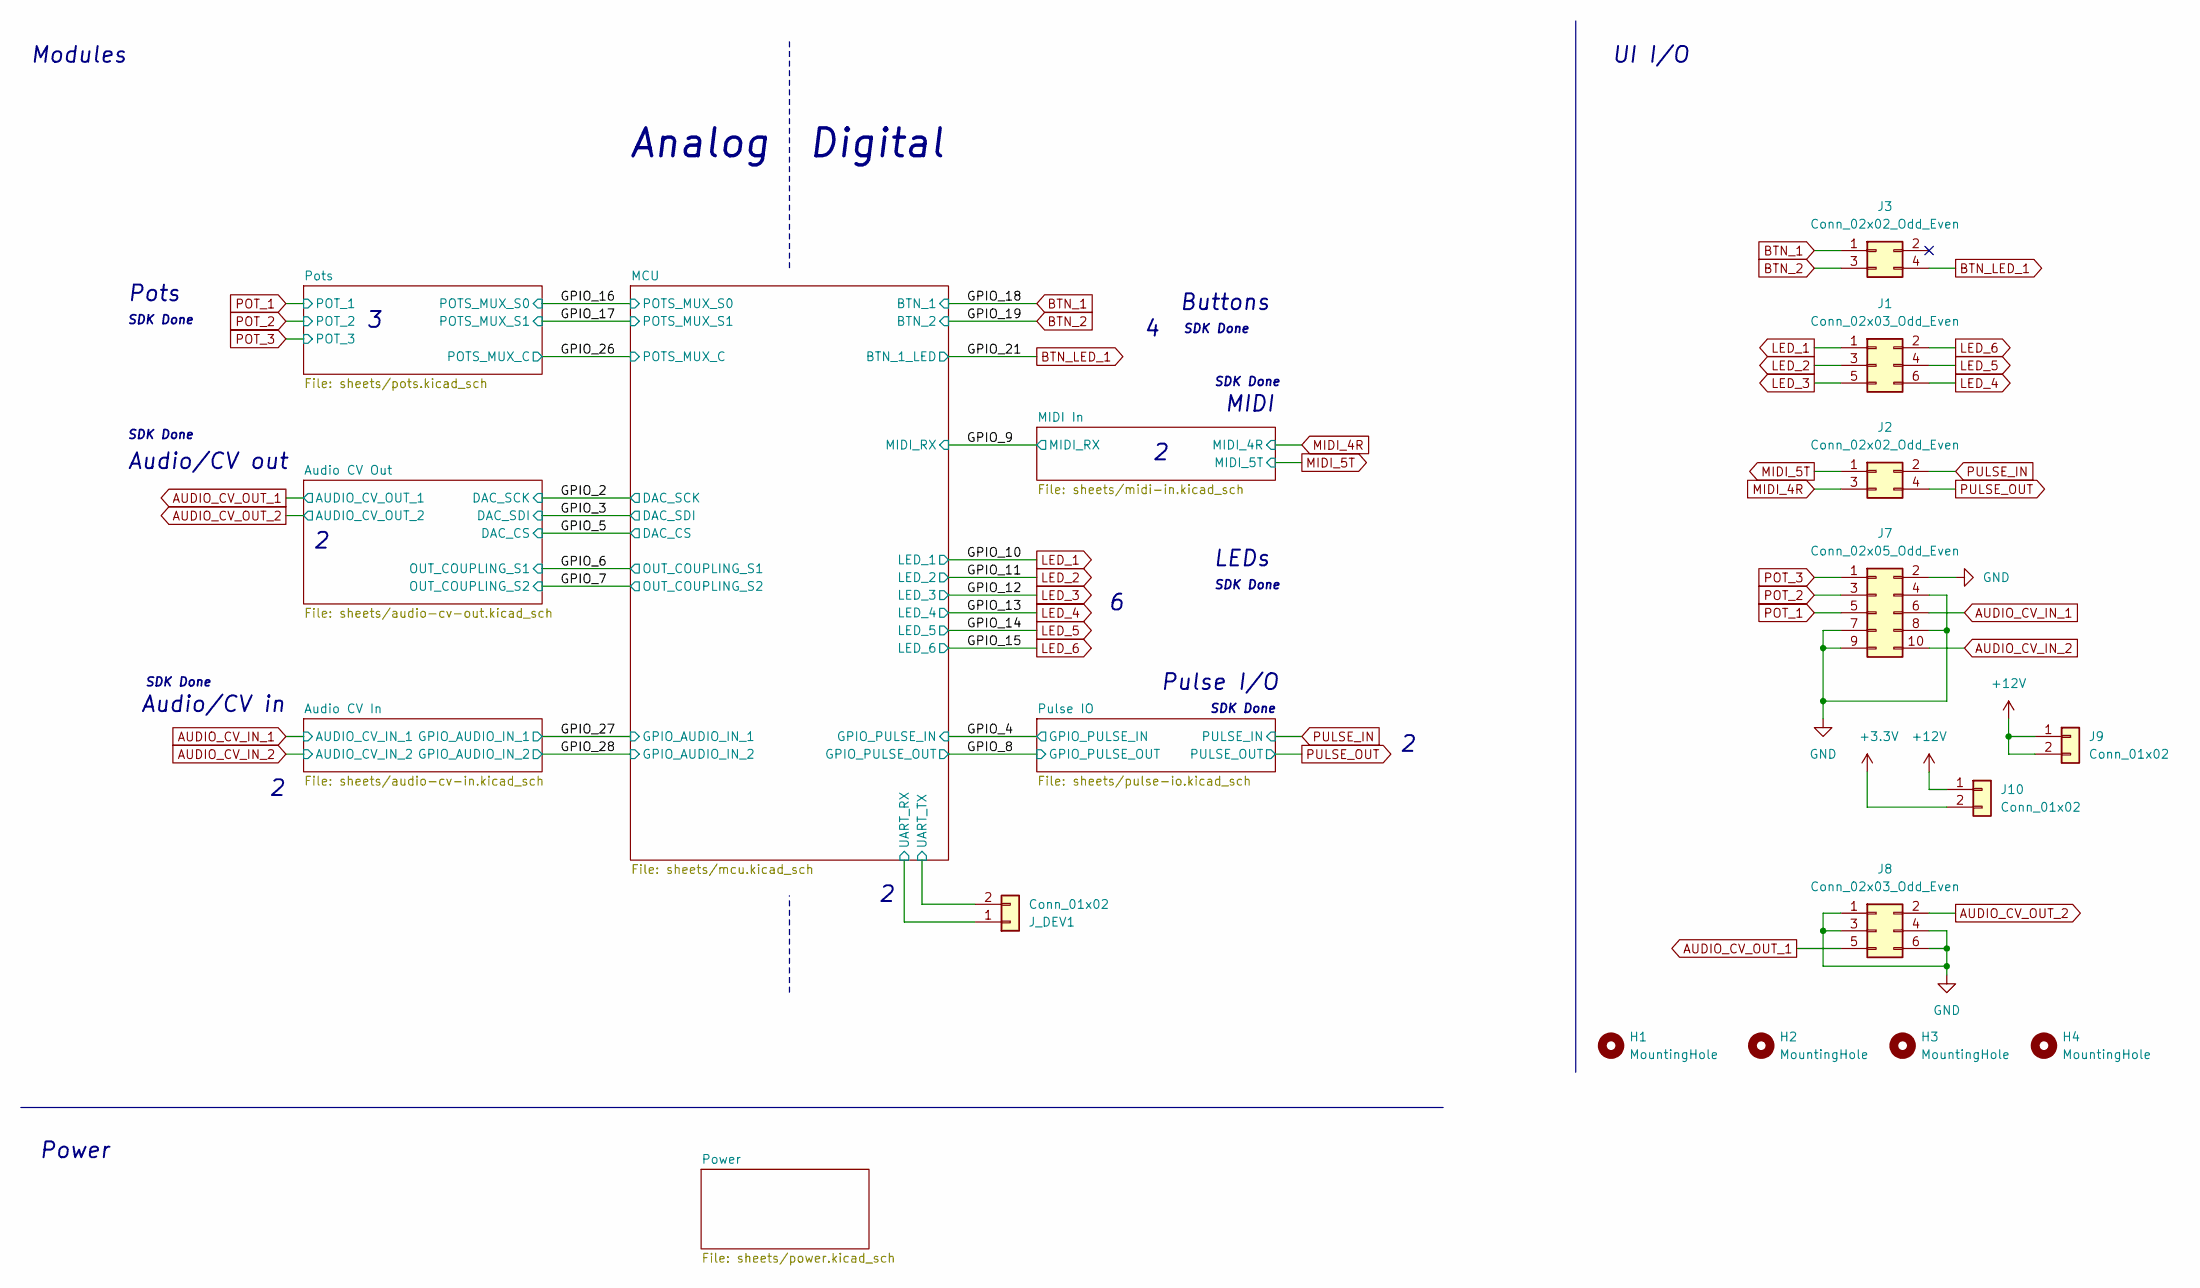
[picture p62: schematic brain-core.kicad_sch, Brain Core]

Parts:
H1, H2, H3, H4: MountingHole; MountingHole_3.2mm_M3_DIN965_Pad
J1, J8: Conn_02x03_Odd_Even; PinHeader_2x03_P2.54mm_Vertical; Mouser Part no. 200-TSW10307TD
J2, J3: Conn_02x02_Odd_Even; PinHeader_2x02_P2.54mm_Vertical; Mouser Part no. 200-HTSW10207TD
J7: Conn_02x05_Odd_Even; PinHeader_2x05_P2.54mm_Vertical; Mouser Part no. 200-TSW10507TD
J9, J10: Conn_01x02; PinHeader_1x02_P2.54mm_Vertical; Mouser Part no. 200-HTSW10207TS
J_DEV1: Conn_01x02; PinHeader_1x02_P2.54mm_Horizontal; Mouser Part no. 200-HTSW11008FSRA

Connections:
+12V: J9.1, J9.2, J10.1; also elsewhere on the board
/MCU/UART_RX: J_DEV1.1; also elsewhere on the board
/MCU/UART_TX: J_DEV1.2; also elsewhere on the board
AUDIO_CV_IN_1: J7.6; also elsewhere on the board
AUDIO_CV_IN_2: J7.10; also elsewhere on the board
AUDIO_CV_OUT_1: J8.5; also elsewhere on the board
AUDIO_CV_OUT_2: J8.2; also elsewhere on the board
BTN_1: J3.1; also elsewhere on the board
BTN_2: J3.3; also elsewhere on the board
BTN_LED_1: J3.4; also elsewhere on the board
LED_1: J1.1; also elsewhere on the board
LED_2: J1.3; also elsewhere on the board
LED_3: J1.5; also elsewhere on the board
LED_4: J1.6; also elsewhere on the board
LED_5: J1.4; also elsewhere on the board
LED_6: J1.2; also elsewhere on the board
POT_1: J7.5; also elsewhere on the board
POT_2: J7.3; also elsewhere on the board
POT_3: J7.1; also elsewhere on the board
PULSE_IN: J2.2; also elsewhere on the board
PULSE_OUT: J2.4; also elsewhere on the board

Notes on the sheet:
Power
Audio/CV in
Pulse I/O
Audio/CV out
SDK Done
LEDs
Modules
Buttons
Analog
Pots
Digital
MIDI
UI I/O

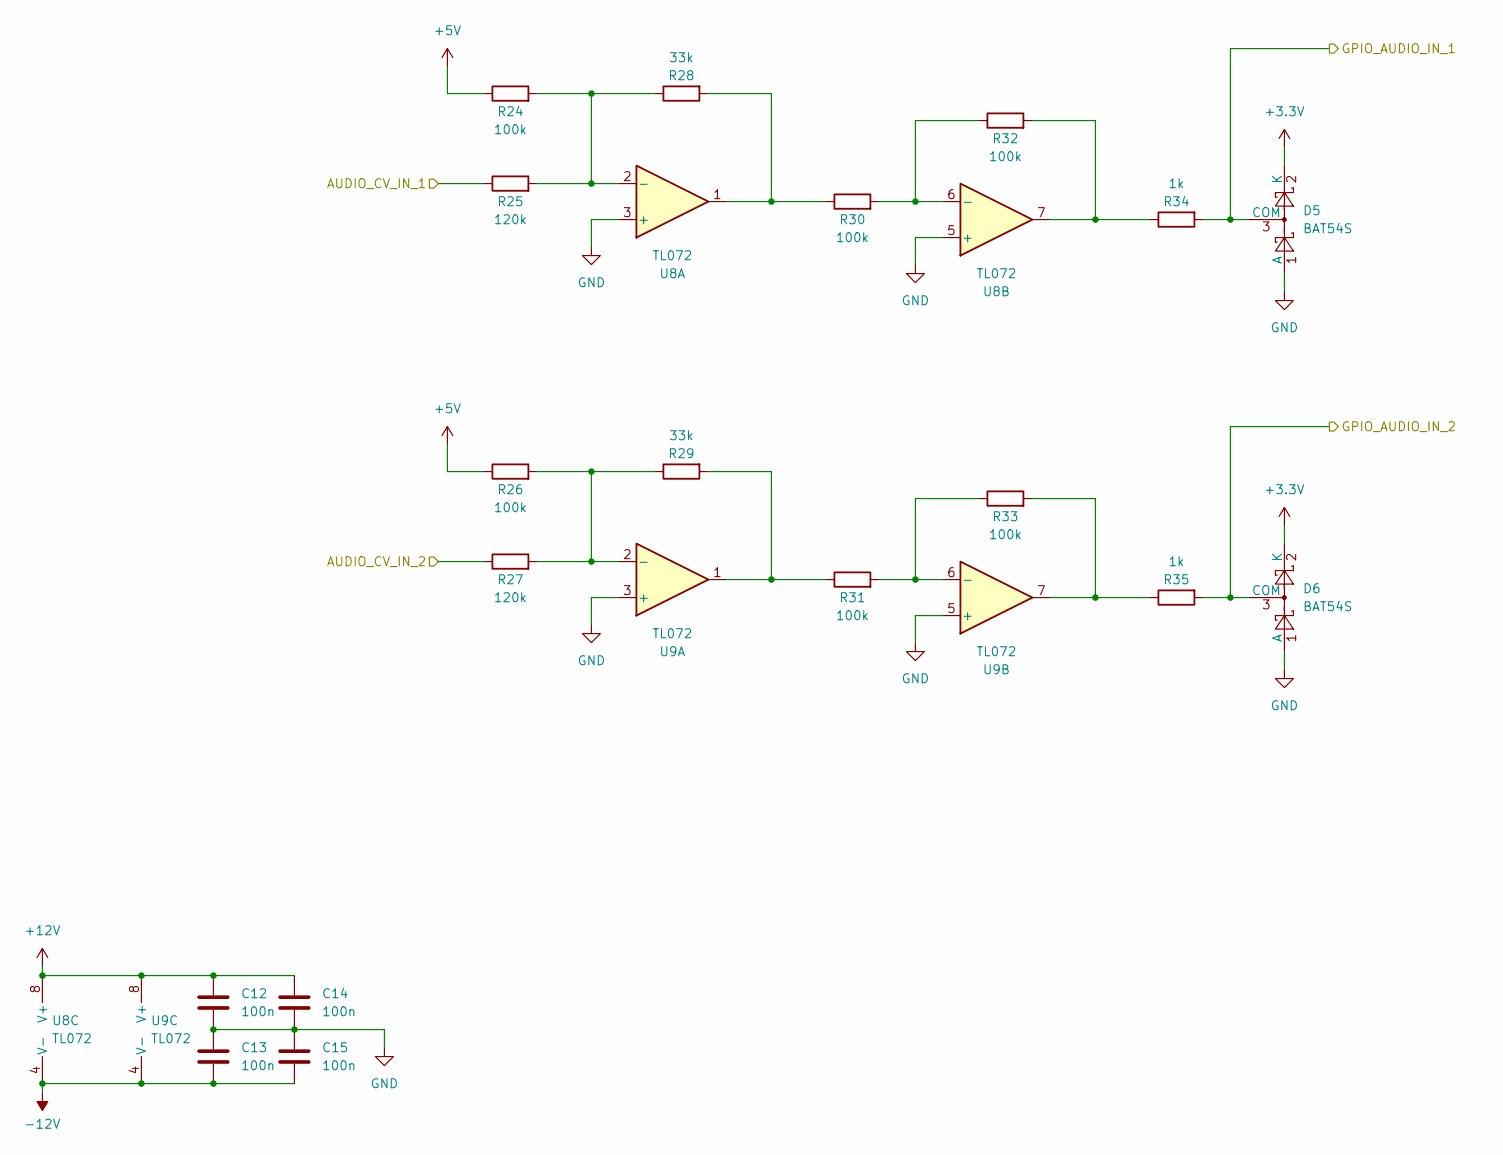
[picture p63: schematic audio-cv-in.kicad_sch, Brain Core]

Parts:
C12, C13, C14, C15: 100n; C_0603_1608Metric; LCSC C14663
D5, D6: BAT54S; SOT-23; LCSC C7420333
R24, R26, R30, R31, R32, R33: 100k; R_0603_1608Metric; LCSC C25803
R25, R27: 120k; R_0603_1608Metric; LCSC C25808
R28, R29: 33k; R_0603_1608Metric; LCSC C4216
R34, R35: 1k; R_0603_1608Metric; LCSC C21190
U8, U9: TL072; SOIC-8_3.9x4.9mm_P1.27mm; LCSC C6961

Connections:
+5V: R24.1, R26.1; also elsewhere on the board
+12V: C12.1, C14.1, U8.8 (V+), U9.8 (V+); also elsewhere on the board
-12V: C13.2, C15.2, U8.4 (V-), U9.4 (V-); also elsewhere on the board
/GPIO_27: D5.3 (COM), R34.2; also elsewhere on the board
/GPIO_28: D6.3 (COM), R35.2; also elsewhere on the board
AUDIO_CV_IN_1: R25.1; also elsewhere on the board
AUDIO_CV_IN_2: R27.1; also elsewhere on the board
unnamed: R28.2, R30.1, U8.1
unnamed: R29.2, R31.1, U9.1
unnamed: R32.2, R34.1, U8.7
unnamed: R33.2, R35.1, U9.7
unnamed: R24.2, R25.2, R28.1, U8.2 (-)
unnamed: R30.2, R32.1, U8.6 (-)
unnamed: R26.2, R27.2, R29.1, U9.2 (-)
unnamed: R31.2, R33.1, U9.6 (-)
