DanD222/moduleur/modules/07-brain/electronics/core/brain-core.kicad_pcb

## KiCad design modules/07-brain/electronics/core/brain-core.kicad_pcb (continued)

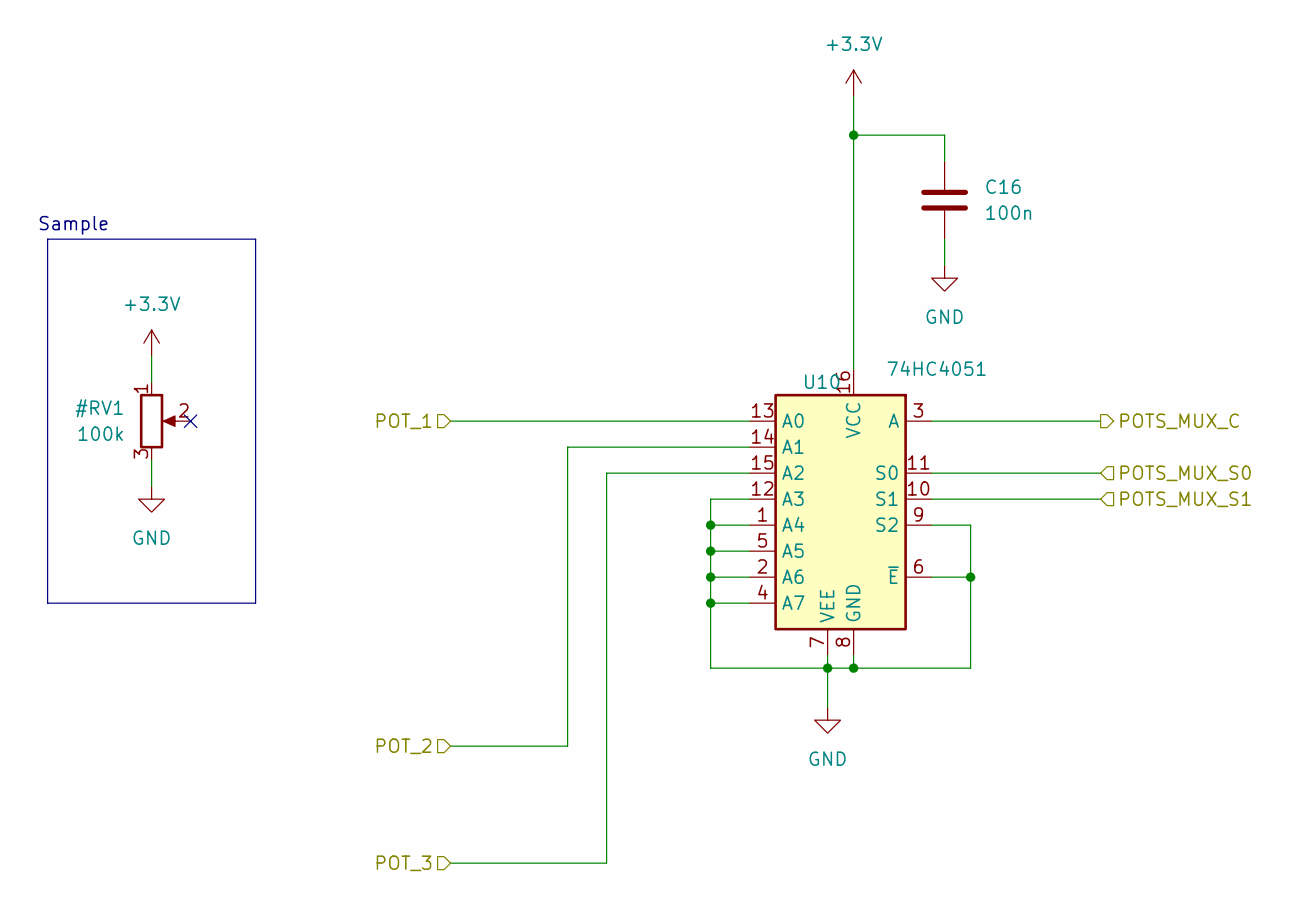
[picture p64: schematic pots.kicad_sch, Brain Core]

Parts:
C16: 100n; C_0603_1608Metric; LCSC C14663
U10: 74HC4051; SOIC-16_3.9x9.9mm_P1.27mm; LCSC C9386

Connections:
/GPIO_16: U10.11 (S0); also elsewhere on the board
/GPIO_17: U10.10 (S1); also elsewhere on the board
/GPIO_26: U10.3 (A); also elsewhere on the board
POT_1: U10.13 (A0); also elsewhere on the board
POT_2: U10.14 (A1); also elsewhere on the board
POT_3: U10.15 (A2); also elsewhere on the board

Notes on the sheet:
Sample

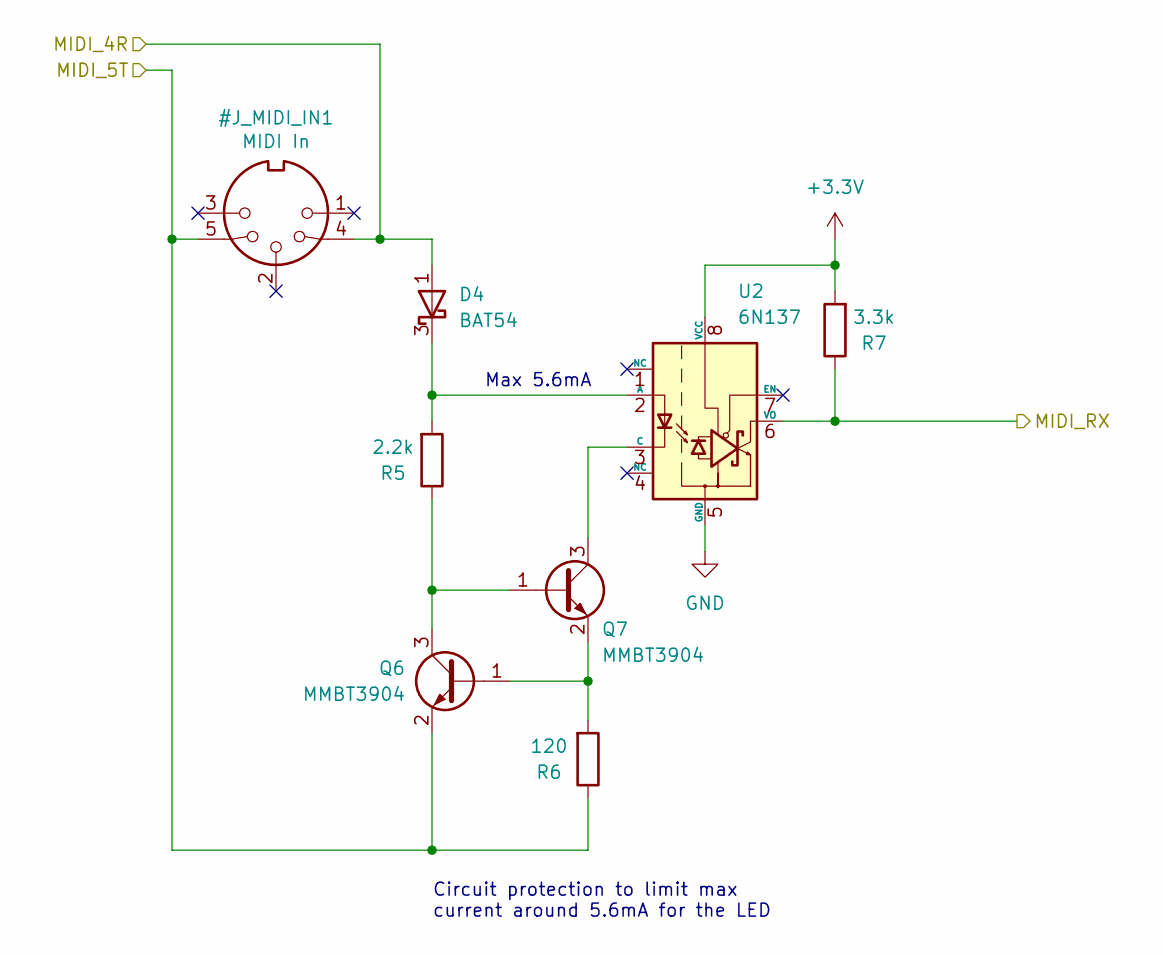
[picture p65: schematic midi-in.kicad_sch, Brain Core]

Parts:
D4: BAT54; SOT-23; LCSC C22466368
Q6, Q7: MMBT3904; SOT-23; LCSC C20526
R5: 2.2k; R_0603_1608Metric; LCSC C4190
R6: 120; R_0603_1608Metric; LCSC C22787
R7: 3.3k; R_0603_1608Metric; LCSC C22978
U2: 6N137; SOP-8_6.605x9.655mm_P2.54mm; LCSC C92651

Connections:
/GPIO_9: R7.1, U2.6 (VO); also elsewhere on the board
unnamed: D4.3 (K), R5.2, U2.2 (A)
unnamed: Q6.1 (B), Q7.2 (E), R6.2
unnamed: Q6.3 (C), Q7.1 (B), R5.1
unnamed: Q7.3 (C), U2.3 (C)

Notes on the sheet:
Max 5.6mA
Circuit protection to limit max current around 5.6mA for the LED

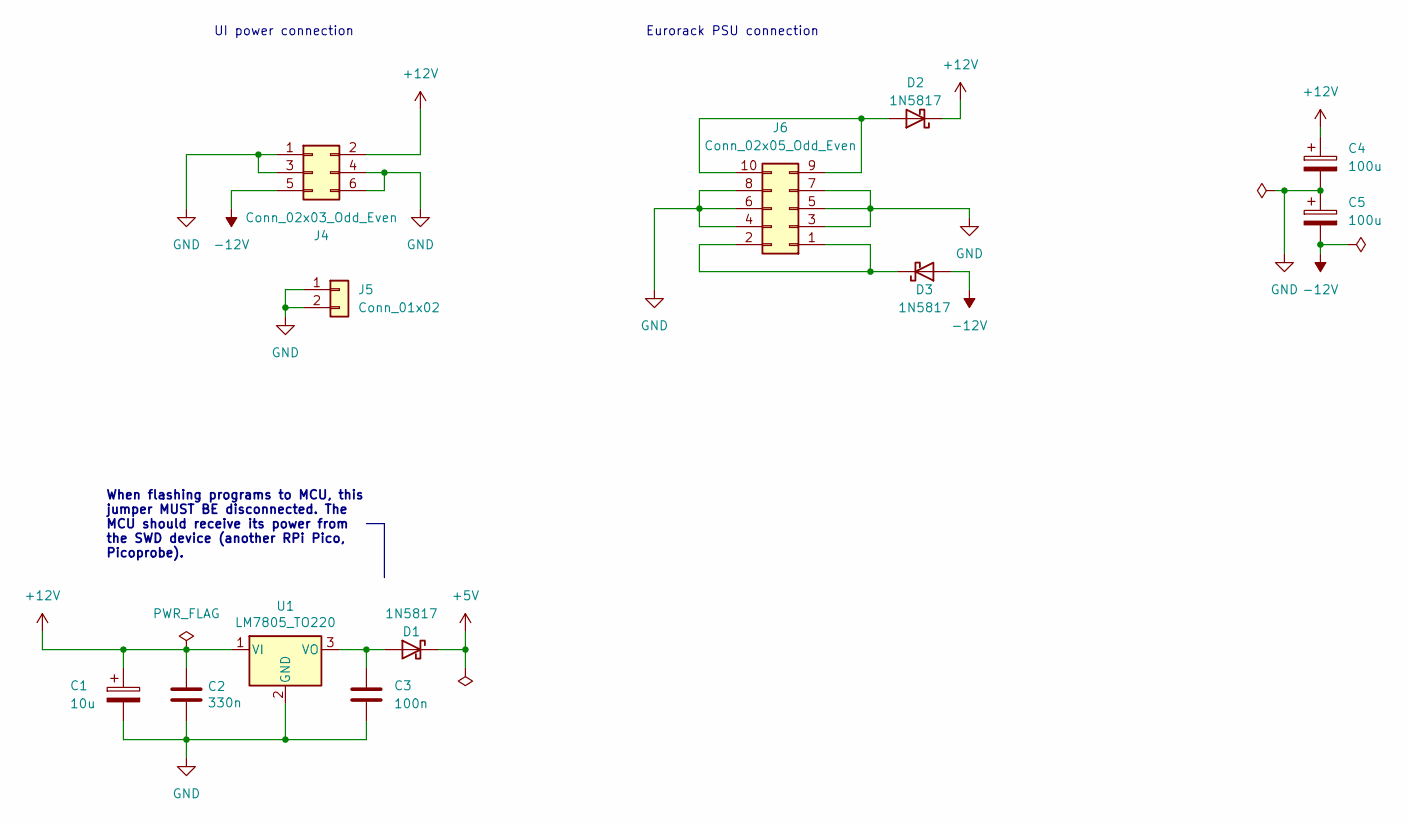
[picture p66: schematic power.kicad_sch, Brain Core]

Parts:
C1: 10u; CP_Elec_4x5.4; LCSC C46550410
C2: 330n; C_0603_1608Metric_Pad1.08x0.95mm_HandSolder; LCSC C188679
C3: 100n; C_0603_1608Metric; LCSC C14663
C4, C5: 100u; CP_Elec_6.3x7.7; LCSC C2836442
D1, D2, D3: 1N5817; D_SOD-323; LCSC C5190152
J4: Conn_02x03_Odd_Even; PinHeader_2x03_P2.54mm_Vertical; Mouser Part no. 200-TSW10307TD
J5: Conn_01x02; PinHeader_1x02_P2.54mm_Vertical; Mouser Part no. 200-HTSW10207TS
J6: Conn_02x05_Odd_Even; IDC-Header_2x05_P2.54mm_Horizontal; Mouser Part no. 571-5103310-1
U1: LM7805_TO220; TO-220-3_Horizontal_TabDown; Part No. 926-LM7805CT/NOPB; Mouser Part no. 926-LM7805CT/NOPB

Connections:
+5V: D1.1 (K); also elsewhere on the board
+12V: C1.1, C2.1, C4.1, D2.1 (K), J4.2, U1.1 (VI); also elsewhere on the board
-12V: C5.2, D3.2 (A), J4.5; also elsewhere on the board
unnamed: C3.1, D1.2 (A), U1.3 (VO)
unnamed: D2.2 (A), J6.9, J6.10
unnamed: D3.1 (K), J6.1, J6.2

Notes on the sheet:
UI power connection
When flashing programs to MCU, this jumper MUST BE disconnected. The MCU should receive its power from the SWD device (another RPi Pico, Picoprobe).
Eurorack PSU connection

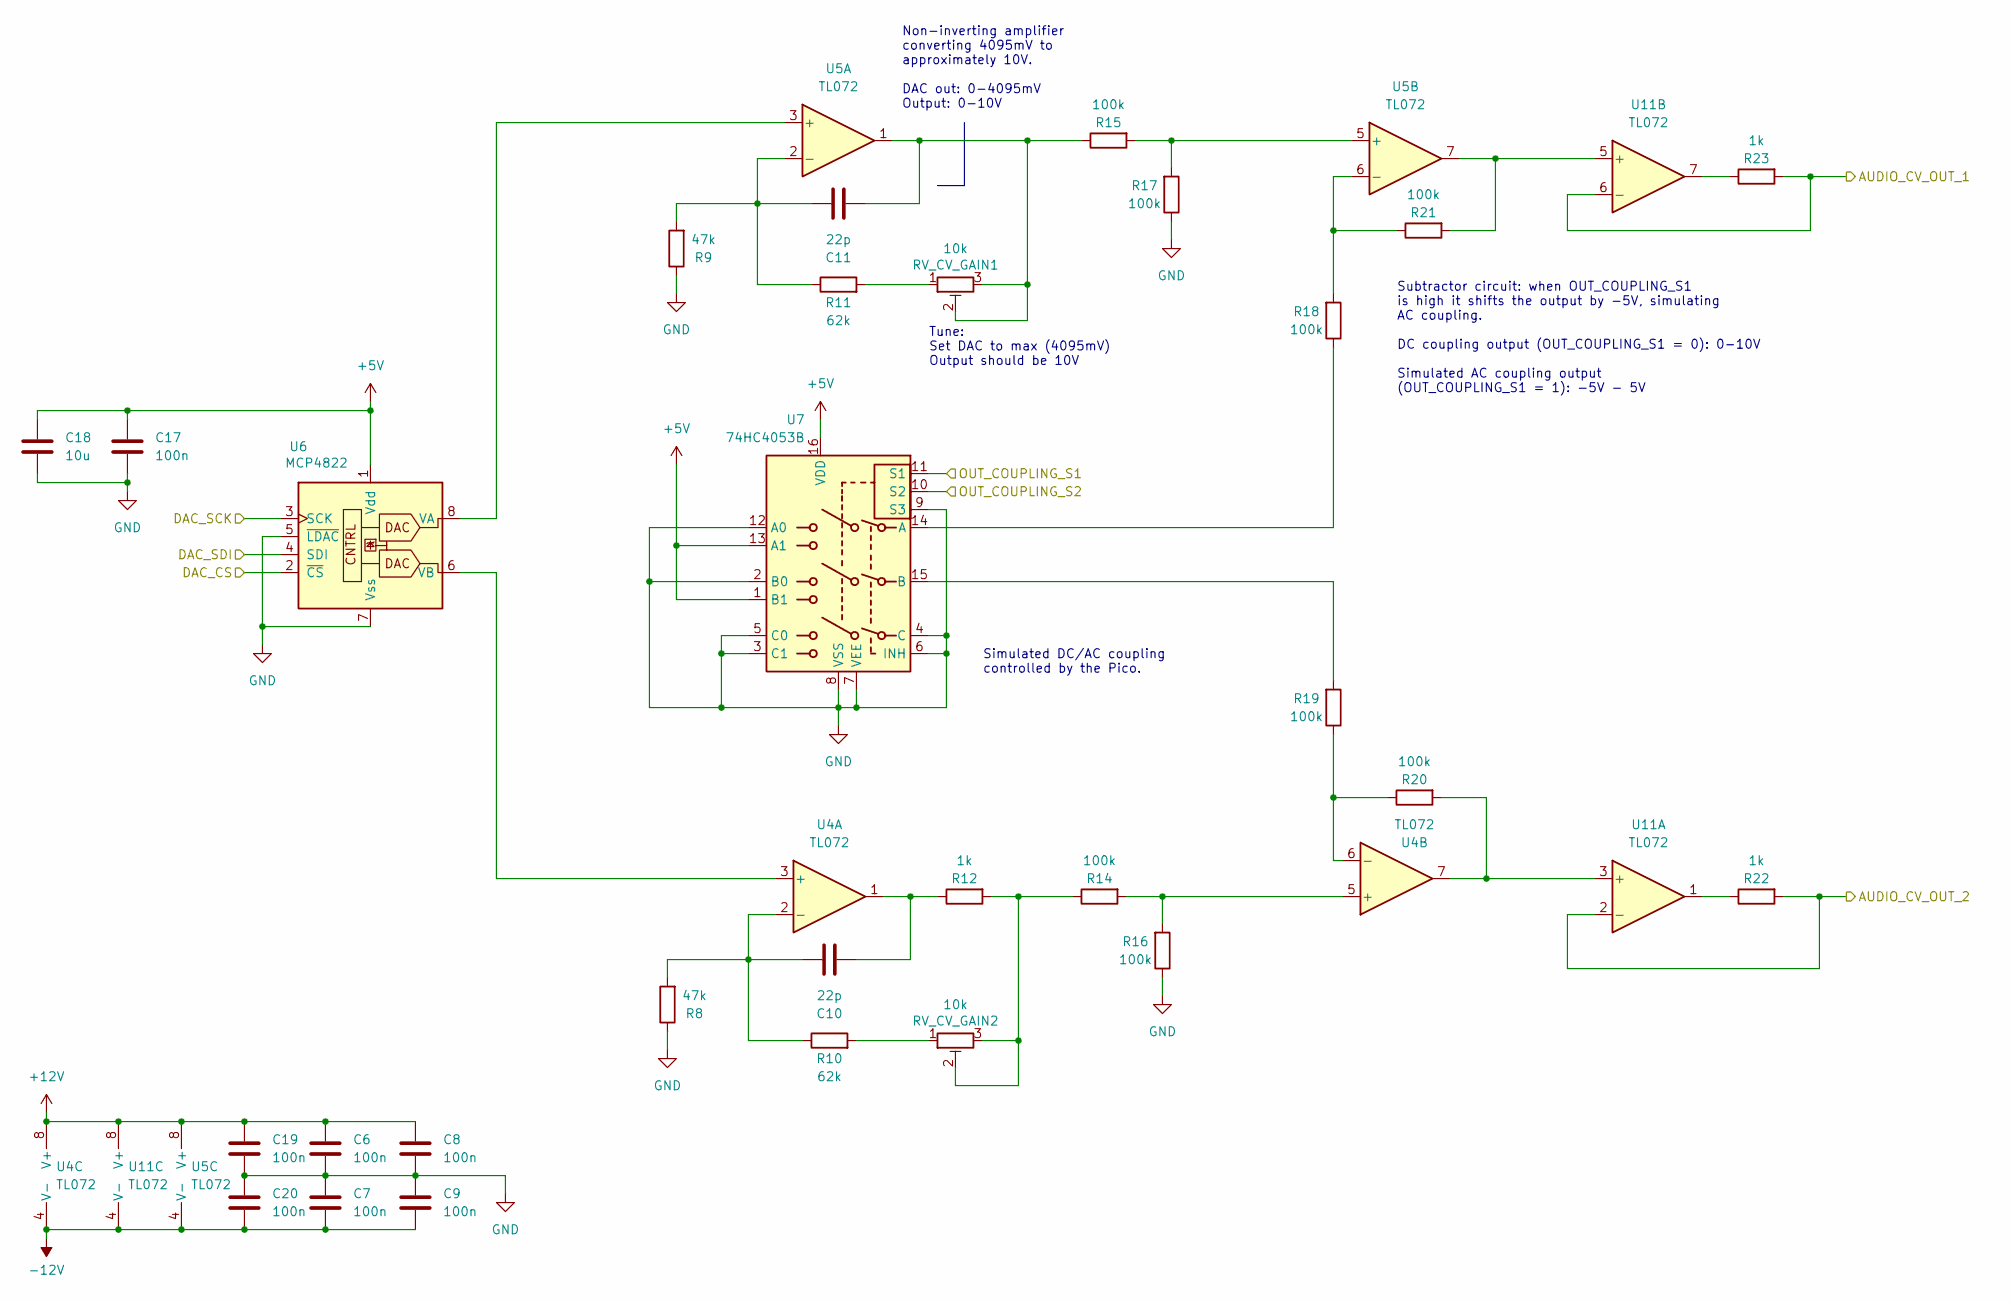
[picture p67: schematic audio-cv-out.kicad_sch, Brain Core]

Parts:
C6, C7, C8, C9, C17, C19, C20: 100n; C_0603_1608Metric; LCSC C14663
C10, C11: 22p; C_0603_1608Metric; LCSC C1653
C18: 10u; C_0603_1608Metric; LCSC C19702
R8, R9: 47k; R_0603_1608Metric; LCSC C25819
R10, R11: 62k; R_0603_1608Metric; LCSC C23221
R12, R22, R23: 1k; R_0603_1608Metric; LCSC C21190
R14, R15, R16, R17, R18, R19, R20, R21: 100k; R_0603_1608Metric; LCSC C25803
RV_CV_GAIN1, RV_CV_GAIN2: 10k; Potentiometer_ACP_CA6-H2,5_Horizontal; Part No. 531-PT6KH-10K; Mouser Part no. 774-06TR4AA103CP
U4, U5, U11: TL072; SOIC-8_3.9x4.9mm_P1.27mm; LCSC C6961
U6: MCP4822; SOIC-8_3.9x4.9mm_P1.27mm; LCSC C623653
U7: 74HC4053B; SOIC-16_3.9x9.9mm_P1.27mm; LCSC C5647

Connections:
+5V: C17.1, C18.1, U6.1 (Vdd), U7.1 (B1), U7.13 (A1), U7.16 (VDD); also elsewhere on the board
+12V: C6.1, C8.1, C19.1, U4.8 (V+), U5.8 (V+), U11.8 (V+); also elsewhere on the board
-12V: C7.2, C9.2, C20.2, U4.4 (V-), U5.4 (V-), U11.4 (V-); also elsewhere on the board
/GPIO_2: U6.3 (SCK); also elsewhere on the board
/GPIO_3: U6.4 (SDI); also elsewhere on the board
/GPIO_5: U6.2 (~CS); also elsewhere on the board
/GPIO_6: U7.11 (S1); also elsewhere on the board
/GPIO_7: U7.10 (S2); also elsewhere on the board
AUDIO_CV_OUT_1: R23.2, U11.6 (-); also elsewhere on the board
AUDIO_CV_OUT_2: R22.2, U11.2 (-); also elsewhere on the board
unnamed: C10.2, R12.1, U4.1
unnamed: C11.2, R15.1, RV_CV_GAIN1.2, RV_CV_GAIN1.3, U5.1
unnamed: R10.2, RV_CV_GAIN2.1
unnamed: R11.2, RV_CV_GAIN1.1
unnamed: R12.2, R14.1, RV_CV_GAIN2.2, RV_CV_GAIN2.3
unnamed: R22.1, U11.1
unnamed: R23.1, U11.7
unnamed: U4.3 (+), U6.6 (VB)
unnamed: C10.1, R8.2, R10.1, U4.2 (-)
unnamed: R14.2, R16.2, U4.5 (+)
unnamed: R19.1, R20.1, U4.6 (-)
unnamed: U5.3 (+), U6.8 (VA)
unnamed: C11.1, R9.2, R11.1, U5.2 (-)
unnamed: R15.2, R17.2, U5.5 (+)
unnamed: R18.2, R21.1, U5.6 (-)
unnamed: R18.1, U7.14 (A)
unnamed: R19.2, U7.15 (B)
unnamed: R20.2, U4.7, U11.3 (+)
unnamed: R21.2, U5.7, U11.5 (+)

Notes on the sheet:
Simulated DC/AC coupling controlled by the Pico.
Subtractor circuit: when OUT_COUPLING_S1 is high it shifts the output by -5V, simulating AC coupling. DC coupling output (OUT_COUPLING_S1 = 0): 0-10V Simulated AC coupling output (OUT_COUPLING_S1 = 1): -5V - 5V
Tune: Set DAC to max (4095mV) Output should be 10V
Non-inverting amplifier converting 4095mV to approximately 10V. DAC out: 0-4095mV Output: 0-10V

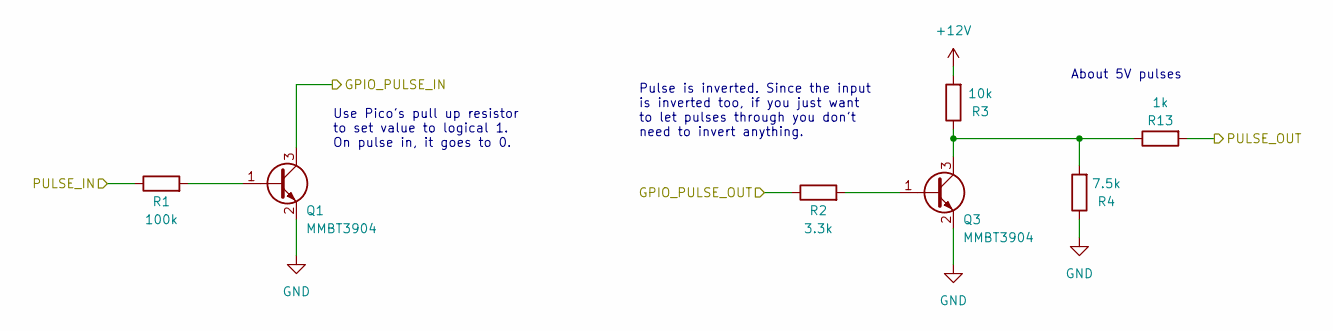
[picture p68: schematic pulse-io.kicad_sch, Brain Core]

Parts:
Q1, Q3: MMBT3904; SOT-23; LCSC C20526
R1: 100k; R_0603_1608Metric; LCSC C25803
R2: 3.3k; R_0603_1608Metric; LCSC C22978
R3: 10k; R_0603_1608Metric; LCSC C25804
R4: 7.5k; R_0603_1608Metric; LCSC C23234
R13: 1k; R_0603_1608Metric; LCSC C21190

Connections:
+12V: R3.2; also elsewhere on the board
/GPIO_4: Q1.3 (C); also elsewhere on the board
/GPIO_8: R2.1; also elsewhere on the board
unnamed: Q1.1 (B), R1.2
unnamed: Q3.1 (B), R2.2
unnamed: Q3.3 (C), R3.1, R4.2, R13.1
PULSE_IN: R1.1; also elsewhere on the board
PULSE_OUT: R13.2; also elsewhere on the board

Notes on the sheet:
About 5V pulses
Use Pico's pull up resistor to set value to logical 1. On pulse in, it goes to 0.
Pulse is inverted. Since the input is inverted too, if you just want to let pulses through you don't need to invert anything.

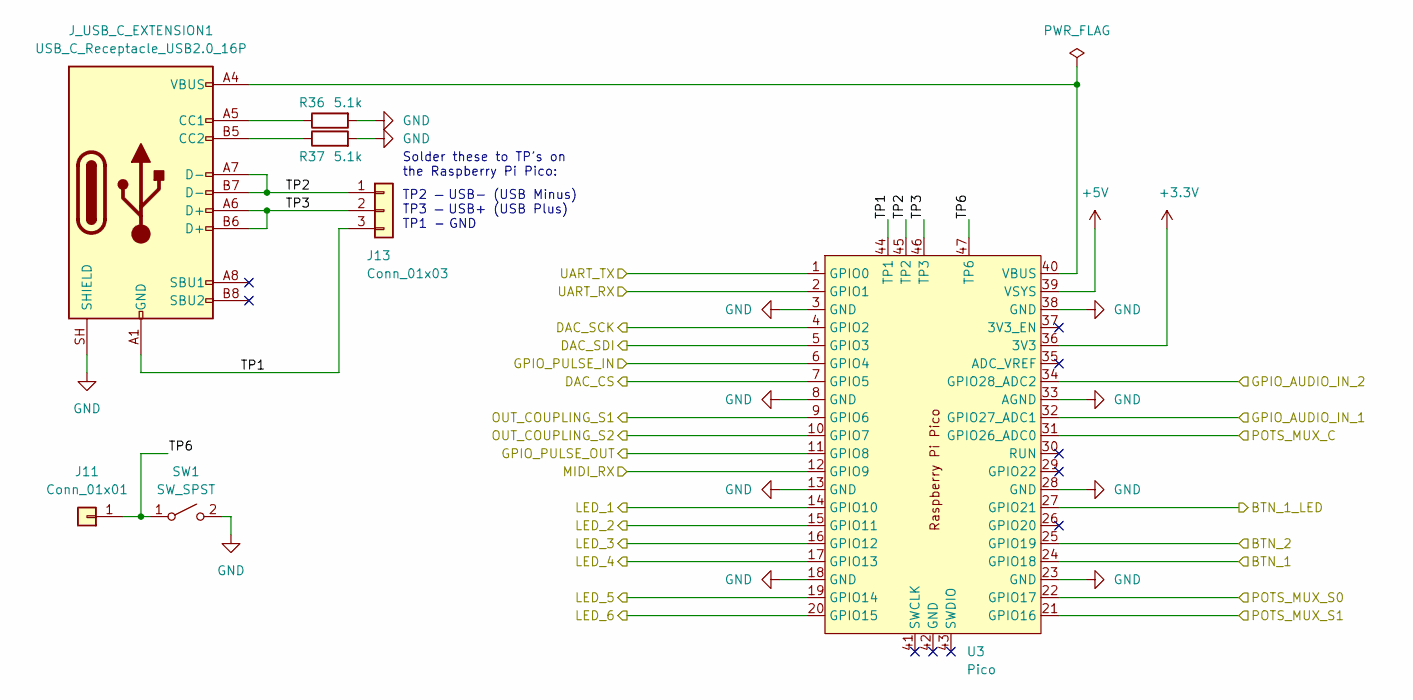
[picture p69: schematic mcu.kicad_sch, Brain Core]

Parts:
J11: Conn_01x01; PinHeader_1x01_P2.54mm_Vertical
J13: Conn_01x03; PinHeader_1x03_P2.54mm_Vertical; Mouser Part no. 200-HTSW10307TS
J_USB_C_EXTENSION1: USB_C_Receptacle_USB2.0_16P; USB_C_Receptacle_HRO_TYPE-C-31-M-12; LCSC C165948
R36, R37: 5.1k; R_0603_1608Metric; LCSC C23186
SW1: SW_SPST; SW_Tactile_SKHH_Angled
U3: Pico; RaspberryPi_Pico_Common_Unspecified; Mouser Part no. 358-SC0915

Connections:
+5V: U3.39 (VSYS); also elsewhere on the board
/GPIO_2: U3.4 (GPIO2); also elsewhere on the board
/GPIO_3: U3.5 (GPIO3); also elsewhere on the board
/GPIO_4: U3.6 (GPIO4); also elsewhere on the board
/GPIO_5: U3.7 (GPIO5); also elsewhere on the board
/GPIO_6: U3.9 (GPIO6); also elsewhere on the board
/GPIO_7: U3.10 (GPIO7); also elsewhere on the board
/GPIO_8: U3.11 (GPIO8); also elsewhere on the board
/GPIO_9: U3.12 (GPIO9); also elsewhere on the board
/GPIO_16: U3.22 (GPIO17); also elsewhere on the board
/GPIO_17: U3.21 (GPIO16); also elsewhere on the board
/GPIO_26: U3.31 (GPIO26_ADC0); also elsewhere on the board
/GPIO_27: U3.32 (GPIO27_ADC1); also elsewhere on the board
/GPIO_28: U3.34 (GPIO28_ADC2); also elsewhere on the board
/MCU/TP1: J13.3, J_USB_C_EXTENSION1.A1 (GND), J_USB_C_EXTENSION1.A12 (GND), J_USB_C_EXTENSION1.B1 (GND), J_USB_C_EXTENSION1.B12 (GND), U3.44 (TP1)
/MCU/TP2: J13.1, J_USB_C_EXTENSION1.A7 (D-), J_USB_C_EXTENSION1.B7 (D-), U3.45 (TP2)
/MCU/TP3: J13.2, J_USB_C_EXTENSION1.A6 (D+), J_USB_C_EXTENSION1.B6 (D+), U3.46 (TP3)
/MCU/TP6: J11.1 (Pin_1_1), SW1.1 (A), U3.47 (TP6)
/MCU/UART_RX: U3.2 (GPIO1); also elsewhere on the board
/MCU/UART_TX: U3.1 (GPIO0); also elsewhere on the board
BTN_1: U3.24 (GPIO18); also elsewhere on the board
BTN_2: U3.25 (GPIO19); also elsewhere on the board
BTN_LED_1: U3.27 (GPIO21); also elsewhere on the board
LED_1: U3.14 (GPIO10); also elsewhere on the board
LED_2: U3.15 (GPIO11); also elsewhere on the board
LED_3: U3.16 (GPIO12); also elsewhere on the board
LED_4: U3.17 (GPIO13); also elsewhere on the board
LED_5: U3.19 (GPIO14); also elsewhere on the board
LED_6: U3.20 (GPIO15); also elsewhere on the board
unnamed: J_USB_C_EXTENSION1.A5 (CC1), R36.1
unnamed: J_USB_C_EXTENSION1.B5 (CC2), R37.1
unnamed: J_USB_C_EXTENSION1.A4 (VBUS), J_USB_C_EXTENSION1.A9 (VBUS), J_USB_C_EXTENSION1.B4 (VBUS), J_USB_C_EXTENSION1.B9 (VBUS), U3.40 (VBUS)

Notes on the sheet:
TP2 — USB- (USB Minus) TP3 — USB+ (USB Plus) TP1 - GND
Solder these to TP's on the Raspberry Pi Pico:

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
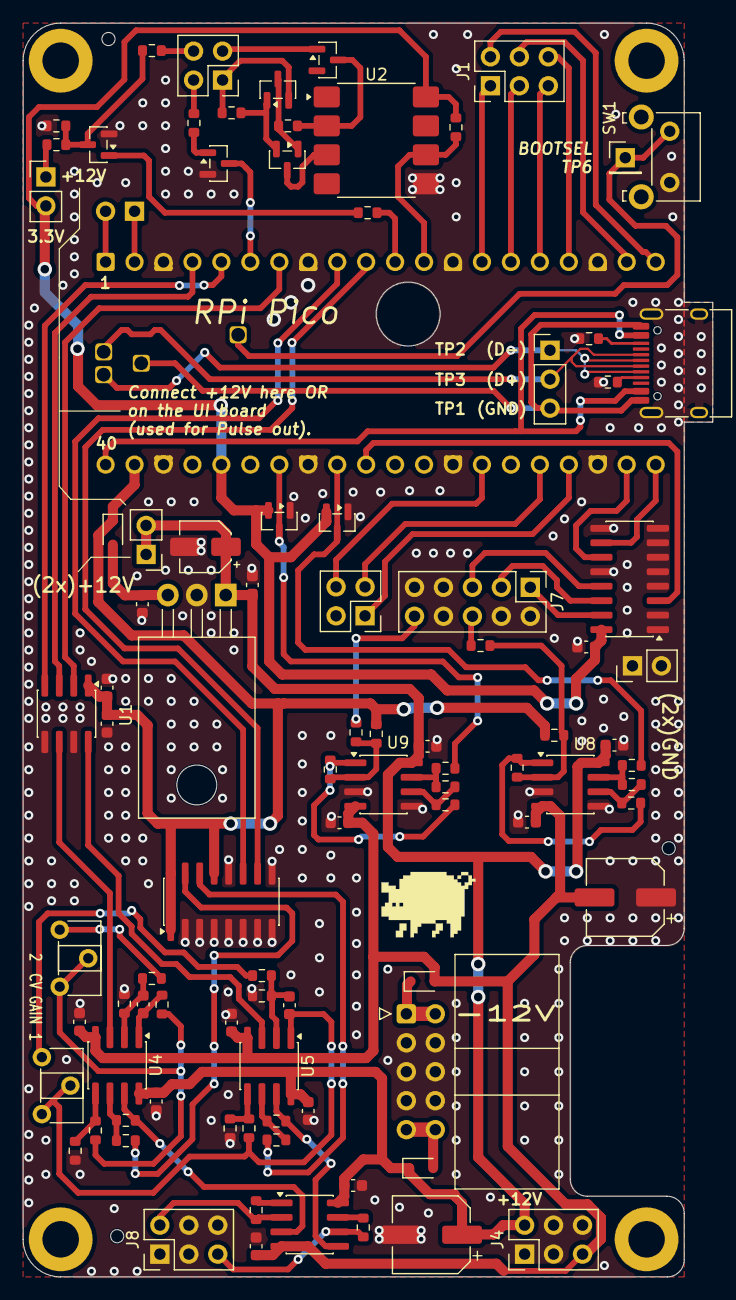
[picture p70: board brain-core.kicad_pcb from above]

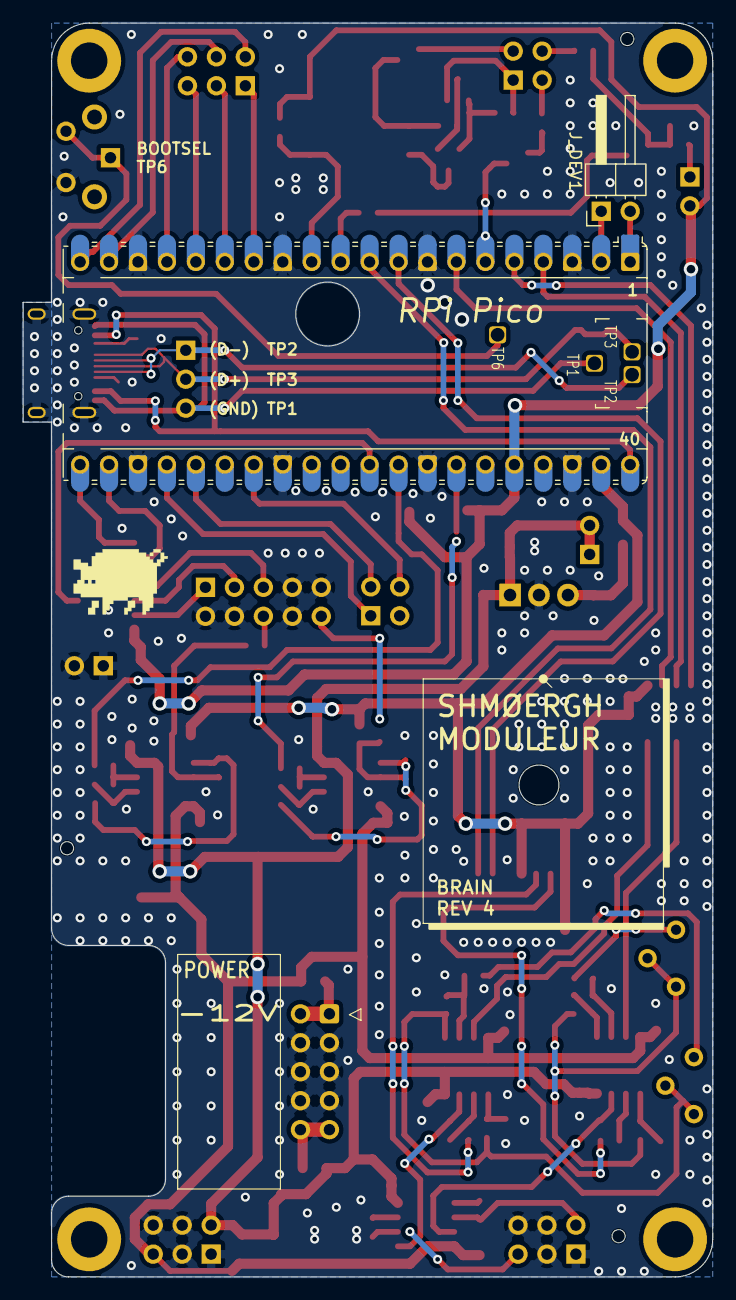
[picture p71: board brain-core.kicad_pcb from below]

Board: 2 copper layers, 60.5 x 110.0 mm, 99 parts (2 on the bottom side), 84 nets.
