DanD222/moduleur/modules/05-adsr-vca/electronics/core/adsr-vca-core.kicad_pcb

## KiCad design modules/05-adsr-vca/electronics/core/adsr-vca-core.kicad_pcb (continued)

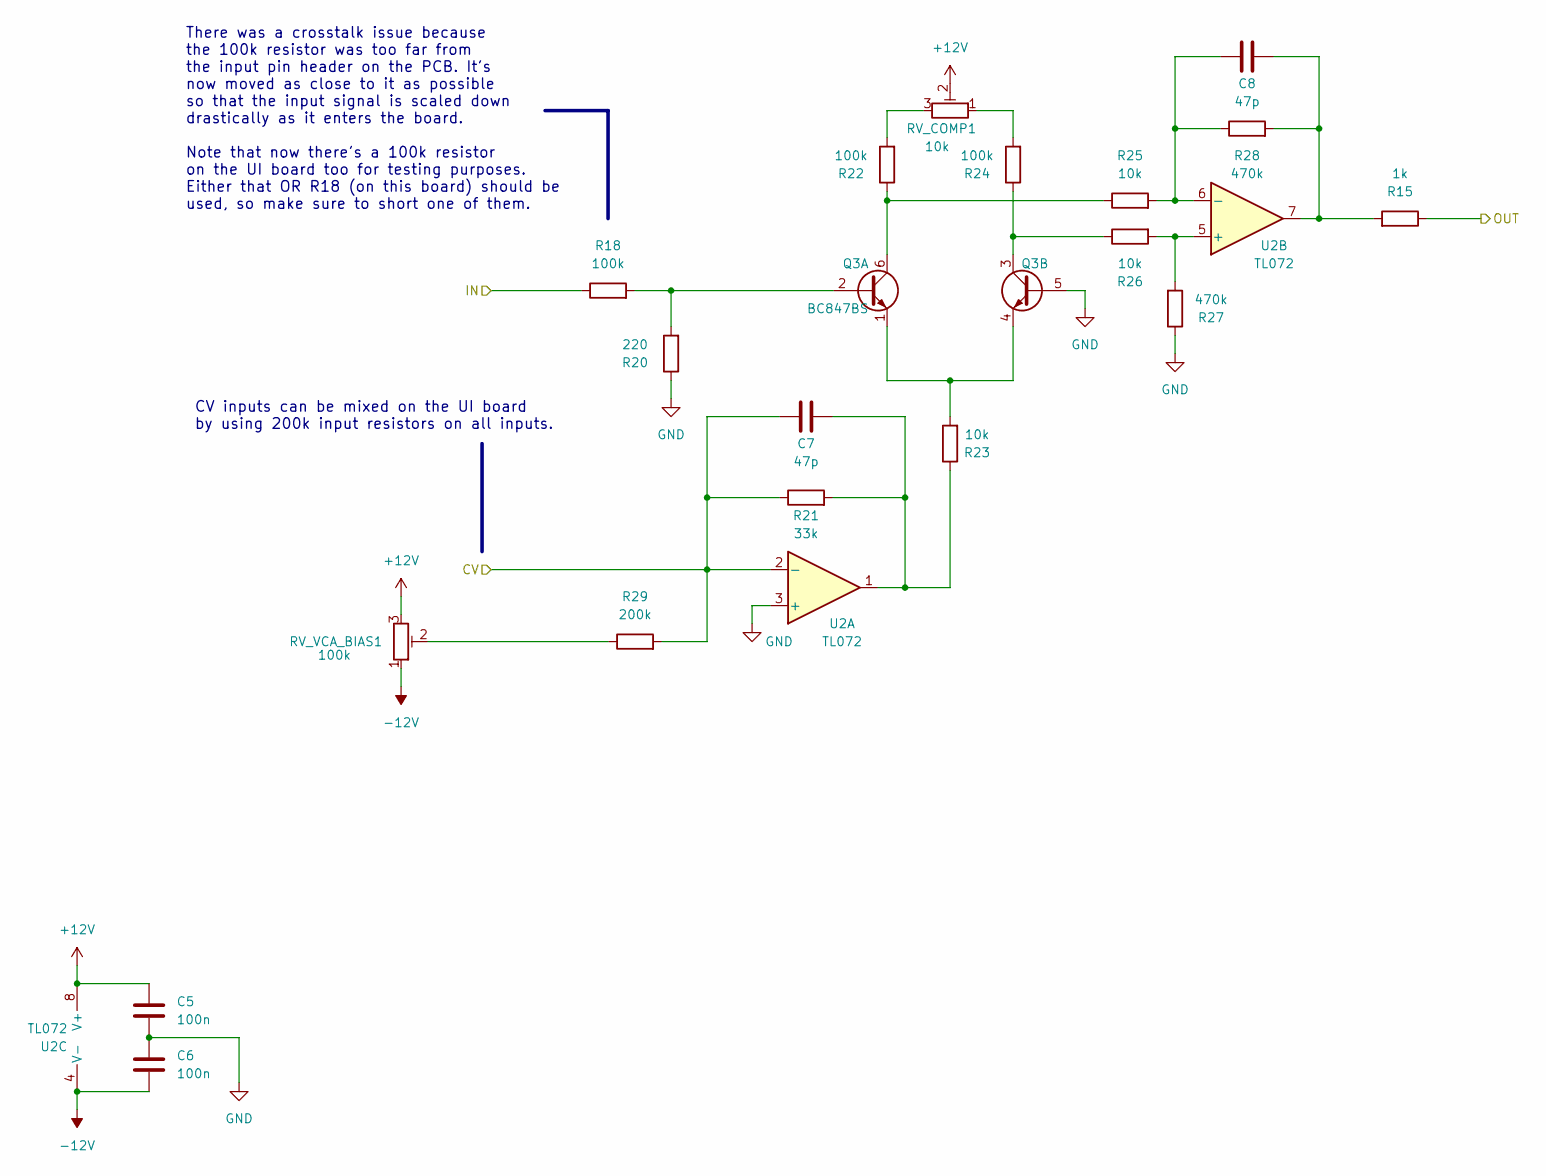
[picture p75: schematic vca.kicad_sch, ADSR + VCA]

Parts:
C5, C6: 100n; C_0603_1608Metric; LCSC C14663
C7, C8: 47p; C_0603_1608Metric_Pad1.08x0.95mm_HandSolder; LCSC C1671
Q3: BC847BS; SOT-363_SC-70-6; LCSC C5380687
R15: 1k; R_0603_1608Metric; LCSC C21190
R18, R22, R24: 100k; R_0603_1608Metric; LCSC C25803
R20: 220; R_0603_1608Metric; LCSC C22962
R21: 33k; R_0603_1608Metric; LCSC C4216
R23, R25, R26: 10k; R_0603_1608Metric; LCSC C25804
R27, R28: 470k; R_0603_1608Metric; LCSC C23178
R29: 200k; R_0603_1608Metric; LCSC C25811
RV_COMP1: 10k; Potentiometer_ACP_CA6-H2,5_Horizontal; Mouser Part no. 774-06TR4AA103CP
RV_VCA_BIAS1: 100k; Potentiometer_ACP_CA6-H2,5_Horizontal; Mouser Part no. 774-06TR4AA104CP
U2: TL072; SOIC-8_3.9x4.9mm_P1.27mm; LCSC C6961

Connections:
+12V: C5.1, RV_COMP1.2, RV_VCA_BIAS1.3, U2.8 (V+); also elsewhere on the board
-12V: C6.2, RV_VCA_BIAS1.1, U2.4 (V-); also elsewhere on the board
GND: C5.2, C6.1, Q3.5 (B2), R20.1, R27.1, U2.3 (+); also elsewhere on the board
unnamed: C7.2, R21.2, R23.1, U2.1
unnamed: C8.2, R15.2, R28.2, U2.7
unnamed: Q3.2 (B1), R18.2, R20.2
unnamed: Q3.6 (C1), R22.1, R25.1
unnamed: Q3.1 (E1), Q3.4 (E2), R23.2
unnamed: Q3.3 (C2), R24.1, R26.1
unnamed: R22.2, RV_COMP1.3
unnamed: R24.2, RV_COMP1.1
unnamed: R29.1, RV_VCA_BIAS1.2
unnamed: R26.2, R27.2, U2.5 (+)
unnamed: C8.1, R25.2, R28.1, U2.6 (-)
VCA_CV: C7.1, R21.1, R29.2, U2.2 (-); also elsewhere on the board
VCA_IN: R18.1; also elsewhere on the board
VCA_OUT: R15.1; also elsewhere on the board

Notes on the sheet:
CV inputs can be mixed on the UI board by using 200k input resistors on all inputs.
There was a crosstalk issue because the 100k resistor was too far from the input pin header on the PCB. It's now moved as close to it as possible so that the input signal is scaled down drastically as it enters the board. Note that now there's a 100k resistor on the UI board too for testing purpose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

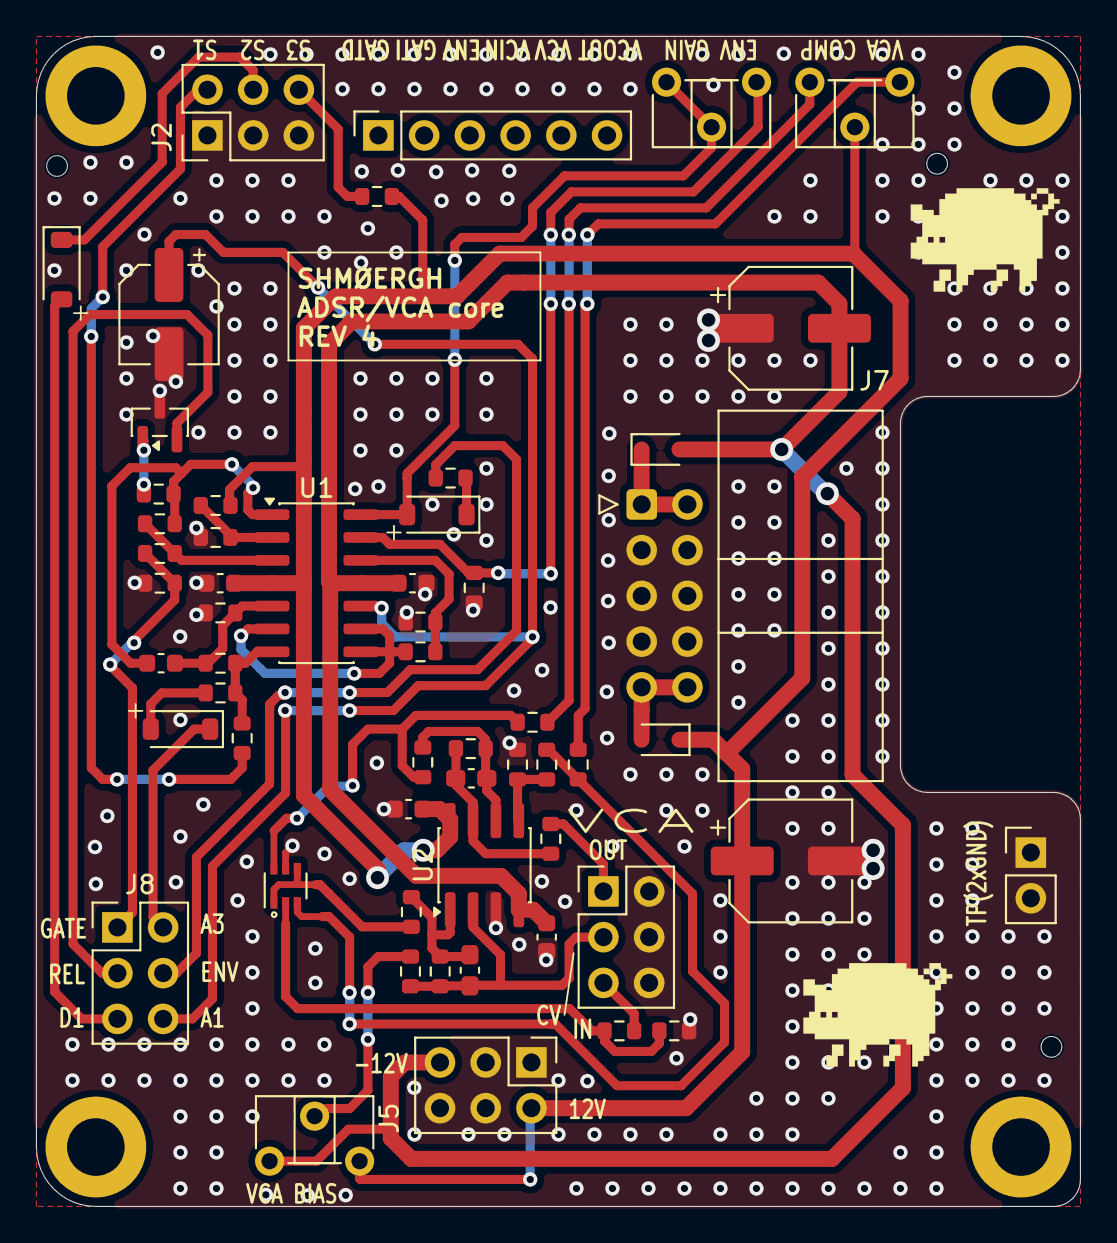
[picture p76: board adsr-vca-core.kicad_pcb from above]

Board: 2 copper layers, 58.0 x 65.0 mm, 60 parts (0 on the bottom side), 40 nets.
