DanD222/moduleur/modules/06-utils-output/electronics/core/utils-output-core.kicad_pcb

## KiCad design modules/06-utils-output/electronics/core/utils-output-core.kicad_pcb (2026-05-23)

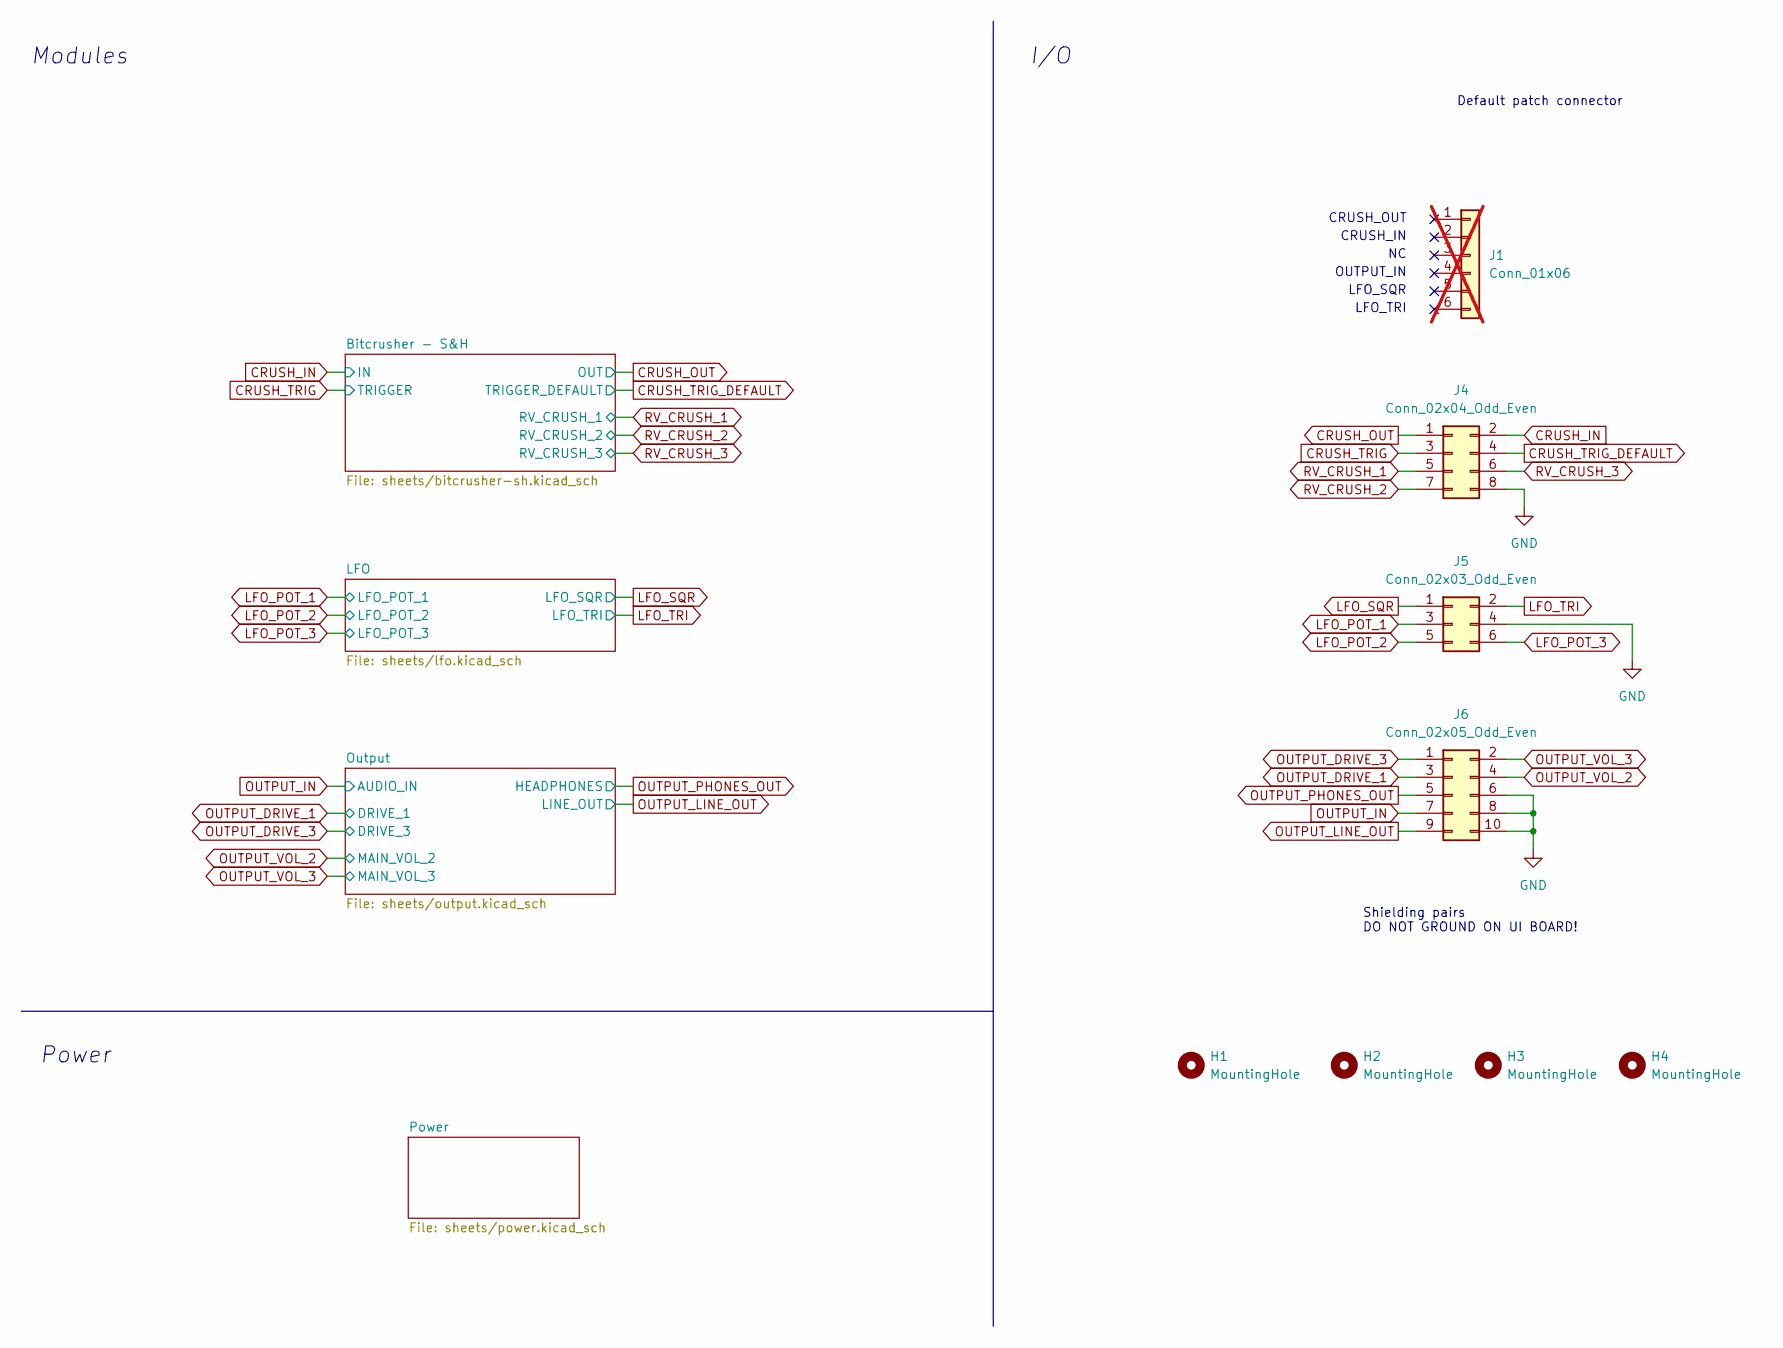
[picture p77: schematic utils-output-core.kicad_sch, Utils / Output Core]

Parts:
H1, H2, H3, H4: MountingHole; MountingHole_3.2mm_M3_DIN965_Pad
J1: Conn_01x06; PinHeader_1x06_P2.54mm_Vertical; Mouser Part no. 200-SSW10601TMS; not fitted
J4: Conn_02x04_Odd_Even; PinHeader_2x04_P2.54mm_Vertical; Mouser Part no. 200-HTSW10407TD
J5: Conn_02x03_Odd_Even; PinHeader_2x03_P2.54mm_Vertical; Mouser Part no. 200-TSW10307TD
J6: Conn_02x05_Odd_Even; PinHeader_2x05_P2.54mm_Vertical; Mouser Part no. 200-TSW10507TD

Connections:
CRUSH_IN: J4.2; also elsewhere on the board
CRUSH_OUT: J4.1; also elsewhere on the board
CRUSH_TRIG: J4.3; also elsewhere on the board
CRUSH_TRIG_DEFAULT: J4.4; also elsewhere on the board
GND: J4.8, J5.4, J6.6, J6.8, J6.10; also elsewhere on the board
LFO_POT_1: J5.3; also elsewhere on the board
LFO_POT_2: J5.5; also elsewhere on the board
LFO_POT_3: J5.6; also elsewhere on the board
LFO_SQR: J5.1; also elsewhere on the board
LFO_TRI: J5.2; also elsewhere on the board
OUTPUT_DRIVE_1: J6.3; also elsewhere on the board
OUTPUT_DRIVE_3: J6.1; also elsewhere on the board
OUTPUT_IN: J6.7; also elsewhere on the board
OUTPUT_LINE_OUT: J6.9; also elsewhere on the board
OUTPUT_PHONES_OUT: J6.5; also elsewhere on the board
OUTPUT_VOL_2: J6.4; also elsewhere on the board
OUTPUT_VOL_3: J6.2; also elsewhere on the board
RV_CRUSH_1: J4.5; also elsewhere on the board
RV_CRUSH_2: J4.7; also elsewhere on the board
RV_CRUSH_3: J4.6; also elsewhere on the board

Notes on the sheet:
Power
LFO_TRI
CRUSH_OUT
Shielding pairs DO NOT GROUND ON UI BOARD!
Default patch connector
LFO_SQR
Modules
CRUSH_IN
I/O
OUTPUT_IN

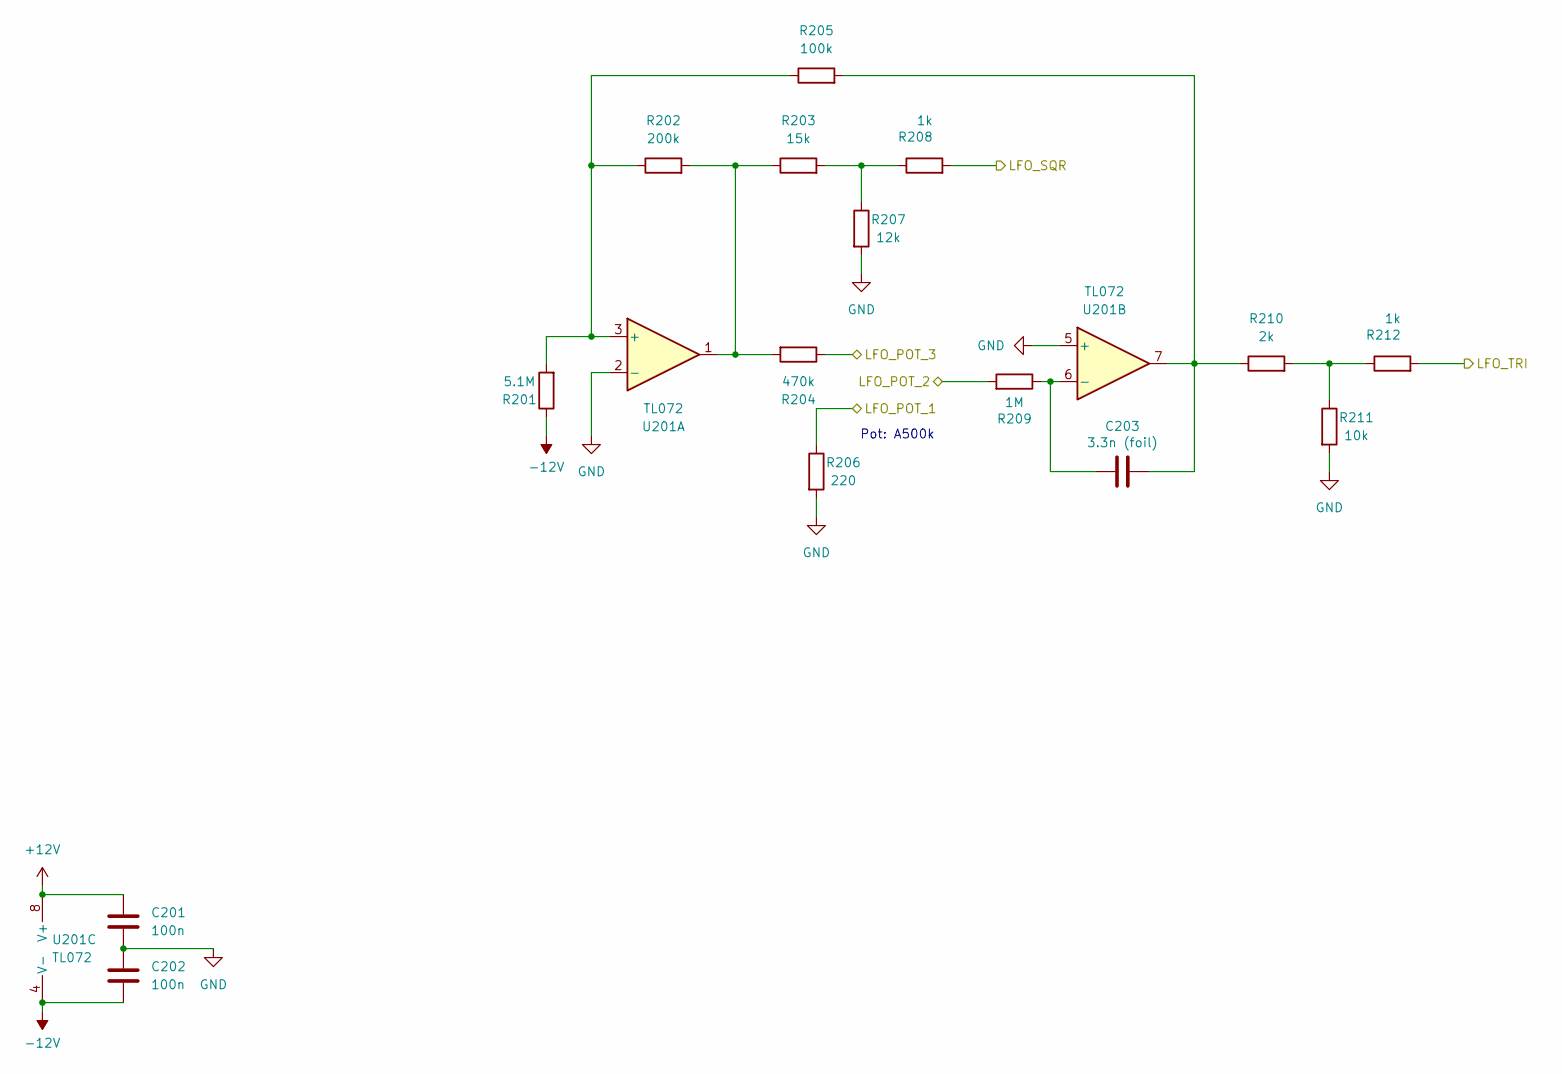
[picture p78: schematic lfo.kicad_sch, Utils / Output Core]

Parts:
C201, C202: 100n; C_0603_1608Metric; LCSC C14663
C203: 3.3n (foil); C_Rect_L7.0mm_W2.5mm_P5.00mm; Part No. 80-R82EC1330AA50K; Mouser Part no. 80-R82EC1330AA50K
R201: 5.1M; R_0603_1608Metric; LCSC C13320
R202: 200k; R_0603_1608Metric; LCSC C25811
R203: 15k; R_0603_1608Metric; LCSC C22809
R204: 470k; R_0603_1608Metric; LCSC C23178
R205: 100k; R_0603_1608Metric; LCSC C25803
R206: 220; R_Axial_DIN0207_L6.3mm_D2.5mm_P7.62mm_Horizontal; Mouser Part no. 603-MFR-25FTF52-220R
R207: 12k; R_0603_1608Metric; LCSC C22790
R208, R212: 1k; R_0603_1608Metric; LCSC C21190
R209: 1M; R_0603_1608Metric; LCSC C22935
R210: 2k; R_0603_1608Metric; LCSC C22975
R211: 10k; R_0603_1608Metric; LCSC C25804
U201: TL072; SOIC-8_3.9x4.9mm_P1.27mm; LCSC C6961

Connections:
GND: C201.2, C202.1, R206.2, R207.2, R211.2, U201.2 (-), U201.5 (+); also elsewhere on the board
LFO_POT_1: R206.1; also elsewhere on the board
LFO_POT_2: R209.2; also elsewhere on the board
LFO_POT_3: R204.1; also elsewhere on the board
LFO_SQR: R208.2; also elsewhere on the board
LFO_TRI: R212.2; also elsewhere on the board
unnamed: C203.1, R205.2, R210.1, U201.7
unnamed: R202.2, R203.1, R204.2, U201.1
unnamed: R203.2, R207.1, R208.1
unnamed: R210.2, R211.1, R212.1
unnamed: R201.2, R202.1, R205.1, U201.3 (+)
unnamed: C203.2, R209.1, U201.6 (-)

Notes on the sheet:
Pot: A500k

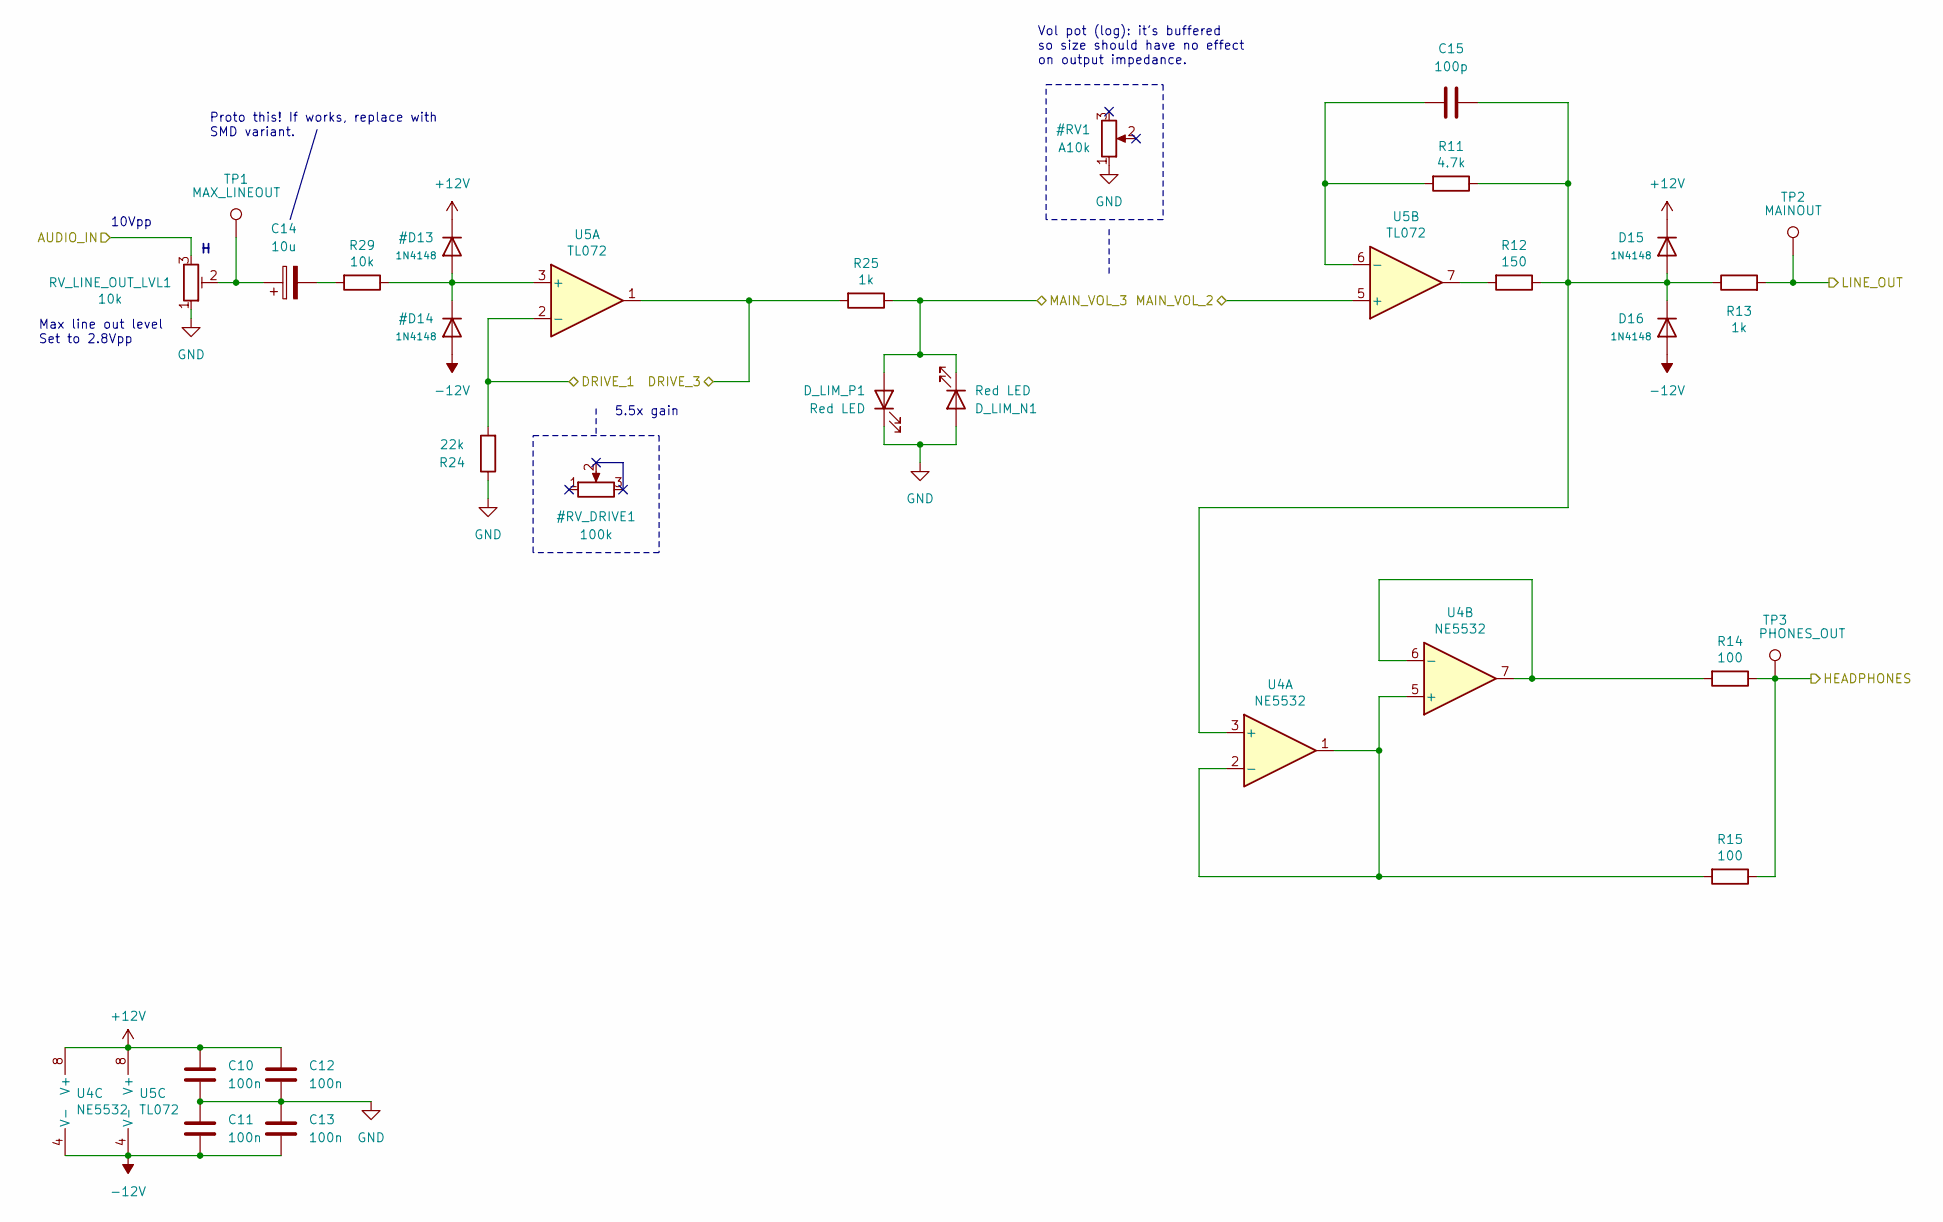
[picture p79: schematic output.kicad_sch, Utils / Output Core]

Parts:
C10, C11, C12, C13: 100n; C_0603_1608Metric; LCSC C14663
C14: 10u; CP_Elec_5x5.4; LCSC C4747971
C15: 100p; C_0603_1608Metric; LCSC C14858
D15, D16: 1N4148; D_SOD-123; LCSC C81598
D_LIM_N1: Red LED; LED_D3.0mm
D_LIM_P1: Red LED; PinHeader_1x02_P2.54mm_Vertical
R11: 4.7k; R_0603_1608Metric; LCSC C23162
R12: 150; R_0603_1608Metric; LCSC C22808
R13, R25: 1k; R_0603_1608Metric; LCSC C21190
R14, R15: 100; R_0603_1608Metric; LCSC C22775
R24: 22k; R_0603_1608Metric; LCSC C31850
R29: 10k; R_0603_1608Metric; LCSC C25804
RV_LINE_OUT_LVL1: 10k; Potentiometer_ACP_CA6-H2,5_Horizontal; Part No. 531-PT6KH-10K; Mouser Part no. 774-06TR4AA103CP
TP1: MAX_LINEOUT; TestPoint_THTPad_D1.5mm_Drill0.7mm
TP2: MAINOUT; TestPoint_THTPad_2.0x2.0mm_Drill1.0mm
TP3: PHONES_OUT; TestPoint_THTPad_2.0x2.0mm_Drill1.0mm
U4: NE5532; SOIC-8_3.9x4.9mm_P1.27mm; LCSC C7426
U5: TL072; SOIC-8_3.9x4.9mm_P1.27mm; LCSC C6961

Connections:
GND: C10.2, C11.1, C12.2, C13.1, D_LIM_N1.2 (A), D_LIM_P1.1 (K), R24.1, RV_LINE_OUT_LVL1.1; also elsewhere on the board
unnamed: C14.1, RV_LINE_OUT_LVL1.2, TP1.1 (1_1)
unnamed: C14.2, R29.2
unnamed: C15.2, D15.2 (A), D16.1 (K), R11.1, R12.1, R13.1, U4.3 (+)
unnamed: R12.2, U5.7
unnamed: R15.2, U4.1, U4.2 (-), U4.5 (+)
unnamed: R14.2, U4.6 (-), U4.7
unnamed: C15.1, R11.2, U5.6 (-)
OUTPUT_DRIVE_1: R24.2, U5.2 (-); also elsewhere on the board
OUTPUT_DRIVE_3: R25.2, U5.1; also elsewhere on the board
OUTPUT_IN: RV_LINE_OUT_LVL1.3; also elsewhere on the board
OUTPUT_LINE_OUT: R13.2, TP2.1 (1_1); also elsewhere on the board
OUTPUT_PHONES_OUT: R14.1, R15.1, TP3.1 (1_1); also elsewhere on the board
OUTPUT_VOL_2: U5.5 (+); also elsewhere on the board
OUTPUT_VOL_3: D_LIM_N1.1 (K), D_LIM_P1.2 (A), R25.1; also elsewhere on the board

Notes on the sheet:
Vol pot (log): it's buffered so size should have no effect on output impedance.
5.5x gain
Proto this! If works, replace with SMD variant.
Max line out level Set to 2.8Vpp
10Vpp

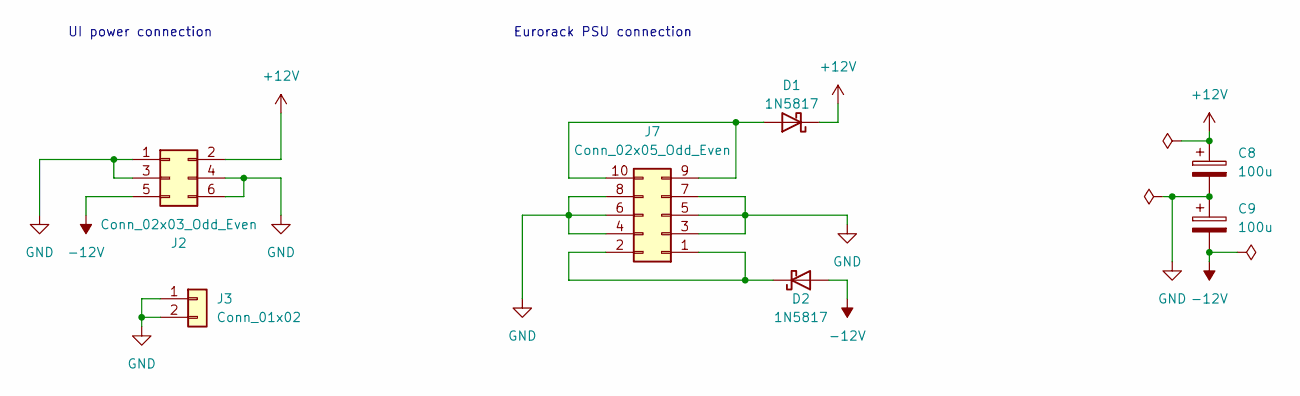
[picture p80: schematic power.kicad_sch, Utils / Output Core]

Parts:
C8, C9: 100u; CP_Elec_6.3x7.7; LCSC C2836442
D1, D2: 1N5817; D_SOD-323; LCSC C5190152
J2: Conn_02x03_Odd_Even; PinHeader_2x03_P2.54mm_Vertical; Mouser Part no. 200-TSW10307TD
J3: Conn_01x02; PinHeader_1x02_P2.54mm_Vertical; Mouser Part no. 200-HTSW10207TS
J7: Conn_02x05_Odd_Even; IDC-Header_2x05_P2.54mm_Horizontal; Mouser Part no. 571-5103310-1

Connections:
GND: C8.2, C9.1, J2.1, J2.3, J2.4, J2.6, J3.1, J3.2, J7.3, J7.4, J7.5, J7.6, J7.7, J7.8; also elsewhere on the board
unnamed: D1.2 (A), J7.9, J7.10
unnamed: D2.1 (K), J7.1, J7.2

Notes on the sheet:
UI power connection
Eurorack PSU connection

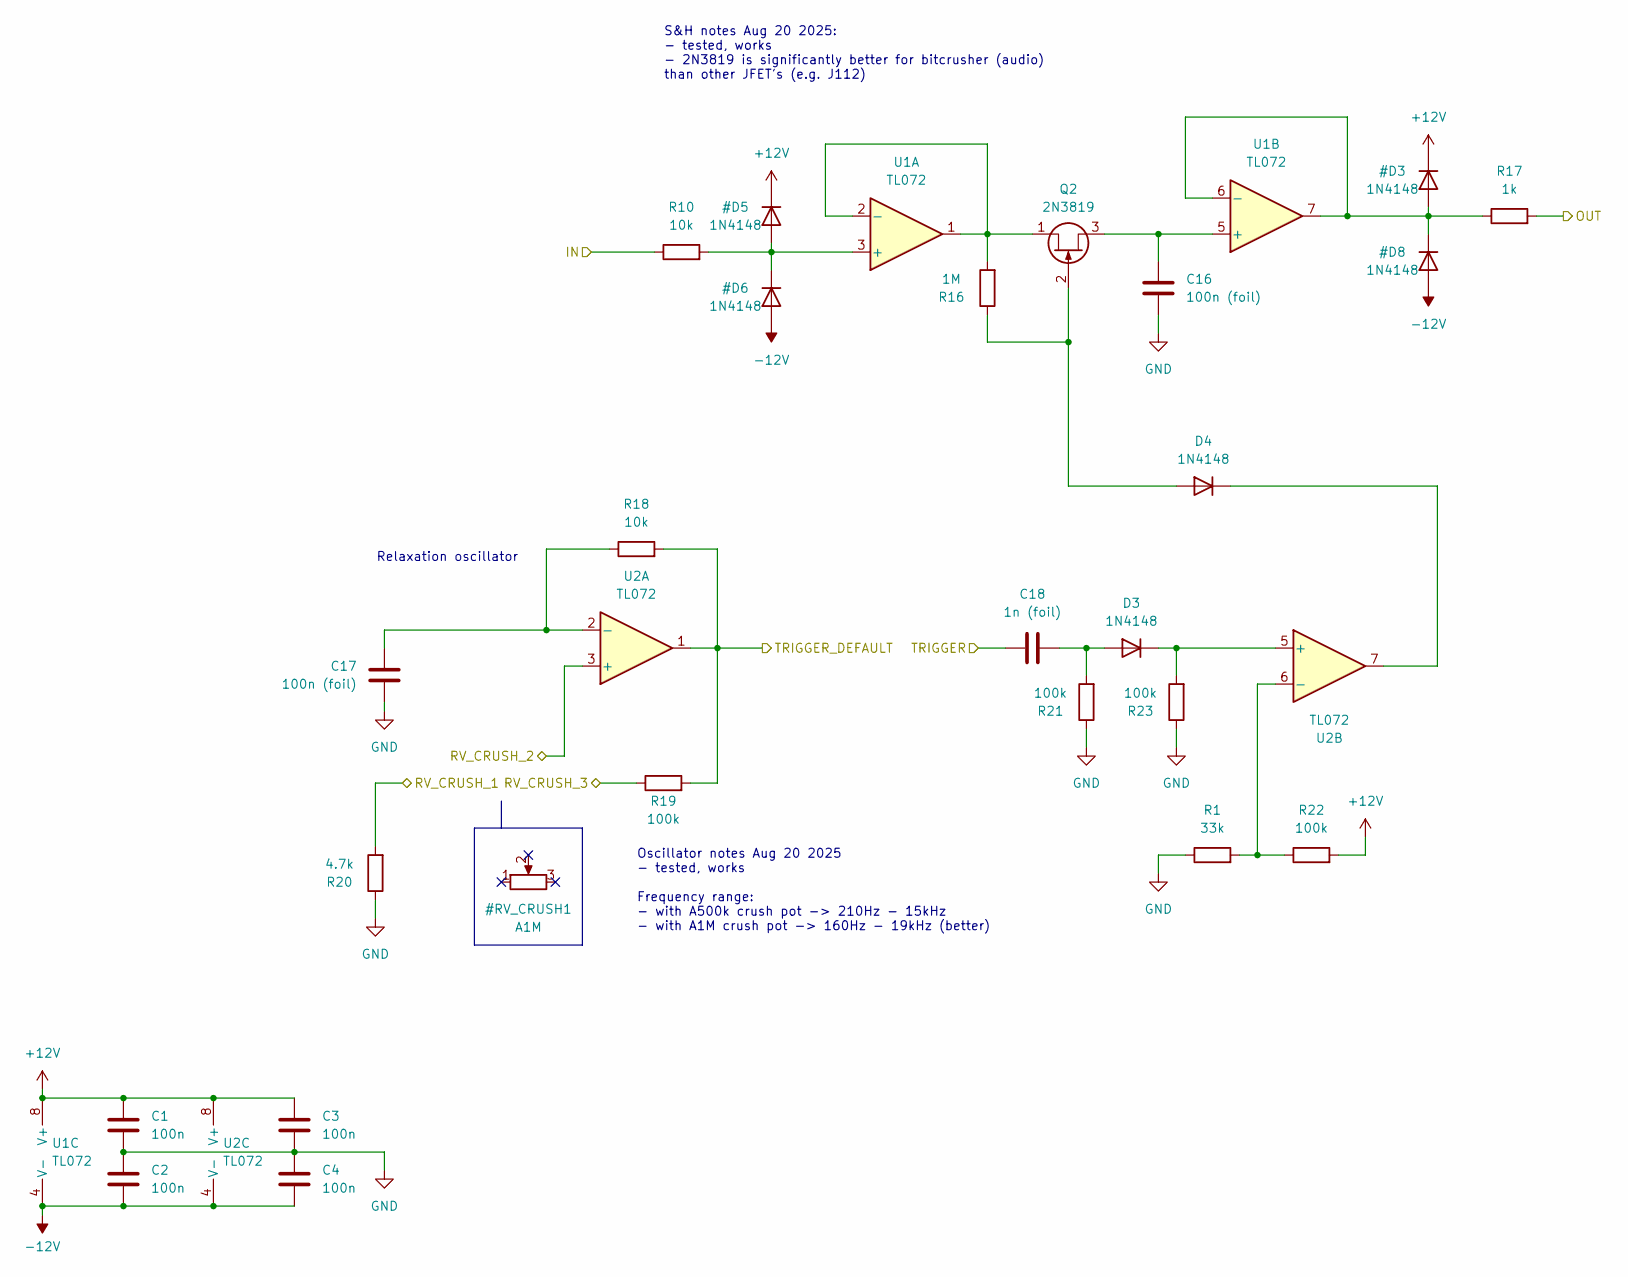
[picture p81: schematic bitcrusher-sh.kicad_sch, Utils / Output Core]

Parts:
C1, C2, C3, C4: 100n; C_0603_1608Metric; LCSC C14663
C16, C17: 100n (foil); C_Rect_L7.2mm_W2.5mm_P5.00mm_FKS2_FKP2_MKS2_MKP2; Mouser Part no. 80-MMK5104J50J01L16
C18: 1n (foil); C_Rect_L7.2mm_W2.5mm_P5.00mm_FKS2_FKP2_MKS2_MKP2; Mouser Part no. 80-MMK5102M50J01L4
D3, D4: 1N4148; D_SOD-123; LCSC C81598
Q2: 2N3819; TO-92_Inline_Wide; Mouser Part no. 610-2N3819
R1: 33k; R_0603_1608Metric; LCSC C4216
R10, R18: 10k; R_0603_1608Metric; LCSC C25804
R16: 1M; R_0603_1608Metric; LCSC C22935
R17: 1k; R_0603_1608Metric; LCSC C21190
R19, R21, R22, R23: 100k; R_0603_1608Metric; LCSC C25803
R20: 4.7k; R_0603_1608Metric; LCSC C23162
U1, U2: TL072; SOIC-8_3.9x4.9mm_P1.27mm; LCSC C6961

Connections:
CRUSH_IN: R10.1; also elsewhere on the board
CRUSH_OUT: R17.2; also elsewhere on the board
CRUSH_TRIG: C18.1; also elsewhere on the board
CRUSH_TRIG_DEFAULT: R18.2, R19.2, U2.1; also elsewhere on the board
GND: C1.2, C2.1, C3.2, C4.1, C16.2, C17.2, R1.1, R20.1, R21.1, R23.1; also elsewhere on the board
unnamed: C18.2, D3.2 (A), R21.2
unnamed: D3.1 (K), R23.2, U2.5 (+)
unnamed: D4.2 (A), Q2.2 (G), R16.1
unnamed: D4.1 (K), U2.7
unnamed: Q2.1 (D), R16.2, U1.1, U1.2 (-)
unnamed: C16.1, Q2.3 (S), U1.5 (+)
unnamed: C17.1, R18.1, U2.2 (-)
unnamed: R1.2, R22.1, U2.6 (-)
RV_CRUSH_1: R20.2; also elsewhere on the board
RV_CRUSH_2: U2.3 (+); also elsewhere on the board
RV_CRUSH_3: R19.1; also elsewhere on the board

Notes on the sheet:
Relaxation oscillator
S&H notes Aug 20 2025: - tested, works - 2N3819 is significantly better for bitcrusher (audio) than other JFET's (e.g. J112)
Oscillator notes Aug 20 2025 - tested, works Frequency range: - with A500k crush pot -> 210Hz - 15kHz - with A1M crush pot -> 160Hz - 19kHz (better)

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
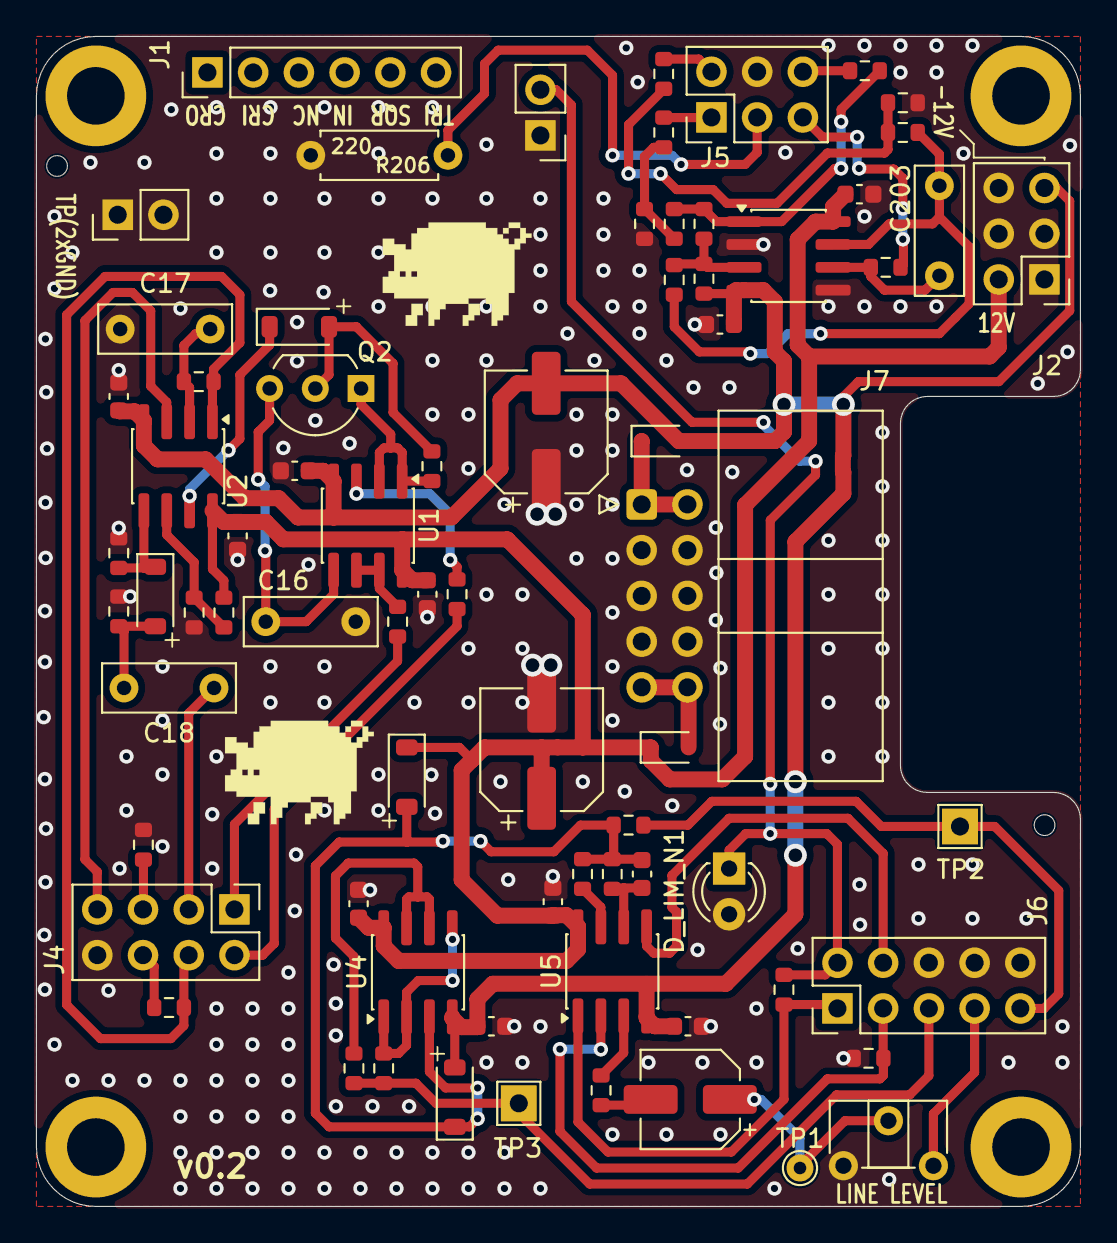
[picture p82: board utils-output-core.kicad_pcb from above]

Board: 2 copper layers, 58.0 x 65.0 mm, 77 parts (0 on the bottom side), 48 nets.
