DanD222/moduleur/modules/01-psu/supplementary/eurorack-psu/psu.kicad_pcb

## KiCad design modules/01-psu/supplementary/eurorack-psu/psu.kicad_pcb (2026-05-23)

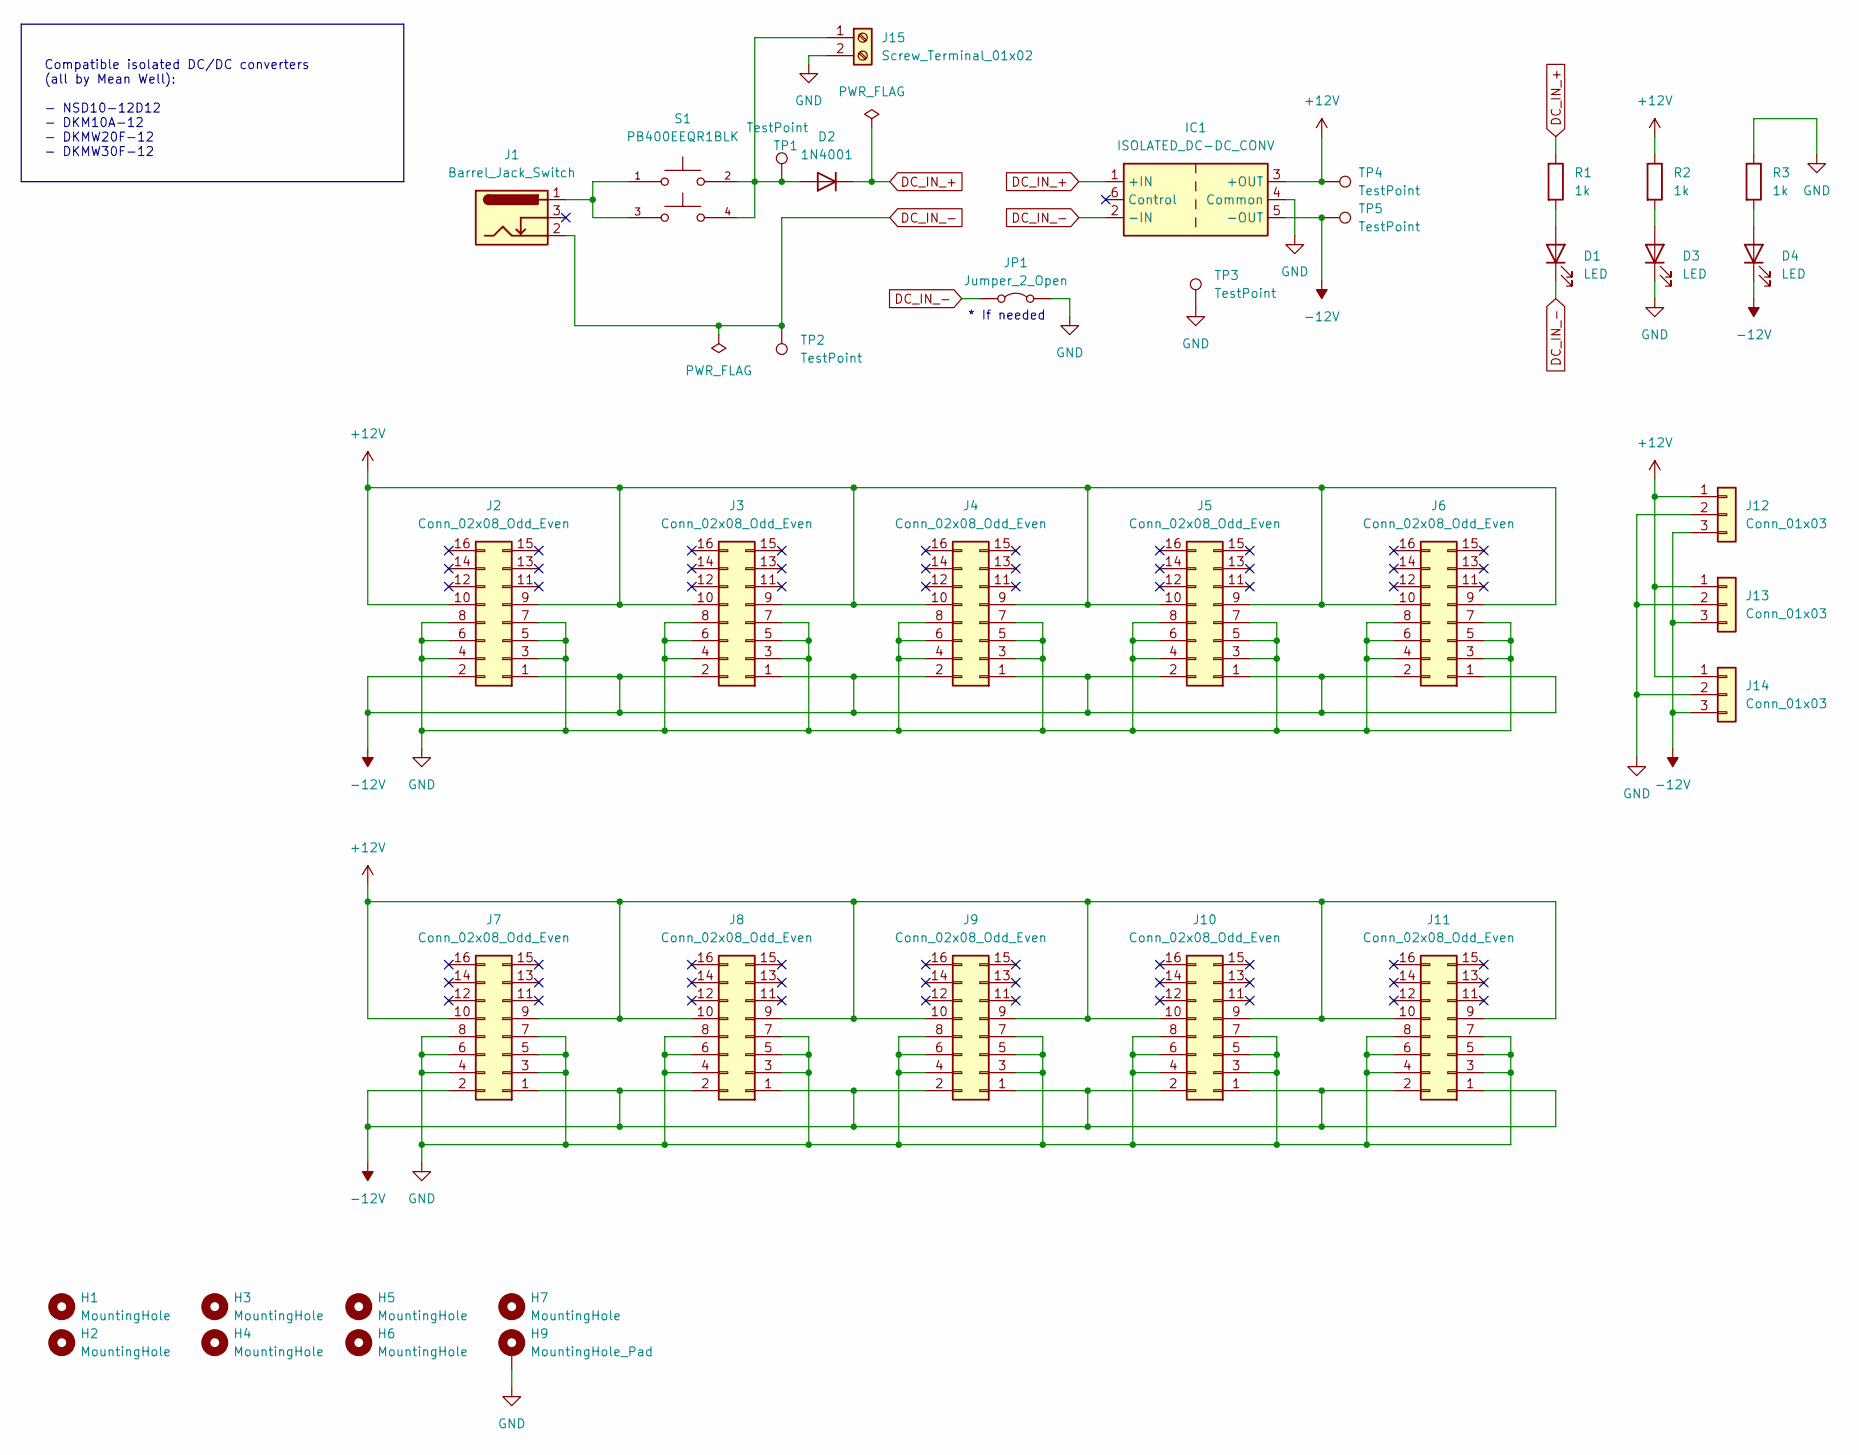
[picture p99: schematic psu.kicad_sch, Hog Moduleur PSU]

Parts:
D1, D3, D4: LED; LED_D3.0mm; Part No. 604-WP710A10ID
D2: 1N4001; D_DO-41_SOD81_P7.62mm_Horizontal; Part No. 637-1N4001
H1, H2, H3, H4, H5, H6, H7: MountingHole; MountingHole_3.2mm_M3_DIN965; Part No. N/A
H9: MountingHole_Pad; MountingHole_3.2mm_M3_DIN965_Pad
IC1: ISOLATED_DC-DC_CONV; Converter_DCDC_MeanWell_NSD10_DKMW_THT; Manufacturer_Part_Number NSD10-12D12; Mouser Part Number 709-NSD10-12D5
J1: Barrel_Jack_Switch; BarrelJack_Wuerth_6941xx301002; Part No. 710-694106301002
J2, J3, J4, J5, J6, J7, J8, J9, J10, J11: Conn_02x08_Odd_Even; IDC-Header_2x08_P2.54mm_Vertical; Part No. 737-BHR-16-VUA
J12, J13, J14: Conn_01x03; PinHeader_1x03_P2.54mm_Vertical
J15: Screw_Terminal_01x02; Altech_AK100_1x02_P5.00mm; Part No. 737-EBBA-02-C-SS-BU
JP1: Jumper_2_Open; SolderJumper-2_P1.3mm_Bridged2Bar_RoundedPad1.0x1.5mm; Part No. N/A
R1, R2, R3: 1k; R_Axial_DIN0207_L6.3mm_D2.5mm_P7.62mm_Horizontal; Part No. 303-MF0W4FF1001A10
S1: PB400EEQR1BLK; SW_PB400EEQR1BLK; PARTREV A
TP1, TP2, TP3, TP4, TP5: TestPoint; TestPoint_THTPad_2.0x2.0mm_Drill1.0mm; Part No. N/A

Connections:
+12V: IC1.3 (+OUT), J2.9, J2.10, J3.9, J3.10, J4.9, J4.10, J5.9, J5.10, J6.9, J6.10, J7.9, J7.10, J8.9, J8.10, J9.9, J9.10, J10.9, J10.10, J11.9, J11.10, J12.1, J13.1, J14.1, R2.1, TP4.1
-12V: D4.1 (K), IC1.5 (-OUT), J2.1, J2.2, J3.1, J3.2, J4.1, J4.2, J5.1, J5.2, J6.1, J6.2, J7.1, J7.2, J8.1, J8.2, J9.1, J9.2, J10.1, J10.2, J11.1, J11.2, J12.3, J13.3, J14.3, TP5.1
DC_IN_+: D2.1 (K), IC1.1 (+IN), R1.1
DC_IN_-: D1.1 (K), IC1.2 (-IN), J1.2, JP1.1 (A), TP2.1
GND: D3.1 (K), H9.1, IC1.4 (Common), J2.3, J2.4, J2.5, J2.6, J2.7, J2.8, J3.3, J3.4, J3.5, J3.6, J3.7, J3.8, J4.3, J4.4, J4.5, J4.6, J4.7, J4.8, J5.3, J5.4, J5.5, J5.6, J5.7, J5.8, J6.3, J6.4, J6.5, J6.6, J6.7, J6.8, J7.3, J7.4, J7.5, J7.6, J7.7, J7.8, J8.3, J8.4, J8.5, J8.6, J8.7, J8.8, J9.3, J9.4, J9.5, J9.6, J9.7, J9.8, J10.3, J10.4, J10.5, J10.6, J10.7, J10.8, J11.3, J11.4, J11.5, J11.6, J11.7, J11.8, J12.2, J13.2, J14.2, J15.2, JP1.2 (B), R3.1, TP3.1
unnamed: D1.2 (A), R1.2
unnamed: D2.2 (A), J15.1, S1.2, S1.4, TP1.1
unnamed: D3.2 (A), R2.2
unnamed: D4.2 (A), R3.2
unnamed: J1.1, S1.1, S1.3

Notes on the sheet:
Compatible isolated DC/DC converters (all by Mean Well): - NSD10-12D12 - DKM10A-12 - DKMW20F-12 - DKMW30F-12
* If needed

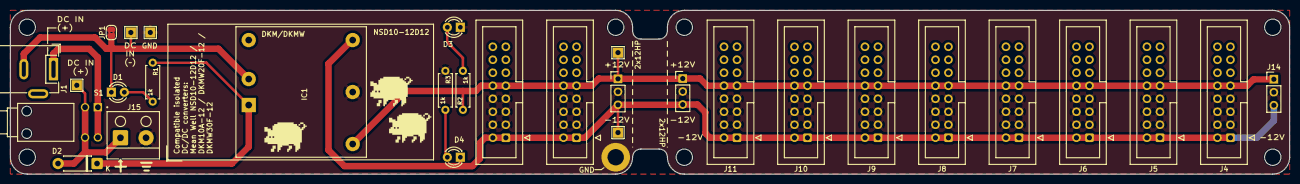
[picture p100: board modules/01-psu/supplementary/eurorack-psu/psu.kicad_pcb from above]

Board: 2 copper layers, 250.0 x 32.0 mm, 38 parts (0 on the bottom side), 10 nets.
