DanD222/moduleur/modules/06-utils-output/electronics/ui/utils-output-ui-4-layer.kicad_pcb

## KiCad design modules/06-utils-output/electronics/ui/utils-output-ui-4-layer.kicad_pcb (2026-05-23)

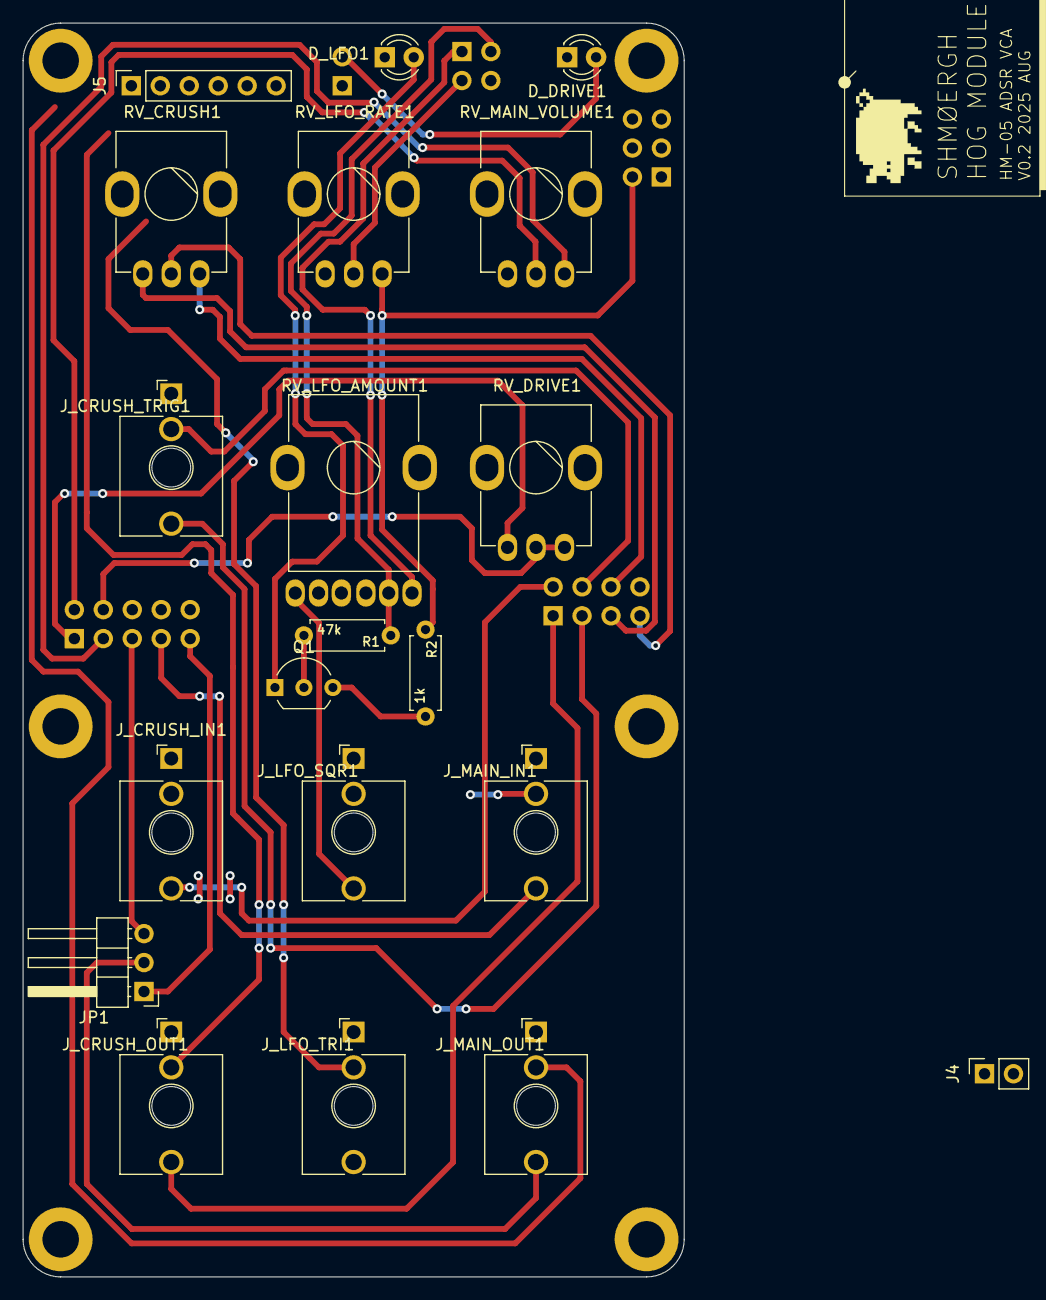
[picture p101: board utils-output-ui-4-layer.kicad_pcb from above]

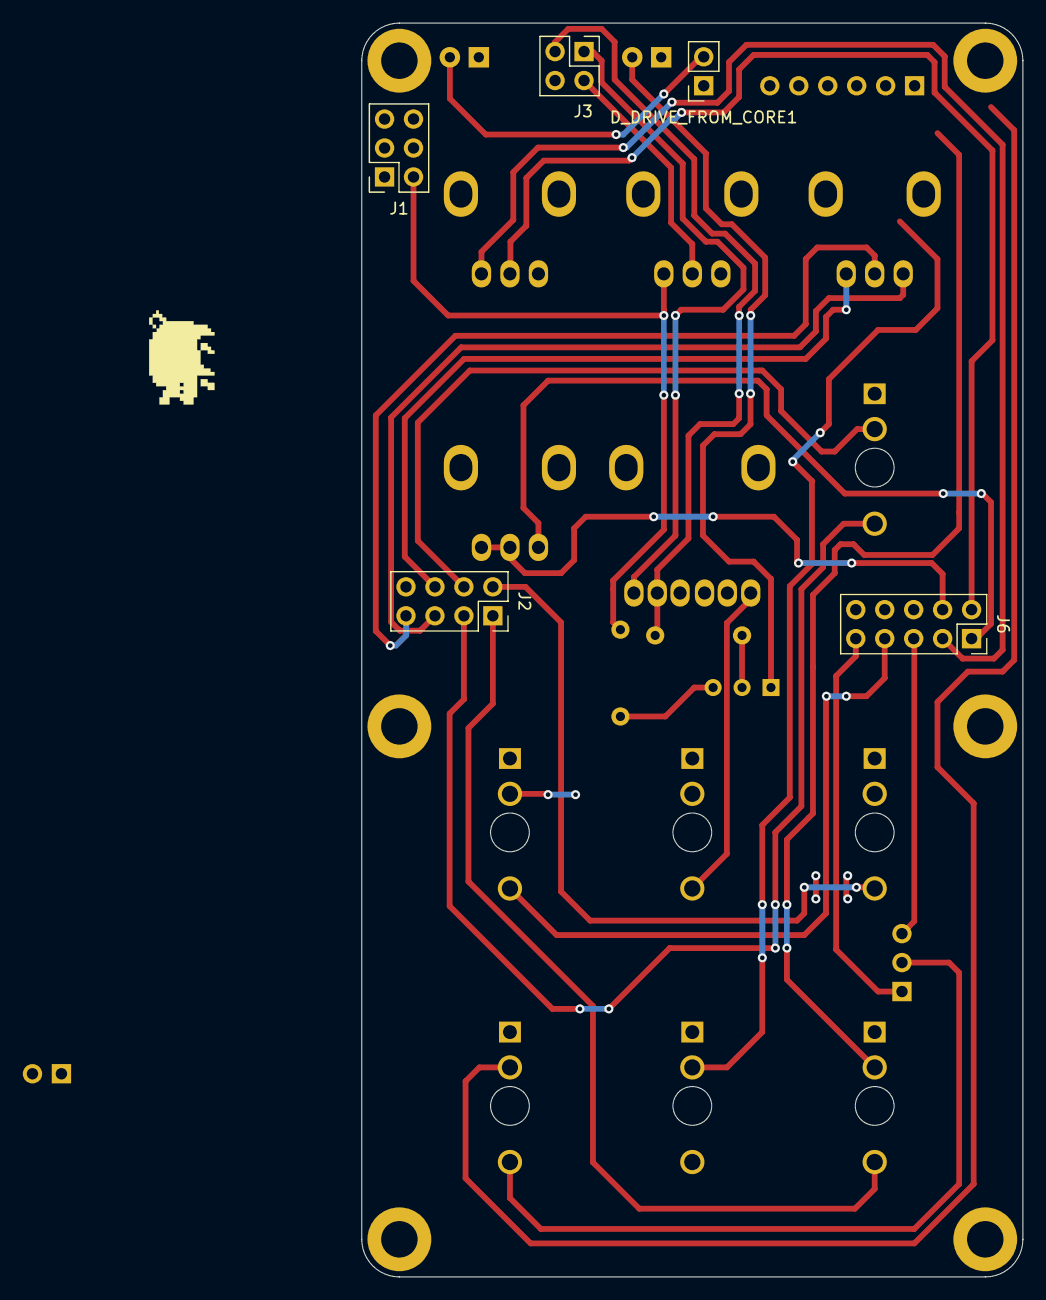
[picture p102: board utils-output-ui-4-layer.kicad_pcb from below]

Board: 4 copper layers, 58.0 x 110.0 mm, 31 parts (5 on the bottom side), 32 nets.

Parts:
D_DRIVE1: Red LED; LED_D3.0mm
D_DRIVE_FROM_CORE1: Red LED; PinSocket_1x02_P2.54mm_Vertical
D_LFO1: Red LED; LED_D3.0mm
H1, H2, H3, H4, H5, H6: MountingHole; MountingHole_3.2mm_M3_DIN965_Pad
J1: Conn_02x03_Odd_Even; PinSocket_2x03_P2.54mm_Vertical
J2: Conn_02x04_Odd_Even; PinSocket_2x04_P2.54mm_Vertical
J3: Conn_02x02_Odd_Even; PinSocket_2x02_P2.54mm_Vertical
J4: Conn_01x02; PinSocket_1x02_P2.54mm_Vertical
J5: Conn_01x06; PinSocket_1x06_P2.54mm_Vertical
J6: Conn_02x05_Odd_Even; PinSocket_2x05_P2.54mm_Vertical
JP1: Jumper_3_Open; PinHeader_1x03_P2.54mm_Horizontal
J_CRUSH_IN1: PJ398SM; Jack_3.5mm_QingPu_WQP-PJ398SM_Vertical_CircularHoles
J_CRUSH_OUT1: PJ398SM; Jack_3.5mm_QingPu_WQP-PJ398SM_Vertical_CircularHoles
J_CRUSH_TRIG1: PJ398SM; Jack_3.5mm_QingPu_WQP-PJ398SM_Vertical_CircularHoles
J_LFO_SQR1: PJ398SM; Jack_3.5mm_QingPu_WQP-PJ398SM_Vertical_CircularHoles
J_LFO_TRI1: PJ398SM; Jack_3.5mm_QingPu_WQP-PJ398SM_Vertical_CircularHoles
J_MAIN_IN1: PJ398SM; Jack_3.5mm_QingPu_WQP-PJ398SM_Vertical_CircularHoles
J_MAIN_OUT1: PJ398SM; Jack_3.5mm_QingPu_WQP-PJ398SM_Vertical_CircularHoles
Q1: 2N3904; TO-92_Inline_Wide
R1: 47k; R_Axial_DIN0207_L6.3mm_D2.5mm_P7.62mm_Horizontal
R2: 1k; R_Axial_DIN0207_L6.3mm_D2.5mm_P7.62mm_Horizontal
RV_CRUSH1: 1M; Potentiometer_Bourns_Single-PTV09A
RV_DRIVE1: 100k; Potentiometer_Bourns_Single-PTV09A
RV_LFO_AMOUNT1: A20k; Potentiometer_Bourns_Dual-PTV112-4
RV_LFO_RATE1: A100k; Potentiometer_Bourns_Single-PTV09A
RV_MAIN_VOLUME1: A10k; Potentiometer_Bourns_Single-PTV09A

Connections:
+12V: J1.2, R2.1, RV_LFO_RATE1.3
CRUSH_IN: J2.2, J_CRUSH_IN1.T
CRUSH_IN_DEFAULT: J5.1, J_CRUSH_IN1.TN
CRUSH_OUT: J2.1, J_CRUSH_OUT1.T
CRUSH_OUT_DEFAULT: J5.2, J_CRUSH_OUT1.TN
CRUSH_TRIG: J2.3, J_CRUSH_TRIG1.T
CRUSH_TRIG_DEFAULT: J2.4, J_CRUSH_TRIG1.TN
DRIVE_LED_P: D_DRIVE1.2 (A), D_DRIVE_FROM_CORE1.2 (A)
GND: D_DRIVE1.1 (K), D_LFO1.1 (K), J1.1, J1.3, J1.4, J1.6, J4.1, J4.2, J_CRUSH_IN1.S, J_CRUSH_OUT1.S, J_CRUSH_TRIG1.S, J_LFO_SQR1.S, J_LFO_TRI1.S, J_MAIN_IN1.S, J_MAIN_OUT1.S, RV_LFO_AMOUNT1.1, RV_LFO_AMOUNT1.4, RV_LFO_RATE1.1, RV_MAIN_VOLUME1.1
LFO_RATE: J3.3, RV_LFO_RATE1.2
LFO_SQR: J3.1, RV_LFO_AMOUNT1.3
LFO_SQR_DEFAULT: J5.4, J_LFO_SQR1.TN
LFO_TRI: J3.2, R1.1, RV_LFO_AMOUNT1.6
LFO_TRI_DEFAULT: J5.3, J_LFO_TRI1.TN
unnamed: D_LFO1.2 (A), Q1.1 (E)
unnamed: J_LFO_SQR1.T, RV_LFO_AMOUNT1.2
unnamed: J_LFO_TRI1.T, RV_LFO_AMOUNT1.5
unnamed: Q1.2 (B), R1.2
unnamed: Q1.3 (C), R2.2
OUTPUT_DRIVE_1: J6.1, RV_DRIVE1.1
OUTPUT_DRIVE_3: J6.4, RV_DRIVE1.2, RV_DRIVE1.3
OUTPUT_IN: J6.7, J_MAIN_IN1.T
OUTPUT_IN_DEFAULT: J5.5, J_MAIN_IN1.TN
OUTPUT_LINE_OUT: J6.9, JP1.1 (A)
OUTPUT_OUT: JP1.2 (C), J_MAIN_OUT1.T
OUTPUT_OUT_DEFAULT: J5.6, J_MAIN_OUT1.TN
OUTPUT_PHONES_OUT: J6.5, JP1.3 (B)
OUTPUT_VOL_2: J6.2, RV_MAIN_VOLUME1.2
OUTPUT_VOL_3: J6.3, RV_MAIN_VOLUME1.3
RV_CRUSH_1: J2.5, RV_CRUSH1.1
RV_CRUSH_2: J2.7, RV_CRUSH1.2
RV_CRUSH_3: J2.6, RV_CRUSH1.3
