DanD222/moduleur/(commit log)

2026-05-23 Reverted KiCad 10 update because of faulty VCO Core
    [adsr-lm324.kicad_sch, adsr-vca-core-full-bom.csv, adsr-vca-core.kicad_pcb, adsr-vca-core.kicad_sch, adsr-vca-ui-full-bom.csv, adsr-vca-ui.kicad_pcb, adsr-vca-ui.kicad_sch, attenuator-multiple.kicad_pcb]
2026-05-23 Updated experimental VCO Core
    [raw-oscillator.kicad_sch, vco-core.kicad_pcb]
2026-05-23 Revert "Updated experimental VCO Core"
    This reverts commit 34f3e113d18d89390407e9554ee904153359fd81.
    [raw-oscillator.kicad_sch, vco-core.kicad_pcb]
2026-05-23 Revert "Reverted KiCad 10 update because of faulty VCO Core"
    This reverts commit 2181cec2415da0927836b64670f1fdf3fa70bf64.
    [adsr-lm324.kicad_sch, adsr-vca-core-full-bom.csv, adsr-vca-core.kicad_pcb, adsr-vca-core.kicad_sch, adsr-vca-ui-full-bom.csv, adsr-vca-ui.kicad_pcb, adsr-vca-ui.kicad_sch, attenuator-multiple.kicad_pcb]
2026-05-23 Reverted VCO Core back to latest stable
    - The latest working version of the VCO is this: (commit: https://github.com/shmoergh/moduleur/tree/b8f2f3887ee0ce40083da4d1238f04f5c6e473fa). Somewhere
    between January 24 and May 24 the PCB got corrupted and it doesn't work properly. It could be the KiCAD 10 migration.
    [bom.csv, designators.csv, positions.csv, power.kicad_sch, raw-oscillator.kicad_sch, sub+noise.kicad_sch, vco-core-full-bom.csv, vco-core.kicad_pcb]
2026-05-24 Fix: Replace generic MMBT3906 with ON Semi for Q2
    Q2 is the actuator in the master current servo loop (U1B → Q2) that sets the tail current for the exponential converter. The previous BOM specified the generic LCSC part C7420354, which JLCPCB silently substituted between production batches: batch 1 (Jan 2026) received a working part, while batches 2 and 3 received Zhuhai Hongjiacheng (R+O) MMBT3906 parts under the same C-code.
    The R+O datasheet only characterizes hFE at IC = −10 mA and above, with no minimum specified at low collector currents. The circuit operates Q2 at sub-milliamp currents, where the substituted part has insufficient gain to close the servo loop. U1B saturates agains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
    [bom.csv, designators.csv, positions.csv, power.kicad_sch, raw-oscillator.kicad_sch, sub+noise.kicad_sch, vco-core-full-bom.csv, vco-core.kicad_pcb]
2026-05-24 Added FIXLOG to VCO core board
2026-05-24 Fixed Q2 footprint pin numbering
    Previous production used the SMD MMBT3906 with traces routed to the wrong pads, leaving the transistor operating in reverse-active mode. This barely worked with some manufacturer's parts and failed entirely with others (specifically Zhuhai Hongjiacheng R+O parts in batches 2 and 3), producing a uniform pitch ceiling at ~70 Hz across all affected units.
    For further information and manual fix, refer to VCO FIXLOG in the modules folder.
    [bom.csv, positions.csv, power.kicad_sch, raw-oscillator.kicad_sch, sub+noise.kicad_sch, vco-core.kicad_pcb, vco-core.kicad_sch, waveshapers.kicad_sch]
2026-05-24 Revise FIXLOG.md with updated repair instructions
    Updated the FIXLOG.md with detailed instructions for fixing faulty boards, including tested options and additional parts information.
2026-05-25 Revise fix instructions and update images for Q2
    Updated instructions for fixing faulty boards by adding details to OPTION 2 and replacing images.
2026-05-27 Re-exported VCO Core gerbers
